walahow/IoT-Fatigue/handoff.md

# IoT-Fatigue Helmet — Session Handoff

## What Was Accomplished
* **Buzzer EMI / I2C Crash Fix**: We successfully resolved the issue where the buzzer's electromagnetic interference (EMI) crashed the MPU-6050 over the I2C bus.
* **Non-Blocking Alert State Machine**: 
  * Replaced the continuous buzzer logic in `main.cpp` with a non-blocking timed state machine.
  * **CRITICAL Alert**: Configured for `2 seconds ON` and `3 seconds OFF` (cooldown).
  * **WARNING Alert**: Configured for `1 second ON` and `3 seconds OFF` (cooldown).
  * **MPU Suspension**: The `mpu.getMotion6()` I2C read is now completely bypassed (`if (g_mpuEnabled && !g_buzzerActive)`) during the exact moments the buzzer is drawing power, guaranteeing no bus crashes.
* **Current State**: The hardware buzzer is currently deactivated in the firmware (`setBuzzerState` always writes `LOW`) so the logic and I2C stability can be tested without the alarm screaming. The firmware was successfully compiled and flashed (`esp32s3cam_sd` environment) to the board.

## Next Steps / To-Do for Next Session
1. **Physical Testing**: Run a fatigue simulation with the helmet on to verify that the MPU I2C bus no longer crashes (i.e. the system does not print `# IMU: [DISCONNECTED]` in the serial monitor).
2. **Reactivate Buzzer**: Once the I2C stability is confirmed, edit `setBuzzerState(bool active)` in `main.cpp` (around line 710) to restore the `HIGH` output so the audible alarm works again.
3. **Hardware Mitigation (Optional)**: If the software workaround feels limiting, solder a flyback diode (e.g., 1N4148) across the buzzer pins or use an NPN transistor driver to electronically isolate the buzzer's noise from the ESP32 power rails.
4. **Tune Durations**: Monitor if the 3-second cooldown duration provides enough time for the Fuzzy Logic (`Risk Score`) to drop back below 70% if the user wakes up. Adjust `COOLDOWN_DURATION` if necessary.
