walahow/IoT-Fatigue/docs/claude-handoff/lab-notebook.md

# IoT-Fatigue lab notebook (Claude memory, verbatim)

Detailed findings Claude saved across sessions, 2026-09-18 → 2026-09-25. Later paragraphs in a section supersede earlier ones. The summary lives in ../../GEMINI.md.

---

## session-101-blink-baseline

Session 101 (different rider from [[eyeglasses-sessions-102-104]], no glasses, 9.4 min, ~12 fps, 320x240): eye clearly visible at roughly x 205-295, y 25-205.

Hand labels (checked 2026-09-19), frame indices into frames/ sorted by int timestamp, window 1445-2179 (t=120-180 s): blinks at 1472, 1510, 1564, 1580, 1597, 1608, 1622, 1659, 1680, 1742, 1747, 1911, 1920, 1953, 1960, 2011, 2177 (17/min). Ambiguous/excluded: 1602, 1808, 1884 (partial), 1543, 1829 (exposure blackout). 13 of 17 show only ONE fully-closed frame.

Firmware GlintBlinkDetector logged 6 blinks for the whole session (only 18 glint-gap candidates; MIN_ABSENT_FRAMES=2 also fights 1-frame closures).
Hand-crafted PC cues (dark fraction, template diff, contrast) topped out ~9/17 recall.
HOG (32x64, OpenCV) + linear SVM via cv2.ml, 4-fold contiguous-time CV: 16/17, 0 FP. Applied to rest of session: 18.5/min, but spot check of 24 detections ~70% real; false positives = squints (narrowed eye) and a helmet adjustment. Prototype scripts were in session scratchpad only (not committed).

Full-session hand labels (2026-09-19) saved in sessions/session_101/blink_labels.csv (timestamp_ms, frame_idx, state = open/closed/squint/unsure): 71 blinks, 557 unsure frames (dark exposure, hand adjustments, half-closures). Labels were corrected once after reviewing SVM disagreements (both FPs and misses), which biases scores toward the model. 5-fold contiguous CV at th=0.5: 93% recall / 97% precision after correction (84%/81% before). But 17 detections fire inside the 0.77 min of unsure footage, so deployment needs a brightness/disruption gate.

Firmware port (2026-09-19, uncommitted at time of writing): HogBlinkDetector + hogFeatures/boxResample/hogCropRect in src/EyeBlinkEAR.h (8 native tests), session_replay --hog-dump/--hog-model/--hog-csv, python/train_blink_classifier.py (end-to-end CV through session_replay). Plain C HOG (no histogram equalisation, (R+G+B)/3 gray) on 101: threshold 0.25 -> 91% recall / 89% precision held-out; model at sessions/session_101/blink_model.bin. Wired into main.cpp the same day: runs alongside glint, prints "#STATUS: blink (hog) t= score=", did not drive blink_rate at first -- SINCE 2026-09-21 it DOES (g_earHogRate 60 s window -> g_onDeviceBlinkRate; glint kept as log-only comparison). Weights in firmware/src/BlinkWeights.h (generated by train script). frame_inject_replay.py got --hog-out. All esp32 envs build. Of 17 events in unsure footage ~9 were real partial closures, ~5 junk; whole-frame brightness does NOT separate them, so no gate built.

Recording simulation (2026-09-19): tools/session_replay/sensor_sim.cpp runs the 1 Hz loop (baseline HR + FuzzyFatigue.h) on recorded sensor rows; reproduces session_101's recorded risk/alert on 550/552 rows with --baseline=86 (ESP baseline forms during arming). Recorded 101: blink_rate 0-1 all ride -> CRIT 245 s / WARN 76 s. With classifier (ROI pinned 254,126): blink 9.5/min, SAFE/W/C 155/270/127; with hand labels 131/299/122 -> classifier ~equals perfect detection. Remaining alerts come from rider's real riding blink rate ~7/min (FIS "Low" < 8), nod_score>0 in 231/492 s, HR below arming baseline -- FIS calibration is the next bottleneck, not blink detection.

Measured on real ESP32-S3 (N16R8 devkit, no camera, frame-inject build, 2026-09-20): HOG classifier 7.7 ms/frame median (p90 7.9); decode+EAR 61.6 ms median. Motion lock landed at x=230 y=102, identical to PC replay. Device found all 8 PC blinks in the first 500 frames at identical timestamps, plus 2 extra in dark "unsure" frames; per-frame scores differ from PC by up to 0.52 (different JPEG decoder: esp_jpg vs stb_image), so near-threshold frames can flip. Full-session device run (6834 frames, 31 min): device caught 69/70 labelled blinks with 5 false alarms — identical to the PC replay's own score; 84 detections on identical frames, 10 device-only, 7 PC-only (mostly in unsure footage). NOTE that 99% is in-sample (weights trained on this session); held-out CV remains 91%/89%. Results kept in sessions/session_101/blink_classifier/esp32_hog_blinks.csv. Frame injection needed Serial.setRxBufferSize(16384) before Serial.begin() under FRAME_INJECT_MODE (default 256 B CDC buffer dropped mid-frame bytes) and chunked host writes; frame_inject_replay.py used PIL (not in requirements) -> switched to cv2.

Stored eye coordinate (2026-09-20, user's idea): PC picks the eye centre, firmware keeps it in NVS and applies it on frame 1 instead of the ~20 s motion search. Serial `ROI:<cx>,<cy>` / `ROI:auto`; precedence EAR_ROI_MANUAL_X/Y > stored > motion lock; metadata.txt gets roi_source/roi_x/roi_y/roi_size. Set by clicking the eye in live_ear_preview.py --arm. Verified on the bare S3: coordinate survived a reflash to a different build, applied as x=230 y=102 (same spot motion lock found), and detected the one labelled blink in the first 150 frames (frame 95) which the motion path would have missed.

**Why:** user wants consistent PC-side blink detection before worrying about ESP32 fit.
**How to apply:** next lever is more labels (~5 min incl. squint negatives) and per-rider calibration; HOG+linear SVM is also cheap enough (~756-dim dot product) for ESP32 later.

---

## eyeglasses-sessions-102-104

Sessions 102-104 (recorded ~2026-09, outdoor ride) — rider wears eyeglasses. Camera looks *through* the lens from below/outside: lens rim crosses the frame, eye is a blurry ~60x60 px patch in the top-right of a 320x240 frame (metadata claims 640x480 but video.mjpeg is 320x240), overlaid by blue sky reflection. On-device detector logged 22/16/12 blinks over whole sessions (~100x too few).

Checked 2026-09-19: strongest blink-shaped events in the eye ROI (red-minus-blue spikes) were reflection/camera shifts, not eyelids. Conclusion given to user: no PC algorithm can recover it; fix is hardware — camera between lens and eye (not through lens), refocus the OV2640 lens for close range, 850/940 nm IR LED + NoIR sensor + IR-pass filter (kills visible sky reflections, like car driver-monitoring cameras). Then a small CNN open/closed classifier on eye crops (MediaPipe won't work: needs a full face).

**Why:** user asked whether PC-powered processing could fix blink detection for eyeglass wearers.
**How to apply:** if blink work resumes on glasses footage, check the new mount's frames first; don't tune thresholds on 102-104 footage.

---

## alert-labels-sessions-101-104

Checked 2026-09-21. In all four sessions the recorded alert is fully explained by two inputs, not by fatigue:
- blink_rate==0 & nod==0 -> risk 0 / SAFE (97-100% of rows); blink_rate==0 & nod>0 -> CRITICAL (97-100%); blink_rate>0 & nod==0 -> WARNING 50 (74-88%).
- Root cause: `mf_blink_Low` = `_ftrap(v, 0,0,4,8)` and `_ftrap` returns 0 for `x <= a`, so blink=0 gives Blink_Low=0 (blink=0.01 gives 1.0). No rule fires -> centroid fallback risk 0. Same boundary in python/fuzzy_model.py. The rolling rate is integer-valued and ~0 (detector misses ~all blinks), so it sits on the hole. Other left-shoulder MFs (hr_Dropped) use -1e9 and are fine; gyro_Stable(0) has the same latent issue.
- nod_score>0 in ~50% of rows in every session (incl. no-glasses 101): ZCR is easy to hit on riding jitter, slope>0 gate is a coin flip; R3 maps nod straight to Critical. 324-414 CRITICAL onsets/hour (buzzer every ~10 s).
- Session 104 vs self-report ground truth (sessions/session_104_ground_truth.xlsx, 3 blocks 0-10/10-20/20+ min): Critical share 49/40/36% (falls as fatigue "rises"), non-safe 65/71/70%, HR flat ~81, blink mean 0.18/0.37/0.46 — alerts do not track phase.
- 103 was armed_eye=0 yet blink_rate is nonzero ~55% of rows -> those counts are not blinks.

FIXED 2026-09-21 (uncommitted): blink_Low left edge -> -1e9 in FuzzyFatigue.h and -1e6 in fuzzy_model.py; Python and C++ (sensor_sim on 104) agree. Effect on 104: SAFE/WARN/CRIT 0/1524/314 s (was 578 safe) -> a dead blink detector now means permanent Warning, so blink input needs an "unreliable/unknown" state. Agreed plan still to do: nod-detector check, then dwell gate (Warning ~5 s, Critical ~8-10 s, ~3 s release hold, ~30 s buzzer cooldown after Critical, log raw alert_level + new alert_gated column).

BLINK-UNKNOWN DONE 2026-09-21 (uncommitted, all firmware envs build): FuzzyFatigue::update(..., bool blink_valid=true) zeroes bL/bN/bH so R1,R2,R4,R6,R7 drop out (Python fuzzy_model.py same). main.cpp computes g_blinkValid = PC-fed BLINK: OR (SD/EAR_LIVE_DEBUG: !g_earDisabled && >=60 s since first frame after ROI lock (g_earValidSinceMs) && frame within 3 s (g_earLastFrameMs)); prints "#STATUS: Blink channel OFFLINE -- reason" on change; new trailing CSV column blink_valid (19th; older sessions NaN/unknown, handled in merge_session.py, label_session.py, session_review_video.py, sensor_sim.cpp, README). Plain USB mode without BLINK: feed keeps the 13.0 stub and counts as valid. Replay of 101-104 with blink offline: Safe ~46-50%, Critical 45-53% (all nod-driven R3) -> nod detector is the next fix. Limits: glasses sessions 102-104 would be offline only ~4-12% (glint baseline forms at 22-81 s, glare looks like glint); 101 offline ~60% (baseline only at 278 s). session_summary.py not updated (its COLS length gates row parsing). Native tests: 2 glint tests fail (test_glint_blink_counted_on_recovery, ..._rolling_rate_evicts_old_blinks) — in EyeBlinkEAR WIP, not from this change.

HOG DRIVES blink_rate 2026-09-21 (option 1; uncommitted, 5 firmware envs build, not yet run on hardware): main.cpp processEarFrame pushes g_earHog events into g_earHogRate (BlinkRateWindow) -> g_onDeviceBlinkRate; glint only logs; armingBegin clears the window. PC replay of sessions 101-104 with the session_101 model (motion lock) + 60 s gate + fuzzy model: 101 = 9.6 blinks/min, alerts S/W/C 30/46/24; glasses sessions collapse: 102 0.8/min (3/92/5), 103 0.6/min (6/65/29), 104 2.8/min (8/76/16) -> blink_valid stays 1 (~91-96%) so glasses riders sit in permanent Warning. Proposed, not built: arming-time blink-count check (expect a handful of blinks in the ~20-60 s arming window, else mark the channel unreliable for the session) + per-rider labels/weights.

ROUND 3 DONE 2026-09-21 (uncommitted; 5 firmware envs build; native: test_nod_alert 18/18 pass; 2 glint tests in test_eye_blink_ear fail, pre-existing): (1) Option A arming eye check in main.cpp: EyeCheck PENDING/PASS/FAIL, PASS = >=3 classifier blinks within 30 s of ROI lock, FAIL latches for the session -> blink_valid=0; arming waits until it resolves (pass OR fail); metadata eye_check + eye_check_blinks; #ARMING line shows blinks x/3. Session data: 101 = 12 blinks/30 s (pass), 102/103/104 = 0/0/2 (fail). (2) NodDetector moved to src/NodDetector.h and rewritten: swing >=10 deg, Schmitt band = swing/4, >=3 alternations (one glance = 2), score=min(alt/6,1), slope gate removed. Evidence: old score fired ~50% regardless of swing size (pitch is from the accelerometer so vibration/bumps look like swing; slope sign random; any non-zero nod = Critical because the Critical centroid ignores clip height). UNVALIDATED on real nods: all recorded sessions are 1 Hz and have no labelled nods; needs a deliberate-nod recording. (3) src/AlertGate.h: Warning dwell 5 s, Critical 8 s, release hold 3 s; buzzer follows g_alertGated; Critical beep -> 30 s cooldown (Warning 3 s); CSV col 20 alert_gated (alert_level stays raw); sensor_sim/merge_session/label_session/session_review_video/README updated. Replay 101-104 (HOG blink + eye check + gate): with nod silent, glasses sessions ~98-100% Safe; 101 gated 60/40/1; with the OLD recorded nod, gated Critical still 16-18% on glasses sessions. Remaining: real-nod validation, FIS blink Low (<8) vs riding blink rate ~7/min in 101 (40% Warning), per-rider blink weights.

ROUND 4 DONE 2026-09-21 (uncommitted; 5 envs build; native 55/57 pass, same 2 pre-existing glint failures): blink Low. Findings: session_101 hand-labelled truth = 71 blinks / 9.4 min = 7.5/min, per-minute 15,6,17,5,4,8,10,2,2; rolling-60s count <8 for 56% of the time, <4 for 32%; Poisson noise alone makes a true-9/min rider read <8 in 32% of 60 s windows. Doc sources: IICIP 2016 driving baseline 8-10/min, fatigued 4-6; Divjak 18 vs 8. Old Low MF (0,0,4,8) hit zero exactly at the alert driving baseline. Changes: (1) device blink_rate = 3-min smoothed rate (BlinkRateWindow::smoothedBpm, window = elapsed since lock, floor 60 s; buffer 60->128 timestamps, old cap made rate <=20/min); (2) Low MF -> (-inf,-inf,3,7) in FuzzyFatigue.h + fuzzy_model.py + fuzzy_walkthrough.md. Replay 101 (HOG blinks, nod silent, after 60 s): window 60->180 s took Warning 45%->16%; MF change alone is small (+2 pts Safe); Low 2-5 broke the doc scenario Ph4 so rejected; 7-phase scenario unchanged (0,1,0,1,2,2,0). Caveat: rider 101 truly blinks ~7.5/min riding, i.e. inside the literature fatigued band, so an absolute threshold cannot fit them; needs fatigue-labelled blink data and/or a per-rider baseline (literature quotes relative drops of 40-56%). R6/High is diluted by the 3-min average.

HARDWARE TEST 2026-09-21 (esp32s3cam_sd flashed to the full helmet on COM3; session_109 = unattended junk, session_110 = live test, both on the SD card): arming worked end to end -- motion lock in ~20 s (x=194 y=110 conf 2.54), Eye check PASSED at 18 s after lock (3 blinks), Blink channel ONLINE at lock+60 s, recording started at 38 s (timed_out=0), gate turned 29 raw non-safe seconds into 6 gated. HOG counted 14 blinks in 110 s (7.6/min, screen-viewing rider), glint 4. New nod detector: 1 of 153 ticks non-zero (seated). Problems found: (a) HR baseline (96.6 BPM) formed from the first 20 valid samples while the pulse settled 119->78, so later 75-95 BPM read as -10..-22% = HR Dropped -> R2 raw Critical; (b) FIS output ignores rule strength: R2 at Low=0.15 still gave risk 85 (clipped shoulder centroid) -> needs an alpha-cut (min firing strength ~0.2-0.25) or different defuzzification; (c) pulse readings jump 72-119 (contact). SD contents (metadata eye_check, CSV cols 19/20) NOT yet inspected.

ROUND 5 DONE 2026-09-21 (uncommitted; 5 envs build; native 66/68, same 2 pre-existing glint failures; new tests/test_fis_hr 11 pass; NOT yet flashed): (1) src/HrBaseline.h: baseline = median of 20 valid readings after skipping the first 10 (needs 30 valid s; #ARMING hr=(n/30)); replaces mean of first 20. A "wait until readings agree" gate was rejected: recorded worn sessions 101-104 have a median 20 s HR spread of 21-28 BPM, same as the unworn test (27) -> it would never open; also means the recorded HR channel looks noise-dominated (needs raw-PPG/ECG check). (2) FIS alpha-cut: rules below 0.25 firing strength count as not firing (FIS_MIN_FIRING in FuzzyFatigue.h, MIN_FIRING in fuzzy_model.py); all-cut -> existing Safe fallback. Hardware-log replay (sensor unworn, HR = noise): raw alerts after blink online Safe/Warn/Crit 56/12/6 -> 73/0/1 (the 1 = nod 0.5). Findings: user forgot to wear the HR sensor during session_110; firmware still produced "valid" 72-119 BPM and formed a baseline -- floating ADC passes the SIGNAL_LOW/HIGH window and MIN_AMPLITUDE=20; a real loose-contact moment would give phantom HR. Not fixed (needs bench data on real PPG amplitude vs noise floor).

HARDWARE TEST 2 2026-09-21 (round-5 firmware + blink_events.csv flashed; session_112 on the SD, sensor worn this time): motion lock x=202 y=130 conf 2.00 (borderline; test 1 was 194,110 conf 2.54), 0 HOG and 0 glint blinks in 225 s, Eye check FAILED (0 blinks in 30 s) -> blink channel offline all session, arming timed out at 61 s with hr=0. HR: 30 valid readings needed, only 149/228 ticks valid (34-92 BPM, many dropouts), baseline formed AFTER recording started at 55.4 BPM (too low: later 76-89 BPM read +38..+61%) -> HR contact/placement still poor even when worn. Gate worked (1 raw Critical from nod 0.5 -> gated safe). Unknown why no blinks (eye not toward camera / camera moved / bad ROI); SD card not yet read (need blink_events.csv, metadata, frames).

PREVIEW TEST 2026-09-21 (esp32s3cam_ear_preview flashed, live_ear_preview.py --arm, user clicked the eye repeatedly, ~4.5 min): eye ROI at cx=199 cy=150 (stored x=175 y=126) gave READY TO RECORD (blink test 14 of 10, exposure 60, 1 false alarm) but crop margin 0 px; cy=152 -> crop margin -2 px (90x180 classifier crop hangs off the bottom of the 240-px frame) and blink test 6 of 10 -> the eye sits too LOW in the frame; aim the camera so the eye centre is ~y 100-130 (session 101 pinned ROI was 254,126). Wrong clicks (x~105-138, y 37-109) gave exposure 29 / 4 of 10. User pressed A at the end -> stored ROI CLEARED (ROI:auto), board still has the preview firmware. HR: value 118 repeated for 11 s = 8-beat average interval ~508 ms = MIN_BEAT_INTERVAL (500 ms) refractory limit -> beat detector was noise-triggered; baseline formed at 114.4 from that, true resting ~65-75. Small bug: ROI:auto / ROI:x,y do not reset g_earValidSinceMs / g_earBlinksSinceLock / g_eyeCheck, so OFFLINE says "no frames processed" instead of "no eye lock" and the eye check does not restart.

HARDWARE TEST 3 2026-09-21 (round-5 SD firmware, no preview running, stored ROI still cleared from the previous preview test): session_114, 235 s. Both readiness checks failed: IMU calib never completed the whole session (needs 200 consecutive still samples = 2 s with |A| in 0.85-1.15g and gyro within 20 dps of its running mean; rider was moving/adjusting the whole time) -> "Recording -- imu=0" (falls back to the boot-time gravity vector, so pitch/gyro_var are not garbage, just not per-session). Eye motion lock only succeeded once, at t=224s (i.e. during RECORDING, 11 s before the session ended, not during the 60 s arming window), landing at y=155 -- too low again (same finding as the preview test), conf=1.73 (below the 2.0 accept bar, took it via the 13-try fallback). Zero blink events (hog or glint) the entire session -> Eye check never resolved, blink channel offline throughout. HR baseline DID form well this time: 72.7 BPM, plausible resting rate, 30/30 valid readings -- the HrBaseline fix looks right when contact is good. Conclusion: needs the stored ROI (via live_ear_preview.py --arm, not yet redone since it was cleared) before another SD-only arming attempt is worth running, and the rider needs to hold genuinely still for ~2 s during arming for IMU to lock.

HARDWARE TEST 4 2026-09-21 (stored ROI x=195,y=124 set via live_ear_preview.py --arm, READY TO RECORD both runs; then esp32s3cam_sd reflashed): session_115, 235 s -- everything mechanical worked. ROI applied from frame 1 (no search). IMU calibrated cleanly, 0 motion restarts. Eye check PASSED almost instantly (3 blinks in 3 s -- rider blinked rapidly to clear it fast). HR: arming timed out at 61 s with hr=0 (needs 30 valid readings, contact was fine -- 0 "NO CONTACT" ticks all session -- just slow to accumulate); baseline formed properly DURING recording at 68.7 BPM, a believable resting rate. Blink channel: 119 classifier blinks + 6 glint blinks logged; rate spiked to 30-38/min because of the rapid blinking during the eye check, and the 3-min smoothed rate (BlinkRateWindow::smoothedBpm) took ~150 s of real time to dilute it back down past 24 (Blink_High) -- this is the smoothing working as designed on a burst at the START of the window, not a bug, but it means a fast deliberate blink burst near t=0 gives ~2.5 min of R6 Warning afterward. Gate: raw/gated tally {safe/safe:118, WARNING/WARNING:78, WARNING/safe:29 (brief raw blips under the 5s dwell), safe/WARNING:12 (brief raw dips inside the 3s release hold), CRITICAL/WARNING:1 (one raw Critical blip fell back to gated Warning, not enough for the 8s Critical dwell)} -- matches the test suite's documented behaviour exactly. Conclusion: recording pipeline (ROI/IMU/eye/blink/HR/gate) is now working end to end; remaining known gaps are the nod detector (still unvalidated) and per-rider blink calibration.

SESSION 116 (first real ride on round-5+ firmware, 2026-09-22, sessions/session_116, 19.3 min, armed_imu=1 armed_hr=0(timed out, formed later) armed_eye=1 eye_check=pass roi_source=stored 195,124): contact 100%, imu_valid/blink_valid 100% throughout (blink warms up during arming now that the ROI is stored, so the recorded CSV -- which only starts at RECORDING -- sees it already online). blink_rate opened at ~25/min (arming-blink burst, same artifact as hardware test 4) and decayed over ~8 min to a 5-9/min riding baseline, dropping to 2-4/min in the final ~2 min (unclear if real fatigue or ride ending / helmet coming off -- no video check done). 166 blink events (156 hog/10 glint). HR mostly 62-91 BPM/min-median but one whole minute (~t300-360s) medianed 49 and 4 rows read 30-37 -- looks like a sensor-contact wobble, not physiological. Raw alert Safe/Warn/Crit 41/42/18%; gated 51/44/5.4% -- gate cut Critical from 18% to 5.4% as designed. CONCRETE NEW EVIDENCE the nod detector still false-positives on road bumps, not just big swings: at t=254-256 gyro_var hit 2500-4000 (a clear bump) and nod_score hit 1.0 in the same window; several other gated-Critical clusters (t=739-752, 87-91) show nod_score>=0.5 coincident with gyro_var in the hundreds-to-thousands. The Schmitt-trigger alternation the redesigned NodDetector counts is apparently still tripped by a sharp bump's pitch transient, not just by real head-drop. Next tuning step: gate nod_score on gyro_var being LOW (analogous to limp_drowsy already requiring gyro_Stable) so a bump can't masquerade as a nod.

GYRO-GATED NOD FIX DONE 2026-09-22 (uncommitted, 5 firmware envs build, native test_fis_hr still passes, same 2 pre-existing glint failures): FuzzyFatigue.h/fuzzy_model.py -- nod_trusted = min(nodding_score, gyro_Stable), IMU_Drowsy = max(limp_drowsy, nod_trusted) [was raw nodding_score]. Same gate limp_drowsy already used. Verified on session_116 with sensor_sim: the two bump clusters caught on video (t=254-256s gyro_var 2500-4000, t=1039-1050s gyro_var 900-3400) both fully flip from gated Critical -> gated Safe; session-wide raw Critical seconds 202->164 (-19%), gated Critical 61->43 (-30%), other levels roughly unchanged. Not yet flashed/hardware-tested. Caveat: gyro_Stable ramps 400-800, so a MODERATE bump (gyro_var 400-800) only partially discounts nod (e.g. the t=1136 cluster at gyro_var~550 -> gS~0.6, not fully gated) -- expected, matches limp_drowsy's existing behavior, not a new gap.

VIDEO REVIEW TOOLING 2026-09-22: unpack_session.py works on session_116 (12665/12665 frames, 0 CRC fails). Found and fixed a real bug in python/frames_to_mp4.py: the avc1->mp4v codec fallback (line ~340) opened the fallback VideoWriter at (out_w,out_h) while every write() call sends (out_w, out_h+hud_h) when --overlay-data is on -- silent frame-size mismatch, produces a corrupt/empty file. Fixed to size the fallback writer the same as the first attempt. This environment has no working avc1/OpenH264, so `--codec mp4v` must be passed explicitly (the auto-fallback path works now too, but avoid the wasted first attempt). Also: frames_to_mp4.py's load_session_data() does plain pd.read_csv() on sensor_data.csv with no header= -- headerless SD sessions need a dataset_merged.csv (or headered copy) written first, or the HUD reads garbage column names silently.

MOTION-BASED DRIFT CORRECTION BUILT 2026-09-22 (uncommitted; all 5 firmware envs + -DEAR_PROFILE build succeed; native tests unaffected, same 2 pre-existing glint failures): main.cpp earDriftTick(), replacing the disabled Otsu/centroid drift check. Design: reuses EyeBlinkEAR::MotionLocator (the SAME motion-energy boot-lock algorithm, already validated) scoped to a small window (ROI+30px margin, 108x108) instead of the whole frame, plus the v4 glint-refine scratch buffers -- both idle once g_earLockDone, so net new static memory is one uint8_t enum (EarDriftState), not a second ~28.8KB locator instance. Also DELETED g_earMaskBuf, a 320x240=76.8KB PSRAM buffer that was only ever used by the old drift check and had become dead weight. Cycle: reset+accumulate every processed frame for one EAR_V3_WINDOW_MS (18s, reused unchanged from the boot lock) window; on completion, apply the correction ONLY if confidence >= EAR_MOTION_MIN_CONF (2.0, also reused), else discard and start a fresh cycle -- an unconfident cycle now leaves the ROI alone instead of the old code's "darkness always finds something" behaviour. Logs "#STATUS: EAR drift corrected x=.. y=.. conf=.." on change. Added drift= to both #PROF (SD/USB, 40-frame batched) and #FRAME_DONE (frame-inject, per-frame) profiling lines (g_earProfDriftUs) so the added per-frame cost (drift now runs continuously, not once per session like the boot lock) is measurable on real hardware, not just assumed -- NOT YET MEASURED. Found prior art while investigating: .worktrees/on-device-blink-detection (an older, still-checked-out branch) has an abandoned burst-median+two-candidate-agreement variant of the SAME darkness-based approach (session_replay.cpp only, never reached main.cpp) -- shares the same root flaw (hair is MORE stable than a blinking eye, so agreement-based filtering favours hair, not against it); not reused. CLAUDE.md's Known Limitations table and Next Steps checklist updated to match. UNVALIDATED end-to-end: no ride has been recorded with this code running yet -- next hardware step is exactly that, then check "#STATUS: EAR drift corrected" lines against the video the way session_116 was checked by hand, and an -DEAR_PROFILE build's drift= timing.

DRIFT CORRECTION VALIDATED AGAINST REAL FOOTAGE 2026-09-22 (host tool tools/session_replay/drift_test.cpp, new file, transcribed from main.cpp's earDriftTick -- NOT session_replay.cpp itself, whose own boot-lock/drift code had already drifted out of sync with main.cpp and was left alone rather than reconciled): ran the new drift logic starting from session_116's real stored ROI (195,124,48) across all 12665 real extracted frames, no live hardware needed. Result: 63 x 18s cycles, 6 corrections, 57 "not confident" (left alone, matches the fail-safe design). Trajectory: 18s->(219,146), 236s->(212,134), 400s->(212,125), 708s->(231,102), 1089s->(219,84), 1107s->(227,81) -- this tracks the SAME rightward/upward drift found by hand earlier, arriving at x~227-231 right around t~700-810s, matching the t=810s frame where the fixed box was found visually wrong. Drew both boxes on the real t=810s frame: old fixed box (174,58,90,180) covers only the left half of the eye (matches the user's screenshot complaint); new corrected box (210,36,90,180, from roi 231,102) covers the eye properly. This is the strongest evidence yet that earDriftTick() does what it was built for. Still not run live on hardware (no #EARDRIFT heartbeat / timing seen for real, no -DEAR_PROFILE drift= measurement taken) -- replay proves the algorithm, not the on-device execution.

DRIFT CORRECTION CONFIRMED ON REAL HARDWARE 2026-09-22 (frame injection, esp32s3cam_frame_inject flashed to the real ESP32-S3-CAM on COM3, python/frame_inject_replay.py extended to surface #EARDRIFT/drift-corrected lines and drift= timing, which it silently dropped before): fed the real chip session_116's first 2000 recorded frames (~183 s of session time) via USB, ROI seeded from the session's own stored coordinate (195,124) -- needed a firmware fix first, earLoadStoredRoi() was gated to STORAGE_MODE_SD||EAR_LIVE_DEBUG and never ran under FRAME_INJECT_MODE, so injection would have wasted the first ~18s on a fresh boot-lock search instead of testing drift from a known start; extended the guard. Result: EXACT match to the PC-side drift_test.cpp replay -- first correction 195->219, 124->146, conf=2.37, bit-for-bit identical target and confidence; 10 total 18s cycles in the 2000 frames (1 corrected, 9 not confident), same count and same single-correction pattern the PC replay showed for the same time range. HOG blinks fired at the exact same timestamps (76659, 78085, 85900, 87725...) as the original real-time recording's blink_events.csv. Zero frame errors/resyncs over 2000 frames. On-chip timing: decode+EAR median 78.4 ms p90 79.0 ms; HOG classifier median 9.0 ms; DRIFT CORRECTION median 8.7 ms p90 8.8 ms -- the number that answers "does it fit": comparable to the HOG classifier's own cost, not a dominant new expense. This is the strongest validation yet: same algorithm, same real footage, same result on PC and on the actual chip. Tooling note: frame_inject_replay.py's "ROI locked" summary field stays "no" here since it only recognizes the boot-lock's "motion-locked" message, not the stored-ROI path -- cosmetic, not fixed. Only the first ~183 s tested; the bigger correction found earlier (t=708s, roi->231,102) has NOT been confirmed on real hardware yet, only in PC replay.

CORRECTED-FIS REVIEW VIDEO 2026-09-22/23 (uncommitted artifacts, sessions/session_116/session_116_review_corrected.mp4): combined the two hardware-validated data sources with the corrected FIS math, since full on-device FIS replay of a historical session is not possible -- FRAME_INJECT_MODE only replays camera frames, loop()'s 1Hz IMU/HR/FIS path is NOT gated by it and reads whatever sensors are live on the bench at injection time, not the recording's history; there is no sensor-injection mode. Built instead: (1) blink_rate from the REAL chip-detected HOG blinks (both injection runs' hog-out CSVs combined, 201 blinks, fed to sensor_sim via --blinks=) rather than the original recording's blink_rate column; (2) HR/IMU from the session's own recorded sensor_data.csv (only available source); (3) drift-corrected ROI per frame from drift_test.cpp's PC replay (already 1px-matched to real hardware injection). Result via sensor_sim: HR baseline 86.0 (median of rows 11-30), mean blink_rate 10.7/min, gated Safe/Warn/Crit 658/441/29 s = 58.3/39.1/2.6%. Video built same way as session_116_review_newfw.mp4 (frames_to_mp4.py --overlay-data, dataset_merged.csv rebuilt) but HUD numbers are now this corrected/chip-blink run, not the original firmware's recorded values.

**Why:** user asked to look at the alert/warning/critical labels of 101-104.
**How to apply:** don't treat the recorded alert column as a fatigue label or training target; fix blink_Low(0) and the nod gate (and get blink detection working, see [[eyeglasses-sessions-102-104]], [[session-101-blink-baseline]]) before judging FIS thresholds.

---

## session-116-blink-eval

Session 116 (same rider as 100 per user, no glasses, 19.3 min/12665 frames, ~10.9 fps, same mount/view as [[session-101-blink-baseline]]). Full session now hand-labelled in sessions/session_116/blink_labels.csv (label_ground_truth.py schema, every frame): 96 closed frames / 92 distinct blink events (4.8/min avg, but very bursty: 39 blinks in the first 232s, 4 in the last 232s — real variation, not a labeling artifact, spot-checked with continuous frame sequences), 605 unsure (long occlusions/closures >~500ms, glare, hair-strand crossing, exposure dropouts — excluded from training). Labelled via a transient-score candidate detector (`transient.py`: local self-vs-neighbour-median dissimilarity) + visual confirmation on 7-frame strips, zoom-verified per cluster. Lesson: a compressed 20-wide frame grid causes real misreads (columns get miscounted) — always verify at 7-wide or narrower before calling a frame closed.

**Jitter augmentation shipped** (2026-09-23): `session_replay.cpp --hog-jitter=N,J` dumps N extra HOG-feature copies per labelled frame from the ROI shifted by a random ±J px offset (deterministic per-frame seed), alongside the original. `train_blink_classifier.py --jitter-n/--jitter-px` (default 4,16) passes this through to the `--hog-dump` call powering training; CV/eval paths are untouched. `firmware/src/BlinkWeights.h` regenerated on session_101 alone with jitter on (CV: 61/70 caught, 15 FA, precision 80% @ threshold +0.50). Verified via the real C++ replay (not just the python port) against 116's 3 originally-hand-labelled windows: 17/28 blinks caught at 2.7 FA/min at the drift-tracked box, vs. the pre-jitter shipped model's 12/28 at 4.6 FA/min.

**Naive full-116 pooling makes it WORSE, not better** — tested by 5-fold contiguous CV on all of 116, training each fold on 101(jittered) + the other 4/5 of 116(jittered) vs. 101(jittered) alone:
- 101+jitter only: 39/92 caught (42%), 109 FA (5.7/min)
- +116 other-folds: 15/92 caught (16%), 209 FA (10.8/min) — per-fold breakdown shows near-total collapse (0/23, 0/13, 0/13 caught in three folds) with huge FA spikes elsewhere (81, 98)
- Root cause (not verified beyond this reasoning, no fix attempted): 116's usable frames (~12060, 96 closed ≈ 0.8%) dwarf 101's (~6579, 70 closed ≈ 1.1%) once pooled — the combined set becomes dominated by 116's own appearance statistics, which include long dark/glare/hair-occlusion stretches 101 doesn't have, and the classWeights ratio (1:20, tuned for 101's proportions) isn't retuned for the new mix. This directly contradicts the smaller-scale earlier result (see below) where adding only ~1600 frames from 2 clean/dense-blink 116 windows DID help (12→19-21/28) — that subset was too small and too clean to swamp 101's signal the way the full session does.
- Retuning classWeights to the pooled set's actual pos:neg ratio (instead of the hardcoded 1:20) was tested and does NOT fix it (15/92, 208 FA either way) — ruling out plain class imbalance as the cause. The collapse is near-total in some folds (0/23, 0/13, 0/13) even where the held-out fold is mostly clean/bright footage (fold 1 ≈ segment 3), so it isn't simply "bad segments poison the pool" either. Reads as a linear-SVM-over-pooled-HOG instability (two sessions' feature distributions fighting the same low-C=0.1 hyperplane), not a one-line fix. Not investigated further: per-condition/segment-only training subsets, higher C, a non-linear classifier.
- Conclusion for now: don't re-attempt naive 101+116 pooling without a real plan for the distribution mismatch. If more data is wanted, prefer collecting additional CLEAN sessions shot like 101 (stable mount, decent light) over trying to fold in 116's heterogeneous footage. A good chunk of 116's difficulty (dark/tunnel-like stretches, glare, hair crossing the lens) is an optics/lighting problem the classifier can't train its way out of — same conclusion as [[eyeglasses-sessions-102-104]] for a different reason.

**Why:** user asked to add jitter to the classifier and hand-label the rest of session_116.
**How to apply:** BlinkWeights.h currently ships 101-only+jitter (the validated improvement) — do NOT naively retrain on 101+full-116 without addressing the imbalance/heterogeneity first, it regresses. If pursuing 116 data next, balance/curate before pooling, and validate the same way (5-fold contiguous CV on held-out 116, real C++ replay for the final check).

---

## same-rider-sessions-101-119-122

Sessions 101, 119, 121, 122 are the same rider (user told me 2026-09-25); only the camera positioning differs a little. 121+122 same day (2026-09-25), 119 the day before, same setup. Sessions 102-104 are the eyeglasses sessions ([[eyeglasses-sessions-102-104]]).

I wrongly called 101 "a different rider" for a long stretch of the 2026-09-25 work; don't repeat that. Poor cross-session transfer (101 model on 119/121/122 ~6-30% recall, pooled 101+others worse) is a crop-alignment/positioning problem.

Key finding: HOG crops must be aligned to the eye. session_replay's own motion lock lands 40-60 px off the eye and differently per session, and the eye drifts ~15 px within a session. Fix: fatigue-helmet/python/make_roi_track.py (template-tracks the eye through a session, writes roi_track.csv; train_blink_classifier.replay() auto-uses it via session_replay --roi-track). 121-based template matches 119/121/122 (corr ~0.6-0.9, scale 1.0) but NOT 101 (corr <=0.5 at any scale) -- 101 is viewed from a different angle/offset (eye ~ (252,100) vs 121's (222,125)) and was never aligned; its old crop (centre 254,126) sits ~25 px below the eye.

Results (aligned, no jitter -- jitter hurts these sessions): pooled 119+121+122 CV F1 0.61 at threshold 1.0; leave-one-session-out F1 ~0.5-0.78. Pooled model is flashed as BlinkWeights.h (threshold 1.0). Pooled 4-session (incl. unaligned 101) F1 0.58. Rider's true blink rate ~4.6-6.6/min, already below the fuzzy model's Blink_Low (<8/min).

**Why:** blink detection quality here is dominated by consistent eye framing, not by who the rider is.
**How to apply:** when adding a session, run make_roi_track.py first; for 101 hand-pick/verify an eye centre with its own template before pooling.

---

## phone-arming-preview

> **Superseded 2026-09-24:** the phone preview was merged into `main` (via `blink-jitter-116-labels`). Later commits turn the helmet Wi-Fi off after arming (`d0bda3c5e`, `15350871a`). The Task 5 bench run below is still not done.

Branch `phone-arming-preview` (22 commits on top of `fatigue-fis-blink-fixes`), kept unmerged by the user's choice on 2026-09-23.

`esp32s3cam_sd` now runs Wi-Fi AP `HELMET-A974` with a page at 192.168.4.1. It shows the arming checklist and the camera with the ESP's eye box, and offers tap-to-set eye, an optional blink test and ARM/ABORT/STOP. Wi-Fi goes off 15 s into recording.

**Why:** the user wanted to see arming readiness on the phone instead of guessing when to start riding.

**How to apply:** before merging or recommending this branch, check whether the Task 5 bench run in `fatigue-helmet/firmware/docs/superpowers/plans/2026-09-23-phone-arming-preview.md` has been done. Its results go in the spec's "Bench results" table. The things to measure are:
- EAR frame rate with the page open (baseline ~12 fps with the page closed)
- pulse noise with Wi-Fi on vs off
- how long `stop()`/`start()` block `loop()`
- memory across rides

Related follow-ups offered as separate tasks: a cross-core EAR ROI race, and 2 glint tests failing in `test_eye_blink_ear` (these fail the same way before this branch).
