walahow/IoT-Fatigue/fatigue-helmet/python/fuzzy_fatigue_simulation.png

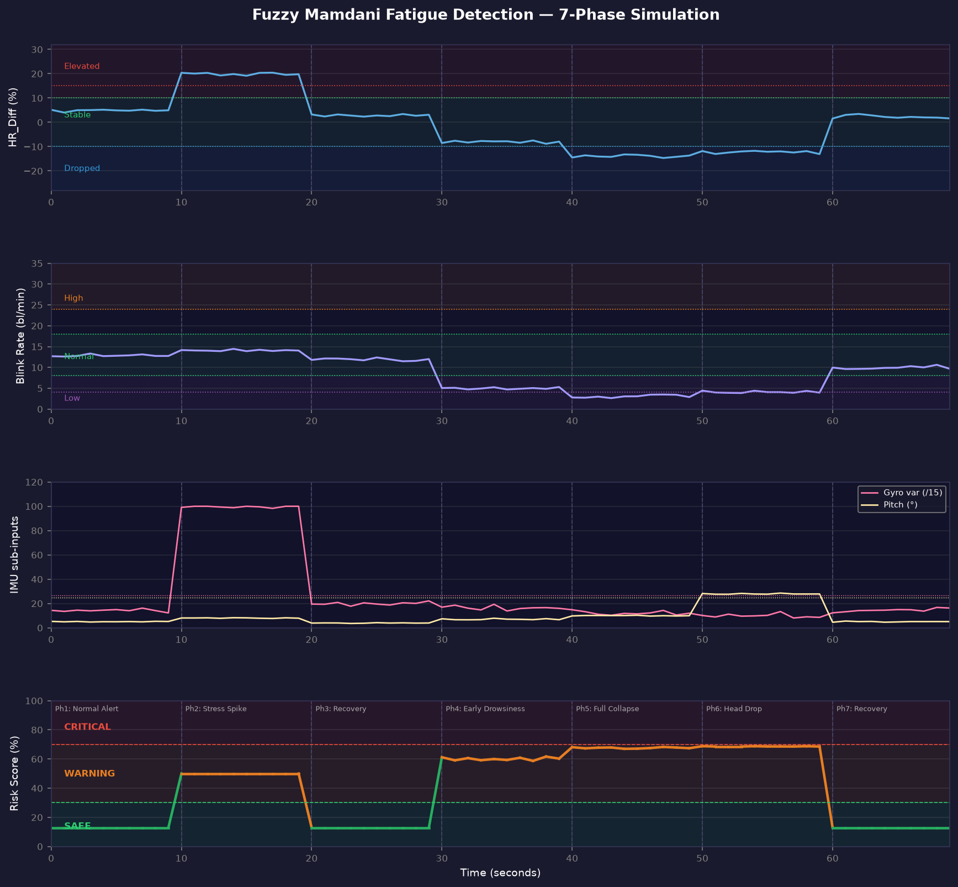
fatigue-helmet/python/fuzzy_fatigue_simulation.png
