walahow/IoT-Fatigue/3D/maybe cace.stl

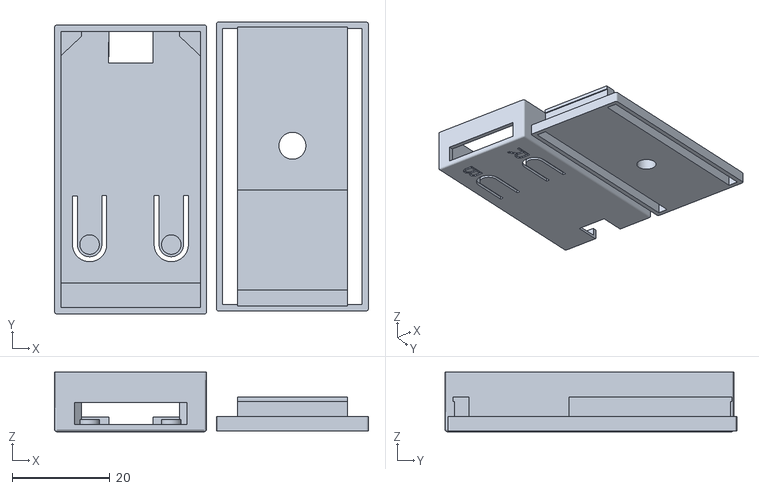
[picture p4: CAD file, 2026-06-13]
3D/maybe cace.stl
64.2 x 59.7 x 12.2
