walahow/IoT-Fatigue/3D/esp32-s3-wroom-cam-board-housing-model_files/esp32-cam-top.step

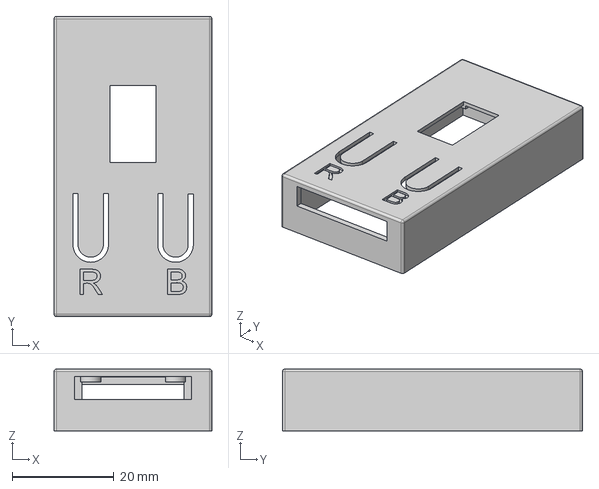
[picture p5: CAD file, 2026-06-13]
3D/esp32-s3-wroom-cam-board-housing-model_files/esp32-cam-top.step
31.1 x 59.1 x 12.2 mm
