walahow/IoT-Fatigue/3D/Untitled.stl

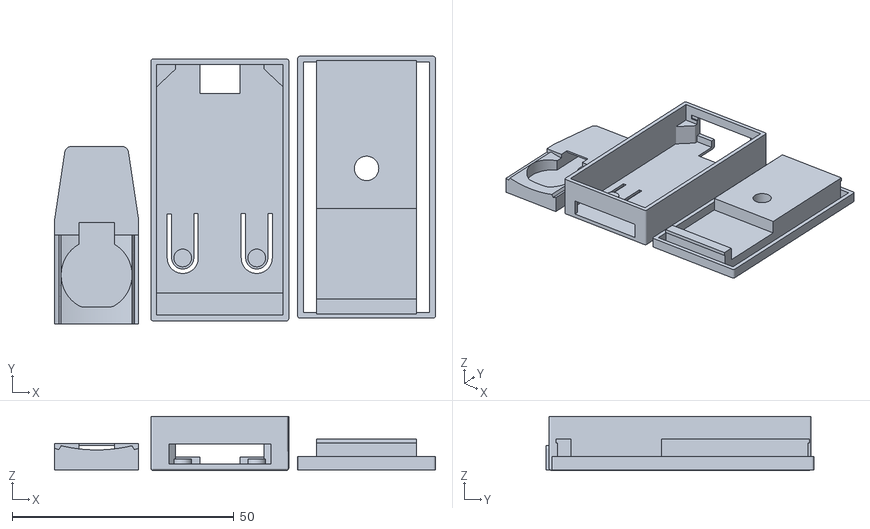
[picture p6: CAD file, 2026-06-13]
3D/Untitled.stl
85.9 x 60.4 x 12.2
