walahow/IoT-Fatigue/3D/ESP32-S3 WROOM cover V2.stl

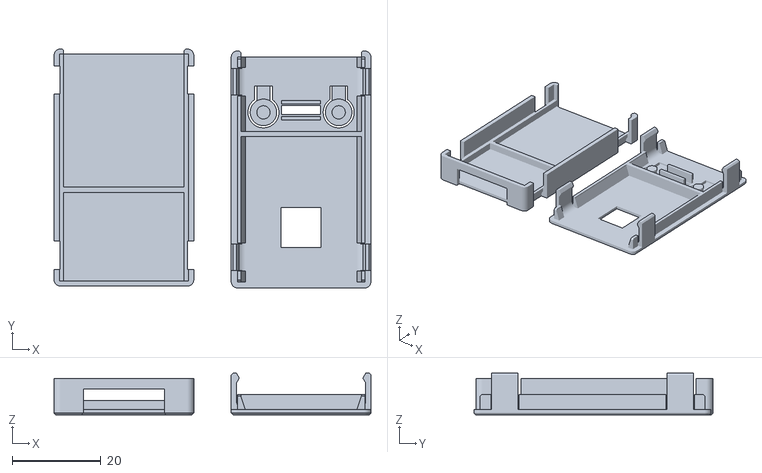
[picture p7: CAD file, 2026-06-13]
3D/ESP32-S3 WROOM cover V2.stl
71.6 x 54.0 x 9.40
