walahow/IoT-Fatigue/3D/PulSensor.stl

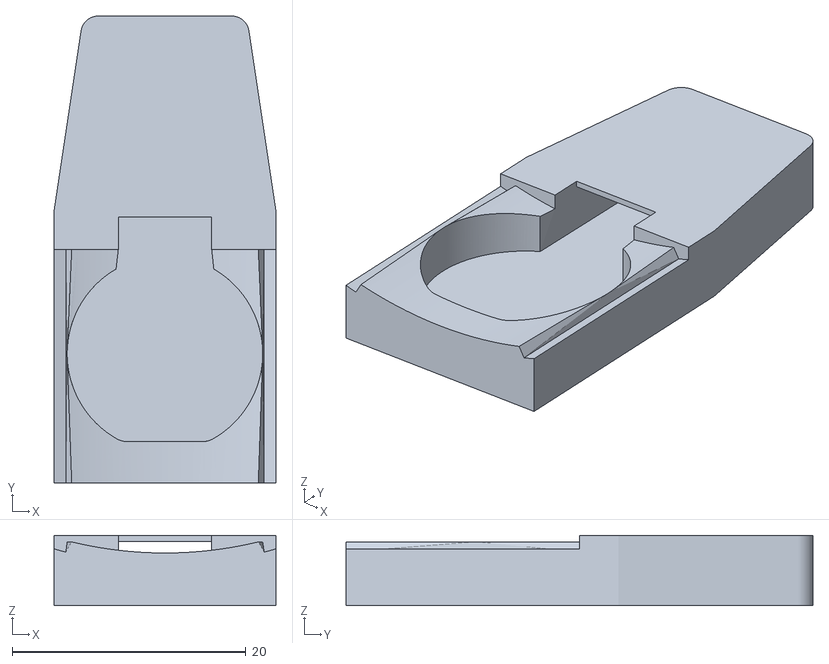
[picture p8: CAD file, 2026-06-13]
3D/PulSensor.stl
19.0 x 40.0 x 6.00
