walahow/IoT-Fatigue/(list of files, cad)

Other CAD files:
3D/Untitled.blend
3D/esp32-s3-wroom-cam-board-housing-model_files/esp32-cam-bottom.stl
3D/esp32-s3-wroom-cam-board-housing-model_files/esp32-cam-top.stl
