walahow/IoT-Fatigue/3D/esp32-s3-wroom-cam-board-housing-model_files/1244536-esp32-s3-wroom-cam-board-housing-4d0b5be8-0231-4a4d-9304-6feeb11bb0f3.pdf

## ESP32-S3-WROOM CAM Board Housing

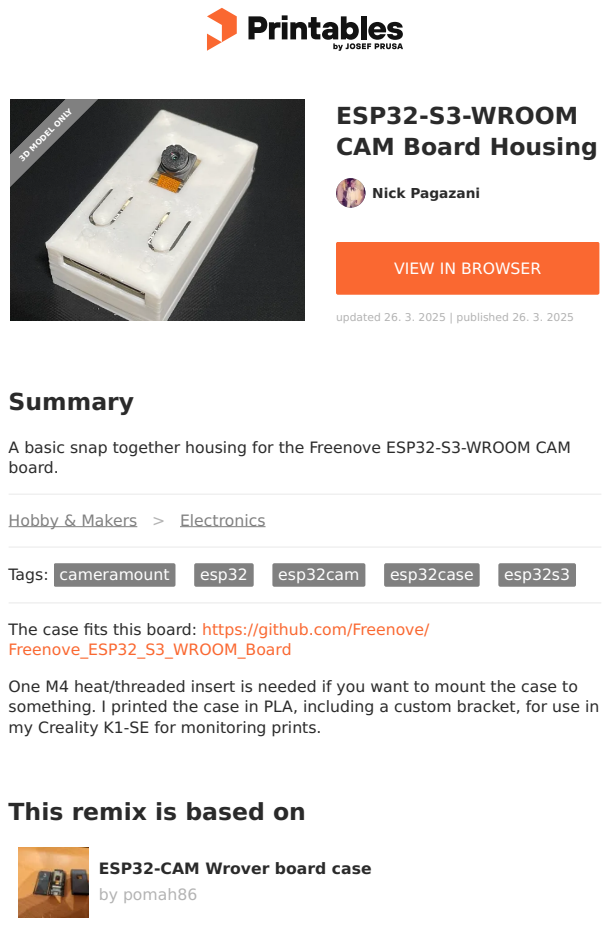
[picture p9: page 1]
Summary; Tags:; cameramount; esp32; esp32cam; esp32case; esp32s3; Nick Pagazani; updated 26. 3. 2025 | published 26. 3. 2025; 3D MODEL ONLY

VIEW IN BROWSER (https://printables.com/model/1244536-esp32-s3-wroom-cam-board-housing)

A basic snap together housing for the Freenove ESP32-S3-WROOM CAM
board.

Hobby & Makers (https://printables.com/model?categoryId=48) > Electronics (https://printables.com/model?categoryId=52)

The case fits this board: https://github.com/Freenove/
Freenove_ESP32_S3_WROOM_Board (https://github.com/Freenove/Freenove_ESP32_S3_WROOM_Board)

One M4 heat/threaded insert is needed if you want to mount the case to
something. I printed the case in PLA, including a custom bracket, for use in
my Creality K1-SE for monitoring prints.

This remix is based on

ESP32-CAM Wrover board case (https://printables.com/model/296079-esp32-cam-wrover-board-case)
by pomah86 (https://printables.com/@pomah86_252140)

## Model files

## License

This work is licensed under a
Creative Commons (4.0 International License)

Attribution-ShareAlike (http://creativecommons.org/licenses/by-sa/4.0/)

✖ | Sharing without ATTRIBUTION
✔ | Remix Culture allowed
✔ | Commercial Use
✔ | Free Cultural Works
✔ | Meets Open Definition

esp32-cam-top.stl

esp32-cam-bottom.stl

esp32-cam-top.step

esp32-cam-bottom.step
