walahow/IoT-Fatigue/fatigue-helmet/firmware/src/main.cpp

/**
 * IoT Helmet — Fatigue Detection Firmware (Phase 2)
 * Board  : ESP32-S3 (Freenove WROOM CAM)
 * Sensors: Analog Pulse Sensor @ GPIO 1 (ADC1)
 *          MPU-6050 GY-521 (Accel + Gyro) @ I2C 0x68 (SDA=2, SCL=3)
 * Camera : OV2640 (configurable via build flags, default VGA @ 20 FPS, MJPEG
 * mode)
 *
 * ── Storage modes (select via PlatformIO environment) ──────────────────────
 *
 *   STORAGE_MODE_USB  (env:esp32s3cam)
 *     Camera frames sent as binary packets over USB-UART @ 921600 baud.
 *     Run debug_recorder.py on PC to demux and save:
 *       sessions/session_XXX/sensor_data.csv
 *       sessions/session_XXX/frames/{timestamp_ms}.jpg
 *
 *   STORAGE_MODE_SD   (env:esp32s3cam_sd)
 *     Camera frames + CSV saved directly to microSD card (SD_MMC 1-bit).
 *     SD pins (Freenove ESP32-S3-WROOM CAM, do not modify):
 *       CMD = GPIO 38  |  CLK = GPIO 39  |  D0 = GPIO 40
 *     Session folder structure:
 *       sessions/session_XXX/metadata.txt
 *       sessions/session_XXX/sensor_data.csv
 *       sessions/session_XXX/video.mjpeg   ← sequential JPEG stream (30 FPS)
 *       sessions/session_XXX/video.idx     ← sidecar:
 * frame_index,timestamp_ms,byte_offset,frame_size,crc32_hex
 *
 * Binary frame protocol (USB mode only):
 *   [0xAA 0xBB 0xCC 0xDD]  4 B  magic SOF
 *   [timestamp_ms]          4 B  little-endian uint32
 *   [jpeg_length]           4 B  little-endian uint32
 *   [JPEG data]             N B
 *   [0xDD 0xCC 0xBB 0xAA]  4 B  magic EOF
 */

#include "MPU6050.h" // electroniccats/MPU6050
#include "esp_camera.h"
#include "esp_task_wdt.h"  // TWDT reset to prevent Core 1 reboot
#include "freertos/FreeRTOS.h"
#include "freertos/semphr.h"
#include "freertos/task.h"
#include <Arduino.h>
#include <stdarg.h>
#include <Wire.h>
#include <math.h>
#include "FuzzyFatigue.h"  // Mamdani FIS (heap-free, STL-free, header-only)
#include "NodDetector.h"    // nodding score from the 10 Hz pitch buffer
#include "AlertGate.h"      // dwell + release hold between the raw alert and the buzzer
#include "HrBaseline.h"     // resting HR baseline: median after a settling skip

#if defined(STORAGE_MODE_SD) || defined(EAR_LIVE_DEBUG)
#include "EyeBlinkEAR.h"        // on-device blink detection (spec section 5)
#include "BlinkWeights.h"       // HOG classifier weights, from python/train_blink_classifier.py
#include <Preferences.h>        // NVS: the stored eye coordinate (see earStoredRoi*)
#include "img_converters.h"     // fmt2rgb888() -- esp32-camera
#include "esp_heap_caps.h"      // heap_caps_malloc() / MALLOC_CAP_SPIRAM
#endif

// ── Camera resolution / FPS defaults ─────────────────────────────────────
// Override via build_flags in platformio.ini, e.g.:
//   -DCAMERA_FRAMESIZE=FRAMESIZE_VGA  -DCAMERA_FPS=20
// Supported: FRAMESIZE_QVGA (320x240), FRAMESIZE_CIF (400x296),
//            FRAMESIZE_HVGA (480x320), FRAMESIZE_VGA (640x480)
// NOTE: SD_MMC 1-bit (~3-4 MB/s) limits throughput.
//       VGA@20fps ≈ 15-25 KB/frame x 20 = 300-500 KB/s -- well within budget.
//       SVGA or higher will cause frame drops on SD writes.
#ifndef CAMERA_FRAMESIZE
#define CAMERA_FRAMESIZE FRAMESIZE_VGA
#endif
#ifndef CAMERA_FPS
#define CAMERA_FPS 20
#endif
#ifndef CAMERA_JPEG_QUALITY
#define CAMERA_JPEG_QUALITY 10  // 0=best, 63=worst
#endif

// ── SD_MMC (production mode) ─────────────────────────────────────────────
#if defined(STORAGE_MODE_SD)
#include "SD_MMC.h"
// SD card pins (Freenove ESP32-S3-WROOM CAM — do not modify)
#define SD_MMC_CMD_PIN 38
#define SD_MMC_CLK_PIN 39
#define SD_MMC_D0_PIN 40
#endif

// ── Phone arming preview (SD build, -DPHONE_PREVIEW) ─────────────────────
#if defined(PHONE_PREVIEW)
#if !defined(STORAGE_MODE_SD)
#error "PHONE_PREVIEW is for the SD build: it reports the arming state that only exists there"
#endif
#include "PhonePreview.h"
// Wi-Fi and the web server go off this long after RECORDING starts (just long
// enough for the page's next poll to show that recording began), so the radio
// and httpd stay out of the ride entirely (spec: "Wi-Fi lifecycle"). Declared
// here, not in the phoneTick block below, so openSession() can also see it.
static const uint32_t PHONE_WIFI_OFF_AFTER_MS = 3000;
#endif

// ── Camera Pins (Freenove ESP32-S3-WROOM CAM) ───────────────────────────
#define PWDN_GPIO_NUM -1
#define RESET_GPIO_NUM -1
#define XCLK_GPIO_NUM 15
#define SIOD_GPIO_NUM 4
#define SIOC_GPIO_NUM 5
#define Y9_GPIO_NUM 16
#define Y8_GPIO_NUM 17
#define Y7_GPIO_NUM 18
#define Y6_GPIO_NUM 12
#define Y5_GPIO_NUM 10
#define Y4_GPIO_NUM 8
#define Y3_GPIO_NUM 9
#define Y2_GPIO_NUM 11
#define VSYNC_GPIO_NUM 6
#define HREF_GPIO_NUM 7
#define PCLK_GPIO_NUM 13

// ── Pulse Sensor constants ────────────────────────────────────────────────
#define PULSE_PIN 1             // GPIO 1, ADC1 channel 0 on ESP32-S3
#define SAMPLE_RATE_MS 2        // 2 ms = 500 Hz sampling
#define BPM_BUFFER_SIZE 8       // beats averaged for stable BPM output
#define SIGNAL_LOW_THRESH 200   // ADC < this → likely no skin contact
#define SIGNAL_HIGH_THRESH 3900 // ADC > this → sensor saturated
#define MIN_BEAT_INTERVAL 500   // ms → 120 BPM max (prevents double-triggers)
#define MAX_BEAT_INTERVAL 2000  // ms → 30 BPM min

// ── Alert output ──────────────────────────────────────────────────────────────
// GPIO 14 confirmed free: no conflict with camera (4-18), I2C (2,3), SD (38-40),
// or pulse sensor (1). See fuzzy_walkthrough.md §7 for full GPIO audit.
#define BUZZER_PIN 14
#define MIN_AMPLITUDE 20        // min peak-to-valley swing
#define BEAT_TIMEOUT_MS 5000    // ms with no beat → reset BPM



// ── Session Control ──────────────────────────────────────────────────────────
#define BUTTON_PIN 21

// Session lifecycle. The button no longer flips recording on directly:
// pressing it ARMS the rig, which re-establishes the three things a usable
// session needs -- eye ROI lock, HR baseline, IMU calibration for the pose the
// helmet is ACTUALLY in -- and only then starts writing. Recording with any of
// those missing produces a session that cannot be used for training, which is
// the failure this state machine exists to prevent.
//
//   IDLE --press--> ARMING --all ready | timeout--> RECORDING --press--> IDLE
//                     |                                        (closeSession)
//                     +--press = abort--> IDLE
enum SessionState {
  SESSION_IDLE = 0,
  SESSION_ARMING,
  SESSION_RECORDING
};

// Give up waiting and record anyway after this long. A subsystem that never
// goes ready (eye lock in poor light, bad pulse contact) must not cost the
// whole session -- the readiness flags are written into metadata.txt instead,
// so the recording can be judged afterward rather than silently trusted.
static const uint32_t ARMING_TIMEOUT_MS = 60000;

SessionState g_sessionState = SESSION_IDLE;
uint32_t     g_armStartMs   = 0;
bool         g_armTimedOut  = false;

// Per-subsystem readiness, latched at the moment recording begins.
bool g_readyImu = false;
bool g_readyHr  = false;
bool g_readyEye = false;

// Derived from g_sessionState so the existing consumers (saveJpegToSD, the CSV
// writer, the buzzer gate) keep working unchanged.
#if defined(STORAGE_MODE_USB)
bool g_sessionActive = true;  // Start streaming immediately in USB debug mode
#else
bool g_sessionActive = false; // Start paused in SD card mode
#endif
bool g_lastButtonState = HIGH;
unsigned long g_lastDebounceTime = 0;
int g_sessionBeepState = 0;
unsigned long g_sessionBeepTimer = 0;

// ── I2C & output timing constants ────────────────────────────────────────
const uint8_t PIN_SDA = 2;
const uint8_t PIN_SCL = 3;
const uint32_t LOOP_MS = 1000; // 1 Hz CSV output rate

#ifndef LED_BUILTIN
#define LED_BUILTIN 2
#endif

// ── MPU-6050 constants ────────────────────────────────────────────────────
const uint8_t MPU_ADDR = 0x68;
const float ACCEL_SCALE = 16384.0f; // LSB/g at ±2 g range
const float GYRO_SCALE = 131.0f;    // LSB/(°/s) at ±250 °/s range
const int CALIB_SAMPLES = 200;

// ── Pulse sensor globals ─────────────────────────────────────────────────
// Hardware capacitor handles DC bias removal — only a single low-pass IIR
// needed.
float iirLP = 2048.0f; // single-pole LP state; init at ADC midpoint
long beatIntervals[BPM_BUFFER_SIZE] = {0};
int beatIndex = 0;
long lastBeatTime = 0;
float currentBPM = 0;
bool risingSignal = false;
int dynamicThreshold = 2048;
float peakValue = 2048.0f;
float valleyValue = 2048.0f;
// τ ≈ 200 ms at 500 Hz (0.990 → 1/(1-0.990) × 2ms ≈ 200 ms)
const float ENVELOPE_DECAY = 0.990f;

// Shared output state — written by readPulseSensor(), read in loop output
int lastPulseRaw = 0;
int lastSignalQuality = 0;

// ── No-contact warning state ──────────────────────────────────────────────
int noContactStreak = 0;
const int NO_CONTACT_WARN_N = 10;

// ── MPU-6050 ─────────────────────────────────────────────────────────────
MPU6050 mpu(MPU_ADDR);
bool g_mpuEnabled = false;
bool g_buzzerActive = false;
// Mute the physical buzzer without breaking the I2C-suspend-during-EMI logic:
// setBuzzerState() ANDs this in, so g_buzzerActive only goes true when the
// pin is actually driven HIGH. Re-muted to isolate whether the buzzer being
// on the shared 3V/capacitor rail (with pulse sensor + IMU) is what's
// causing the IMU to drop out in production firmware -- see the
// camera-then-IMU-then-SD boot order + shared-rail discussion.
bool g_buzzerMuted = true;
int16_t ax_off = 0, ay_off = 0, az_off = 0;
int16_t gx_off = 0, gy_off = 0, gz_off = 0;

// ── Serial mutex (USB mode: protects binary frame interleaving) ───────────
SemaphoreHandle_t g_serialMutex = nullptr;

// ── SD card globals (SD mode only) ───────────────────────────────────────
#if defined(STORAGE_MODE_SD)
SemaphoreHandle_t g_sdMutex = nullptr;
File g_csvFile;            // sensor_data.csv — kept open entire session
File g_mjpegFile;          // video.mjpeg     — kept open entire session
File g_idxFile;            // video.idx       — kept open entire session
File g_blinkFile;          // blink_events.csv — one row per blink either detector counted
uint32_t g_byteOffset = 0; // running byte offset into video.mjpeg
uint32_t g_frameIndex = 0; // monotonic frame counter
bool g_sdReady = false;
#endif

// ── On-device EAR blink detection state (SD mode, or USB + EAR_LIVE_DEBUG) ──
// See docs/superpowers/specs/2026-09-01-on-device-fatigue-detection-design.md §5.
// EAR_LIVE_DEBUG (env:esp32s3cam_ear_preview) runs this same pipeline over
// USB video streaming instead of SD writes, at the same QVGA resolution the
// SD build uses -- NOT at the USB build's default VGA. The ~97 ms/frame
// decode cost that's already proven safe at QVGA (see processEarFrame's
// note) would be ~4x worse at VGA and risk the exact watchdog boot-loop
// cameraTask's yield comment describes; that's why esp32s3cam_ear_preview
// overrides CAMERA_FRAMESIZE back down to QVGA in platformio.ini.
#if defined(STORAGE_MODE_SD) || defined(EAR_LIVE_DEBUG)
// Every captured frame is processed. The glint check that replaced the old
// shape math is one compare+increment per pixel, so the per-frame cost is
// now dominated entirely by the JPEG decode that already had to happen.
// This ALSO has to be 1: GlintBlinkDetector's "absent for >= 2 consecutive
// frames" rule counts PROCESSED frames, and this hardware really captures
// at ~8 fps (measured on session_040: 480 frames / 60.9 s), so a typical
// 250-300 ms blink spans only ~2 frames. Any throttling drops it into the
// sampling gap entirely.
static const int   EAR_THROTTLE_DIV   = 1;   // every frame -- affordable at QVGA
                                              // the decode is half-scale (see processEarFrame)
// Sized to the eye region rather than tightly to the pupil, so normal gaze
// movement keeps the corneal reflection inside the crop.
static const int   EAR_ROI_SIZE       = 48;   // QVGA: same physical eye area as 96px at VGA
// Search room beyond the ROI on each side when checking for drift. Must leave
// the window >= the locator's fixed 80x60 grid (EyeBlinkEAR::MotionLocator::
// GRID_W/H, enforced below) -- at EAR_ROI_SIZE=48 that needs >= 16 px; 30
// matches the disabled version's value, kept for continuity rather than
// re-derived (no data yet either way -- see earDriftTick()'s comment).
static const int   EAR_DRIFT_MARGIN   = 30;
// Retrospective validation against a real session (2026-09-03, see
// session_replay tool) found the ORIGINAL periodic drift-check here could
// confidently re-lock onto hair occluding the camera later in a session --
// hair is a genuinely darker/more stable feature than the eye once it drifts
// into frame, so an Otsu+centroid drift check has no way to tell the
// difference. That is a different problem (occlusion) than what drift-
// correction was built to solve (small physical helmet shift), and it is
// the SAME flaw the motion-energy boot lock two sections down was itself
// built to fix -- darkest-blob was the ORIGINAL boot lock too, replaced for
// exactly this reason. See earDriftTick(): it reuses that boot lock instead
// of reinventing darkness-based drift.
static const bool  EAR_DRIFT_ENABLED  = true;

// ── Motion-energy boot lock ──────────────────────────────────────────────
// Replaces an earlier "largest Otsu-thresholded blob in the middle 60% of
// the frame" lock, which retrospective validation (session_023) found
// consistently latched onto brow/cheek shadow instead of the eye (59px off
// the real eye centre, 0.24 IoU with a Haar-verified reference box) -- Otsu
// always finds SOME dark region, with no eye-specific prior at all.
//
// The eye is the one region that's normally in the camera's field of view.
// In a helmet-fixed shot, cheek/brow/hair are all rigidly attached to the
// head and move with the camera; only the eyelid moves independently. See
// EyeBlinkEAR::MotionLocator for the implementation; validated on the same
// session: locked within 2.8px of the true eye centre on the first try,
// confidence 5.04 against a 2.0 gate.
#if EAR_LOCALIZER_VERSION >= 3
// v3 gates on EAR_V3_WINDOW_MS of wall clock (20 s), which holds the number of
// blinks in the window constant across frame rates. This is only the frame
// FLOOR beneath that: enough samples to resolve a 100-300 ms blink at all. It
// binds only below 6 fps, where 20 s would yield fewer than 120 frames.
static const int   EAR_MOTION_MIN_FRAMES = 120;
#elif EAR_LOCALIZER_VERSION == 2
// 240 frames is ~20 s at this camera's real ~12 fps, which contains about
// five blinks at a normal 14/min. The old 60 (~5 s) contained roughly ONE,
// and a single blink is indistinguishable from a single stray light
// movement anywhere else in the frame -- which is exactly how session_100
// locked 252 px from the pupil and recorded zero blinks. Measured across
// sessions 023/040/067/100, this one change drops mean lock error from
// 74.6 px to 14.4 px. Do not shorten it without re-running that set.
//
// The arming phase waits up to ARMING_TIMEOUT_MS (60 s) for the eye lock,
// so a ~20 s window fits comfortably inside a normal session start.
static const int   EAR_MOTION_MIN_FRAMES = 240;
#else
static const int   EAR_MOTION_MIN_FRAMES = 60;    // ~3s of processed frames
#endif
static const float EAR_MOTION_MIN_CONF   = 2.0f;  // reject flat/smeared maps
static const int   EAR_MOTION_MAX_TRIES  = 12;    // accept a weak lock rather than never locking

static uint8_t *g_earRgbBuf  = nullptr;  // PSRAM, fullW*fullH*3 (decoded JPEG)
static uint8_t *g_earGrayBuf = nullptr;  // PSRAM, fullW*fullH, reused at partial size
static int      g_earFullW   = 0;
static int      g_earFullH   = 0;

static uint32_t g_earFrameCounter = 0;

// Drift correction cycle state -- see earDriftTick(). IDLE: not accumulating.
// ACCUMULATING: g_earLocator is mid-window, searching a small area around the
// current lock. No frame counter needed beyond this: the locator's own
// wall-clock window (EAR_V3_WINDOW_MS) and frame floor (EAR_MOTION_MIN_FRAMES)
// decide when a cycle is ready to evaluate, same as the boot lock.
enum EarDriftState : uint8_t { EAR_DRIFT_IDLE = 0, EAR_DRIFT_ACCUMULATING };
static EarDriftState g_earDriftState = EAR_DRIFT_IDLE;

static volatile bool g_earLockDone = false;
static bool  g_earDisabled = false;  // set true after a failed buffer allocation; never retried
static int   g_earMotionTries = 0;
static float g_earLockConfidence = 0.0f;

// ~28 KB -- global, not a local/stack variable (see MotionLocator's own note).
static EyeBlinkEAR::MotionLocator g_earLocator;
#if EAR_LOCALIZER_VERSION >= 4
// Scratch for v4's darkest-blob re-centre, allocated in PSRAM alongside the
// other EAR buffers -- 25 KB at EAR_ROI_SIZE 48, which does not belong in the
// 320 KB of internal DRAM when PSRAM is right there. Used once, at lock.
static const int EAR_REFINE_SIDE = EAR_ROI_SIZE + 2 * EAR_V4_MARGIN;
static uint8_t  *g_earRefGray = nullptr;
static uint8_t  *g_earRefMask = nullptr;
static uint16_t *g_earRefRow  = nullptr;
#endif

// Scratch for isolateLargestComponent(), sized to the locked EAR crop
// (EAR_ROI_SIZE^2) -- fixed at compile time, so plain static arrays rather
// than a PSRAM heap_caps_malloc like the full-frame buffers above.
static int16_t  g_earLabelScratch[EAR_ROI_SIZE * EAR_ROI_SIZE];
static uint16_t g_earQueueScratch[EAR_ROI_SIZE * EAR_ROI_SIZE];
static uint8_t  g_earIsolatedMask[EAR_ROI_SIZE * EAR_ROI_SIZE];

// ── Stored eye coordinate ────────────────────────────────────────────────
// The motion localizer needs ~20 s of blinking to find the eye, can reject a
// window, and has locked 252 px off the pupil before (session_100 recorded 0
// blinks because of it). A coordinate checked once on the PC -- see
// live_ear_preview.py --arm -- removes that whole failure mode and starts
// detection on the first frame instead of after the lock.
//
// It is only valid while the camera sits the same way on the head, and a
// stale one fails SILENTLY (the classifier scores a patch of cheek and
// reports no blinks, which looks like a rider who isn't blinking). So the
// arming check must confirm it every time the helmet goes on, and
// metadata.txt records which source a session used.
//
// Precedence: EAR_ROI_MANUAL_X/Y build flag > stored coordinate > motion lock.
static Preferences g_earPrefs;
static const char *EAR_PREFS_NS = "eyeroi";
static int  g_earStoredCx = -1;         // -1 = nothing stored
static int  g_earStoredCy = -1;
static const char *g_earRoiSource = "none";   // none | manual | stored | motion

static void earLoadStoredRoi() {
  if (!g_earPrefs.begin(EAR_PREFS_NS, true)) return;   // read-only; absent on first boot
  g_earStoredCx = g_earPrefs.getInt("cx", -1);
  g_earStoredCy = g_earPrefs.getInt("cy", -1);
  g_earPrefs.end();
}

static void earSaveStoredRoi(int cx, int cy) {
  if (g_earPrefs.begin(EAR_PREFS_NS, false)) {
    g_earPrefs.putInt("cx", cx);
    g_earPrefs.putInt("cy", cy);
    g_earPrefs.end();
  }
  g_earStoredCx = cx;
  g_earStoredCy = cy;
}

static void earClearStoredRoi() {
  if (g_earPrefs.begin(EAR_PREFS_NS, false)) {
    g_earPrefs.clear();
    g_earPrefs.end();
  }
  g_earStoredCx = g_earStoredCy = -1;
}

EyeBlinkEAR::RoiLock      g_earRoi;
EyeBlinkEAR::BlinkDetector g_earBlink;        // legacy shape-based path, no longer driving alerts
EyeBlinkEAR::GlintBlinkDetector g_earGlint;   // active blink detector
// Per-frame eye-state classifier: THIS drives g_onDeviceBlinkRate (the blink_rate
// the fuzzy model and CSV get). The glint detector above still runs and still
// prints "#STATUS: blink (glint)" lines, purely as a comparison -- it missed ~95%
// of hand-labelled blinks on session_101. The weights are trained on ONE rider
// without glasses (session_101), so a new rider needs their own labels/weights
// before this rate means anything. SD sessions save every frame, so what it would
// have done can be replayed on the PC (session_replay --hog-model,
// python/train_blink_classifier.py).
EyeBlinkEAR::HogBlinkDetector g_earHog;
EyeBlinkEAR::HogBackground g_earHogBg;   // running open-eye template, used when BlinkWeights.h defines BLINK_HOG_BGSUB
static EyeBlinkEAR::BlinkRateWindow g_earHogRate;   // g_earHog blinks, 3 min window (smoothedBpm); camera task only
static uint8_t g_earHogSmall[EyeBlinkEAR::HOG_W * EyeBlinkEAR::HOG_H];  // 2 KB, off the task stack
static float   g_earHogFeat[EyeBlinkEAR::HOG_LEN];                     // 3 KB, off the task stack
#if defined(EAR_PROFILE) || defined(FRAME_INJECT_MODE)
// Classifier time, summed between reports. FRAME_INJECT_MODE reports it per
// frame, so the per-frame cost can be measured on a bare ESP32-S3 dev board
// with no camera attached -- frames come in over USB instead.
static uint32_t g_earProfHogUs = 0;
// Drift correction's own share of ear=, same reasoning as g_earProfHogUs --
// this is the number that answers "does it fit": drift now runs every
// processed frame (not once per session like the boot lock), so its
// steady-state cost has to be measured, not assumed.
static uint32_t g_earProfDriftUs = 0;
#endif
volatile float g_onDeviceBlinkRate = 13.0f;  // read by the g_blinkRate fallback below

// Health of the on-device blink channel, written here by the camera task and
// read by loop() at 1 Hz to decide blink_valid. A rate of 0 from a detector that
// cannot see the eye is not "the rider isn't blinking", so the FIS must be told.
// This proves the classifier is RUNNING on a locked ROI; it cannot prove the eye is
// really in view or that the rider resembles its training data (glasses, another
// face -- see eyeglasses sessions 102-104).
volatile uint32_t g_earLastFrameMs  = 0;   // millis() of the last frame the classifier processed
volatile uint32_t g_earValidSinceMs = 0;   // millis() of the first frame after the ROI lock; 0 = not yet
// Arming eye check: after the ROI lock the rider must be seen to blink at least
// EAR_CHECK_MIN_BLINKS times within EAR_CHECK_WINDOW_MS, or the blink channel is
// not trusted for the session (blink_valid = 0). A lock succeeds on glasses and on
// a cheek just as happily as on an eye, so it proves nothing about blink detection;
// an alert rider at the start of a ride blinks several times in 30 s (session_101:
// 12 classifier blinks; glasses sessions 102-104: 0, 0 and 2). Thresholds come from
// those four sessions -- re-check them with more riders.
enum EyeCheck : uint8_t { EYECHECK_PENDING = 0, EYECHECK_PASS, EYECHECK_FAIL };
static const uint8_t  EAR_CHECK_MIN_BLINKS = 3;
static const uint32_t EAR_CHECK_WINDOW_MS  = 30000;
volatile uint8_t g_earBlinksSinceLock = 0;   // classifier blinks since the ROI lock (saturates at 255)
volatile uint32_t g_earHogBlinkTotal = 0;    // classifier blinks since boot, never reset -- camera task is the only writer (volatile ++ is not atomic); the phone page takes deltas
EyeCheck g_eyeCheck = EYECHECK_PENDING;      // resolved by loop(); latched for the session
static const uint32_t EAR_BLINK_WARMUP_MS = 60000;  // rate is a 60 s count; a shorter window reads low
static const uint32_t EAR_FRAME_STALE_MS  = 3000;   // no processed frame this long = camera/decode stalled

// Converts a rectangular region of an RGB888 buffer to grayscale (simple
// average of R,G,B) into a caller-provided buffer sized regionW*regionH.
// Out-of-frame coordinates clamp to the nearest edge.
// Converts a rectangular region of an RGB888 buffer to grayscale (simple
// average of R,G,B) into a caller-provided buffer sized regionW*regionH.
// Out-of-frame coordinates clamp to the nearest edge.
static void earExtractGray(const uint8_t *rgb, int fullW, int fullH,
                            int regionX, int regionY, int regionW, int regionH,
                            uint8_t *outGray) {
  for (int ry = 0; ry < regionH; ry++) {
    int sy = regionY + ry;
    if (sy < 0) sy = 0;
    if (sy >= fullH) sy = fullH - 1;
    for (int rx = 0; rx < regionW; rx++) {
      int sx = regionX + rx;
      if (sx < 0) sx = 0;
      if (sx >= fullW) sx = fullW - 1;
      const uint8_t *px = rgb + ((size_t)sy * fullW + sx) * 3;
      outGray[ry * regionW + rx] = (uint8_t)(((int)px[0] + px[1] + px[2]) / 3);
    }
  }
}

// otsuThreshold() only cares about total pixel count, not 2D shape, so a
// flat n-pixel buffer can be passed as (n, 1) safely.
static void earPrintf(const char *fmt, ...);   // defined below; earDriftTick logs through it

static_assert(EAR_ROI_SIZE + 2 * EAR_DRIFT_MARGIN >= (int)EyeBlinkEAR::MotionLocator::GRID_W &&
              EAR_ROI_SIZE + 2 * EAR_DRIFT_MARGIN >= (int)EyeBlinkEAR::MotionLocator::GRID_H,
              "drift search window must be at least the locator's grid size");

// ── Drift correction ────────────────────────────────────────────────────────
// Re-runs the boot lock's own motion-energy search (EyeBlinkEAR::MotionLocator,
// declared above) on a small window around the current ROI instead of the
// whole frame, once per accumulation cycle. This is NOT a new algorithm: it
// is the boot lock, reused, which is what makes it trustworthy -- see the
// EAR_DRIFT_ENABLED comment above for why a from-scratch darkness-based
// version was rejected. Confirmed on session_116 (a real ride, 2026-09-22):
// the eye visibly walked out of the fixed ROI over several minutes while the
// (disabled) old drift check would have re-locked onto skin/hair; motion
// energy cannot make that mistake, because hair does not blink.
//
// State cost: reuses g_earLocator and the v4 refine scratch buffers, both
// idle once g_earLockDone -- net new static memory is EarDriftState above,
// a handful of bytes. This matters on an S3: the locator alone is ~28.8 KB
// of internal SRAM (see its own declaration comment); a second copy for
// drift was not an option on this chip's RAM budget, so there isn't one.
//
// UNVALIDATED end-to-end: reasoned from the boot lock's own validated
// behaviour and confirmed the disabled version's specific failure mode
// against session_116, but no ride has yet been recorded WITH this code
// running. Build with -DEAR_PROFILE to confirm the added per-frame cost
// (g_earProfDriftUs, in the #PROF line) is affordable at speed, and check
// "#STATUS: EAR drift corrected" lines against the session's video the same
// way session_116 was checked by hand before trusting the numbers.
static void earDriftTick(int w, int h, uint32_t timestampMs) {
  if (!EAR_DRIFT_ENABLED) return;
#if defined(EAR_PROFILE) || defined(FRAME_INJECT_MODE)
  uint32_t tDrift0 = (uint32_t)micros();
#endif

  if (g_earDriftState == EAR_DRIFT_IDLE) {
    g_earLocator.reset();
#if EAR_LOCALIZER_VERSION >= 2
    g_earLocator.setRoiSize(EAR_ROI_SIZE);
#endif
#if EAR_LOCALIZER_VERSION >= 3
    g_earLocator.setWindowMs(EAR_V3_WINDOW_MS);
#endif
    g_earDriftState = EAR_DRIFT_ACCUMULATING;
  }

  // Same throttled-progress idea as the boot lock's #EARLOCK line: without
  // this, a cycle that never finds a confident peak is silent forever, which
  // during a live test is indistinguishable from the code not running at all.
  static uint32_t lastDriftReport = 0;
  if (timestampMs - lastDriftReport >= 5000) {
    lastDriftReport = timestampMs;
    earPrintf("#EARDRIFT: accumulating frames=%d elapsed=%lums\n",
              g_earLocator.framesAccumulated,
              (unsigned long)(g_earLocator.haveTime
                              ? (g_earLocator.lastMs - g_earLocator.firstMs) : 0));
  }

  // The search window: ROI + margin. earExtractGray() clamps each SOURCE
  // pixel to the frame edge individually (see its own doc comment), so this
  // is always exactly EAR_ROI_SIZE + 2*EAR_DRIFT_MARGIN square even when the
  // ROI sits against a real frame edge -- no separate shrink-or-skip case
  // needed. Recomputed from g_earRoi every tick rather than cached: safe,
  // because g_earRoi only changes at the END of a cycle, below, never during.
  const int dw = EAR_ROI_SIZE + 2 * EAR_DRIFT_MARGIN;
  const int dh = dw;
  const int dx = g_earRoi.x - EAR_DRIFT_MARGIN;
  const int dy = g_earRoi.y - EAR_DRIFT_MARGIN;

  earExtractGray(g_earRgbBuf, w, h, dx, dy, dw, dh, g_earGrayBuf);
#if EAR_LOCALIZER_VERSION >= 3
  g_earLocator.addFrame(g_earGrayBuf, dw, dh, timestampMs);
#else
  g_earLocator.addFrame(g_earGrayBuf, dw, dh);
#endif

  float peakCx, peakCy, conf;
  if (!g_earLocator.peak(dw, dh, EAR_MOTION_MIN_FRAMES, peakCx, peakCy, conf)) {
#if defined(EAR_PROFILE) || defined(FRAME_INJECT_MODE)
    g_earProfDriftUs += (uint32_t)micros() - tDrift0;
#endif
    return;   // window still accumulating
  }

  g_earDriftState = EAR_DRIFT_IDLE;   // cycle consumed either way; next tick starts a fresh one

  if (conf >= EAR_MOTION_MIN_CONF) {
#if EAR_LOCALIZER_VERSION >= 4
    // Same re-centre step the boot lock takes, on this window treated as its
    // own "full frame" -- reuses the boot lock's scratch buffers exactly, and
    // g_earGrayBuf still holds this tick's window crop from addFrame() above.
    g_earLocator.refine(g_earGrayBuf, dw, dh,
                        g_earRefGray, g_earRefMask, g_earRefRow, peakCx, peakCy);
#endif

    int newX = (int)(dx + peakCx - g_earRoi.size / 2.0f);
    int newY = (int)(dy + peakCy - g_earRoi.size / 2.0f);
    if (newX + g_earRoi.size > w) newX = w - g_earRoi.size;
    if (newY + g_earRoi.size > h) newY = h - g_earRoi.size;
    if (newX < 0) newX = 0;
    if (newY < 0) newY = 0;

    if (newX != g_earRoi.x || newY != g_earRoi.y) {
      earPrintf("#STATUS: EAR drift corrected x=%d->%d y=%d->%d conf=%.2f\n",
                g_earRoi.x, newX, g_earRoi.y, newY, conf);
      g_earRoi.x = newX;
      g_earRoi.y = newY;
    } else {
      earPrintf("#EARDRIFT: cycle confident (conf=%.2f) but already on target\n", conf);
    }
  } else {
    // No confident motion in the window -- most likely nobody blinked in it,
    // or the eye is not in it at all. Leaving the ROI alone here, rather than
    // taking the best available (however weak) guess, is the actual fix: the
    // old code always "found" something because darkness always exists
    // somewhere.
    earPrintf("#EARDRIFT: cycle ended, not confident (conf=%.2f < %.2f)\n",
              conf, EAR_MOTION_MIN_CONF);
  }
  // A fresh cycle starts on the next tick regardless.

#if defined(EAR_PROFILE) || defined(FRAME_INJECT_MODE)
  g_earProfDriftUs += (uint32_t)micros() - tDrift0;
#endif
}
// ─────────────────────────────────────────────────────────────────────────
// logBlinkEvent() -- append one detected blink to blink_events.csv (SD mode).
// timestamp_ms is the same millis() clock as sensor_data.csv and video.idx, so an event
// can be laid against the saved frames and against hand labels. source is "hog" (the
// classifier that drives blink_rate) or "glint" (logged for comparison); score is the
// classifier score, blank for glint. Called from the camera task, which holds no other
// lock at that point. An event that cannot get the SD mutex quickly is dropped rather
// than stalling the frame loop.
static void logBlinkEvent(uint32_t timestampMs, const char *source, bool hasScore, float score) {
#if defined(STORAGE_MODE_SD)
  if (!g_sdReady || !g_blinkFile || !g_sessionActive) return;
  if (xSemaphoreTake(g_sdMutex, pdMS_TO_TICKS(20)) != pdTRUE) return;
  if (hasScore) g_blinkFile.printf("%lu,%s,%.3f\n", (unsigned long)timestampMs, source, score);
  else          g_blinkFile.printf("%lu,%s,\n", (unsigned long)timestampMs, source);
  g_blinkFile.flush();   // a few rows a minute -- flush each so a power cut loses nothing
  xSemaphoreGive(g_sdMutex);
#else
  (void)timestampMs; (void)source; (void)hasScore; (void)score;
#endif
}

// earPrintf() — serial output from the EAR pipeline, mutex-protected.
//
// In USB mode this task is also streaming binary JPEG frames, and
// sendJpegFrame() takes g_serialMutex around each one. These status prints
// did not, so a line like "#STATUS: EAR ROI motion-locked at ..." was routinely
// cut in half by frame bytes landing mid-write. The firmware was reporting the
// lock correctly; the line simply never arrived intact, so live_ear_preview.py
// never matched it and a working localizer looked completely dead through two
// preview sessions.
//
// Same mutex, same 20 ms timeout as sendJpegFrame. On timeout the message is
// dropped rather than emitted corrupt -- a lost status line is recoverable, a
// shredded one poisons the parser. In SD mode the mutex still exists (setup()
// creates it in both modes) so this path is identical there.
// ─────────────────────────────────────────────────────────────────────────
static void earPrintf(const char *fmt, ...) {
  char buf[160];
  va_list ap;
  va_start(ap, fmt);
  vsnprintf(buf, sizeof(buf), fmt, ap);
  va_end(ap);

  if (g_serialMutex == nullptr) {   // before setup() creates it
    Serial.print(buf);
    return;
  }
  if (xSemaphoreTake(g_serialMutex, pdMS_TO_TICKS(20)) == pdTRUE) {
    Serial.print(buf);
    xSemaphoreGive(g_serialMutex);
  }
}


void processEarFrame(camera_fb_t *fb, uint32_t timestampMs) {
  int w = (int)fb->width;
  int h = (int)fb->height;

  if (!g_earRgbBuf && !g_earDisabled) {
    // Half-scale RGB565: (w/2)*(h/2)*2 bytes, vs the old w*h*3 full-scale
    // RGB888 -- 6x smaller, and ~4x less decode work (measured below).
    g_earRgbBuf  = (uint8_t *)heap_caps_malloc((size_t)w * h * 3, MALLOC_CAP_SPIRAM);
    g_earGrayBuf = (uint8_t *)heap_caps_malloc((size_t)w * h, MALLOC_CAP_SPIRAM);
    g_earFullW = w;
    g_earFullH = h;
    g_earHog.threshold = BLINK_HOG_THRESHOLD;
#if EAR_LOCALIZER_VERSION >= 4
    const size_t refN = (size_t)EAR_REFINE_SIDE * EAR_REFINE_SIDE;
    g_earRefGray = (uint8_t *)heap_caps_malloc(refN, MALLOC_CAP_SPIRAM);
    g_earRefMask = (uint8_t *)heap_caps_malloc(refN, MALLOC_CAP_SPIRAM);
    g_earRefRow  = (uint16_t *)heap_caps_malloc(refN * sizeof(uint16_t),
                                                MALLOC_CAP_SPIRAM);
    if (!g_earRefGray || !g_earRefMask || !g_earRefRow) {
      // Not fatal: refine() no-ops on a null buffer and the lock falls back to
      // the raw motion peak, which is exactly v3's behaviour.
      earPrintf("#WARN: EAR refine buffers unavailable -- v4 re-centre disabled\n");
    }
#endif
    if (!g_earRgbBuf || !g_earGrayBuf) {
      earPrintf("#ERROR: EAR buffer alloc failed -- on-device blink detection disabled\n");
      g_earDisabled = true;
      return;
    }
  }
  if (g_earDisabled) return;
  if (w != g_earFullW || h != g_earFullH) return;  // frame size changed mid-session, skip

  // Full-scale RGB888. A half-scale jpg2rgb565(JPG_SCALE_2X) path was tried
  // to cut this cost and MEASURED ON HARDWARE at ~267 ms per call -- nearly
  // 3x SLOWER than this full-scale decode's ~97 ms, not 4x faster as the
  // pixel count suggested. Do not "optimise" it back to a scaled decode
  // without profiling again.
  if (!fmt2rgb888(fb->buf, fb->len, PIXFORMAT_JPEG, g_earRgbBuf)) {
    // A decode failure used to return in total silence, so a build where EVERY
    // frame failed to decode looked identical to one that was simply still
    // accumulating: perfect video, perfect sensors, and no eye output ever.
    // Report it, throttled, so that state is visible.
    static uint32_t decodeFails = 0;
    if (++decodeFails % 20 == 1) {
      earPrintf("#WARN: EAR jpeg decode failed (%lu so far)\n",
                    (unsigned long)decodeFails);
    }
    return;  // try again next frame
  }

#if defined(EAR_ROI_MANUAL_X)
  if (!g_earRoi.locked) {
    g_earRoi.x = EAR_ROI_MANUAL_X;
    g_earRoi.y = EAR_ROI_MANUAL_Y;
    g_earRoi.size = EAR_ROI_SIZE;
    g_earRoi.locked = true;
    g_earLockDone = true;
    g_earRoiSource = "manual";
    earPrintf("#STATUS: EAR ROI manual at x=%d y=%d size=%d conf=-1.00\n",
                  g_earRoi.x, g_earRoi.y, g_earRoi.size);
  }
#endif

  // Stored coordinate from the PC (see earStoredRoi* above). Applied on the
  // first frame, so detection runs from the start of the session instead of
  // after a ~20 s search.
  if (!g_earLockDone && g_earStoredCx >= 0) {
    float xs[1] = {(float)g_earStoredCx}, ys[1] = {(float)g_earStoredCy};
    EyeBlinkEAR::lockRoiFromSamples(xs, ys, 1, EAR_ROI_SIZE, w, h, g_earRoi);
    g_earLockDone = true;
    g_earLockConfidence = -1.0f;      // not measured: this ROI was given, not found
    g_earRoiSource = "stored";
    earPrintf("#STATUS: EAR ROI stored at x=%d y=%d size=%d conf=-1.00\n",
                  g_earRoi.x, g_earRoi.y, g_earRoi.size);
  }

  if (!g_earLockDone) {
    // Progress while the localizer accumulates. Without this the lock phase is
    // completely silent until it succeeds or is rejected, which on a build
    // that never reaches either is indistinguishable from the pipeline not
    // running at all -- exactly the ambiguity that made a live preview session
    // impossible to interpret.
    static uint32_t lastLockReport = 0;
    if (timestampMs - lastLockReport >= 2000) {
      lastLockReport = timestampMs;
      earPrintf("#EARLOCK: accumulating frames=%d elapsed=%lums tries=%d\n",
                    g_earLocator.framesAccumulated,
                    (unsigned long)(g_earLocator.haveTime
                                    ? (g_earLocator.lastMs - g_earLocator.firstMs) : 0),
                    g_earMotionTries);
    }

    // Full-frame motion energy -- no assumption about where in the frame
    // the eye sits (session_023 found it was NOT centered).
    earExtractGray(g_earRgbBuf, w, h, 0, 0, w, h, g_earGrayBuf);
#if EAR_LOCALIZER_VERSION >= 2
    // Tell v2+ the ROI size so it can reject a peak whose ROI would hang off
    // the frame, instead of clamping it inward the way v1 did. Cheap enough
    // to set every frame; v1 has no such setter, by design.
    g_earLocator.setRoiSize(EAR_ROI_SIZE);
#endif
#if EAR_LOCALIZER_VERSION >= 3
    // v3 measures its lock window on the wall clock, so it needs the frame's
    // timestamp. Without one it would silently fall back to frame counting.
    g_earLocator.addFrame(g_earGrayBuf, w, h, timestampMs);
#else
    g_earLocator.addFrame(g_earGrayBuf, w, h);
#endif

    float mcx, mcy, conf;
    if (g_earLocator.peak(w, h, EAR_MOTION_MIN_FRAMES, mcx, mcy, conf)) {
      if (conf >= EAR_MOTION_MIN_CONF || ++g_earMotionTries >= EAR_MOTION_MAX_TRIES) {
#if EAR_LOCALIZER_VERSION >= 4
        // Motion energy peaks on the moving eyelid, a few pixels off the
        // pupil. Re-centre before locking so the detector's cues are taken
        // over a crop the pupil sits in the middle of.
        g_earLocator.refine(g_earGrayBuf, w, h,
                            g_earRefGray, g_earRefMask, g_earRefRow, mcx, mcy);
#endif
        float xs[1] = {mcx}, ys[1] = {mcy};
        EyeBlinkEAR::lockRoiFromSamples(xs, ys, 1, EAR_ROI_SIZE, w, h, g_earRoi);
        g_earLockDone = true;
        g_earLockConfidence = conf;
        g_earRoiSource = "motion";
        earPrintf("#STATUS: EAR ROI motion-locked at x=%d y=%d size=%d conf=%.2f (%d tries)\n",
                      g_earRoi.x, g_earRoi.y, g_earRoi.size, conf, g_earMotionTries + 1);
      } else {
        earPrintf("#STATUS: EAR motion lock rejected conf=%.2f (<%.2f), retrying\n",
                      conf, EAR_MOTION_MIN_CONF);
        g_earLocator.reset();
      }
    }
    return;
  }

  earDriftTick(w, h, timestampMs);

  earExtractGray(g_earRgbBuf, w, h, g_earRoi.x, g_earRoi.y,
                 g_earRoi.size, g_earRoi.size, g_earGrayBuf);
  // Blink detection is glint-based, not shape-based. Every shape metric
  // tried before this (whole-mask moments, largest-component moments,
  // contour+fitEllipse) was validated against real footage and found to
  // track lighting gradients across the iris and crop-edge clipping rather
  // than eyelid state -- all of them fired on a wide-open eye. The corneal
  // reflection simply vanishes when the lid covers the cornea, which none
  // of those failure modes affect. See GlintBlinkDetector's doc comment.
  int glintPx = 0, roiBrightness = 0;
  EyeBlinkEAR::glintAndBrightness(
      g_earGrayBuf, g_earRoi.size, g_earRoi.size,
      EyeBlinkEAR::GlintBlinkDetector::GLINT_LEVEL, glintPx, roiBrightness);

  // Cue 3 input: dark-pupil presence in a WIDER neighbourhood than the glint
  // ROI. Distinguishes a real closure (pupil gone) from a gaze shift (pupil
  // merely moved out of the ROI) -- see countDarkPixels()'s doc comment.
  const int WIDE_PAD = EAR_ROI_SIZE / 2;
  int wx = g_earRoi.x - WIDE_PAD, wy = g_earRoi.y - WIDE_PAD;
  int ww = g_earRoi.size + 2 * WIDE_PAD, wh = g_earRoi.size + 2 * WIDE_PAD;
  earExtractGray(g_earRgbBuf, w, h, wx, wy, ww, wh, g_earGrayBuf);
  int wideDarkPx = EyeBlinkEAR::countDarkPixels(
      g_earGrayBuf, ww, wh,
      EyeBlinkEAR::GlintBlinkDetector::DARK_OFFSET_BELOW_MEAN);

  if (g_earGlint.update(glintPx, roiBrightness, wideDarkPx, timestampMs)) {
    earPrintf("#STATUS: blink (glint) t=%u\n", timestampMs);
    logBlinkEvent(timestampMs, "glint", false, 0.0f);
  }
  // The glint result is logged above for comparison only; it no longer feeds blink_rate.

  // Per-frame classifier on a crop holding both lids -- the same calls
  // tools/session_replay makes, so its replay results carry over.
#if defined(EAR_PROFILE) || defined(FRAME_INJECT_MODE)
  uint32_t tHog0 = (uint32_t)micros();
#endif
  int hx, hy, hw, hh;
  EyeBlinkEAR::hogCropRect(g_earRoi, hx, hy, hw, hh);
  earExtractGray(g_earRgbBuf, w, h, hx, hy, hw, hh, g_earGrayBuf);
  EyeBlinkEAR::boxResample(g_earGrayBuf, hw, hh, g_earHogSmall,
                           EyeBlinkEAR::HOG_W, EyeBlinkEAR::HOG_H);
  EyeBlinkEAR::hogFeatures(g_earHogSmall, g_earHogFeat);
#if defined(BLINK_HOG_BGSUB)
  // Two dot products and one float of state: see HogBackground / train_blink_bgsub.py.
  float hogA = EyeBlinkEAR::linearScore(g_earHogFeat, BLINK_HOG_WEIGHTS, 0.0f);
  float hogC = EyeBlinkEAR::linearScore(g_earHogFeat, BLINK_HOG_WEIGHTS_BG, 0.0f);
  float hogScore = hogA - g_earHogBg.update(hogC, BLINK_HOG_BG_ALPHA) + BLINK_HOG_BIAS;
  bool hogGated = g_earHogBg.settling(BLINK_HOG_BG_WARMUP_FRAMES);   // template still forming: hold detections off
#else
  float hogScore = EyeBlinkEAR::linearScore(g_earHogFeat, BLINK_HOG_WEIGHTS, BLINK_HOG_BIAS);
  const bool hogGated = false;
#endif
  if (g_earHog.update(hogScore, hogGated)) {
    g_earHogRate.push(timestampMs);
    if (g_earBlinksSinceLock < 255) g_earBlinksSinceLock++;
    g_earHogBlinkTotal++;
    earPrintf("#STATUS: blink (hog) t=%u score=%.2f\n", timestampMs, hogScore);
    logBlinkEvent(timestampMs, "hog", true, hogScore);
  }
  // 3-minute smoothed rate, measured from the lock (BlinkRateWindow explains why not 60 s).
  g_onDeviceBlinkRate = g_earHogRate.smoothedBpm(timestampMs, g_earValidSinceMs ? g_earValidSinceMs : timestampMs);
  // The classifier needs no baseline, so the channel is live from the first frame
  // after the ROI lock (the lock phase returns early above); loop() then waits out
  // EAR_BLINK_WARMUP_MS before trusting the 60 s count.
  g_earLastFrameMs = timestampMs;
  // Only stamp while the lock this frame was decoded against still holds:
  // loop() (a phone/serial ROI change, or armingBegin) can drop the lock and
  // zero g_earValidSinceMs while this frame is still being processed on the
  // old box. Stamping anyway would start the eye-check window at the tap
  // instead of at the new lock (and a ~20 s motion search would eat most of
  // the 30 s window).
  if (g_earValidSinceMs == 0 && g_earLockDone) g_earValidSinceMs = timestampMs ? timestampMs : 1;  // 0 = "not yet"
#if defined(EAR_PROFILE) || defined(FRAME_INJECT_MODE)
  g_earProfHogUs += (uint32_t)micros() - tHog0;
#endif
}
#endif  // STORAGE_MODE_SD || EAR_LIVE_DEBUG

// ── Frame injection mode: PC feeds recorded JPEGs one at a time; the ESP
// runs the SAME processEarFrame() a live capture would, on the real chip,
// so pre-recorded footage can validate the actual compiled binary instead
// of a PC recompile of the same algorithm (see session_replay tool for
// that PC-side variant). No live camera task runs in this mode -- Serial
// is exclusively the injection protocol's, so it must not also be drained
// by the "BLINK:%f" text parser in loop() (see that block's own guard).
#if defined(FRAME_INJECT_MODE)
static const uint8_t INJECT_SOF[4] = {0xAA, 0xBB, 0xCC, 0xDD};
static const uint8_t INJECT_EOF[4] = {0xDD, 0xCC, 0xBB, 0xAA};

// Blocking read of exactly n bytes, tolerant of USB CDC arriving in small
// chunks. Returns false on a 5s stall (lets the caller resync on SOF
// rather than wedge forever on a dropped/corrupt packet).
static bool injectReadExact(uint8_t *dst, size_t n) {
  size_t got = 0;
  uint32_t lastProgress = millis();
  while (got < n) {
    int avail = Serial.available();
    if (avail > 0) {
      size_t want = n - got;
      int toRead = (int)((size_t)avail < want ? (size_t)avail : want);
      int r = Serial.readBytes((char *)(dst + got), toRead);
      if (r > 0) {
        got += (size_t)r;
        lastProgress = millis();
      }
    } else {
      // No bytes yet -- yield so IDLE0 gets scheduled (same watchdog trap
      // cameraTask's own yield comment describes: a tight poll loop with
      // no delay starves IDLE0 on Core 0 and the task watchdog aborts).
      vTaskDelay(pdMS_TO_TICKS(1));
      if (millis() - lastProgress > 5000) return false;
    }
  }
  return true;
}

void frameInjectTask(void *arg) {
  Serial.println(F("#STATUS: Frame-injection mode ready. Waiting for frames..."));
  static uint8_t *jpegBuf = nullptr;
  static size_t   jpegBufCap = 0;

  while (true) {
    uint8_t sof[4];
    if (!injectReadExact(sof, 4)) continue;
    if (memcmp(sof, INJECT_SOF, 4) != 0) continue;  // resync byte-by-byte

    uint8_t header[16];  // ts(4) + width(4) + height(4) + jpeg_len(4), all LE u32
    if (!injectReadExact(header, sizeof(header))) continue;
    uint32_t ts, w, h, len;
    memcpy(&ts,  header,      4);
    memcpy(&w,   header + 4,  4);
    memcpy(&h,   header + 8,  4);
    memcpy(&len, header + 12, 4);

    if (len == 0 || len > 400000) {
      Serial.println(F("#ERROR: bad frame length, resyncing"));
      continue;
    }
    if (len > jpegBufCap) {
      if (jpegBuf) free(jpegBuf);
      jpegBuf = (uint8_t *)heap_caps_malloc(len, MALLOC_CAP_SPIRAM);
      jpegBufCap = jpegBuf ? len : 0;
    }
    if (!jpegBuf || !injectReadExact(jpegBuf, len)) {
      Serial.println(F("#ERROR: frame read failed, resyncing"));
      continue;
    }
    uint8_t eof[4];
    if (!injectReadExact(eof, 4) || memcmp(eof, INJECT_EOF, 4) != 0) {
      Serial.println(F("#ERROR: bad EOF marker, resyncing"));
      continue;
    }

    camera_fb_t fb = {};
    fb.buf    = jpegBuf;
    fb.len    = len;
    fb.width  = w;
    fb.height = h;
    fb.format = PIXFORMAT_JPEG;

    // ear = decode + localizer/glint + classifier for this frame; hog/drift =
    // their share of it. On the camera board the same work sits inside
    // cameraTask's per-frame budget (see its #PROF line).
    g_earProfHogUs = 0;
    g_earProfDriftUs = 0;
    uint32_t tEar0 = (uint32_t)micros();
    processEarFrame(&fb, ts);
    uint32_t earUs = (uint32_t)micros() - tEar0;
    Serial.printf("#FRAME_DONE ts=%u ear=%luus hog=%luus drift=%luus\n", ts,
                  (unsigned long)earUs, (unsigned long)g_earProfHogUs,
                  (unsigned long)g_earProfDriftUs);
  }
}
#endif  // FRAME_INJECT_MODE

// ── USB mode: binary frame constants ─────────────────────────────────────
#if defined(STORAGE_MODE_USB)
static const uint8_t FRAME_SOF[4] = {0xAA, 0xBB, 0xCC, 0xDD};
static const uint8_t FRAME_EOF[4] = {0xDD, 0xCC, 0xBB, 0xAA};
#endif

// Nodding Oscillation Detector: see NodDetector.h (6 s x 10 Hz pitch ring buffer).

// ─────────────────────────────────────────────────────────────────────────
// Gyro Variance Rolling Buffer
// 10-second rolling buffer of head_movement magnitude at 10 Hz → 100 samples.
// variance() feeds gyro_Stable / gyro_Fidgety input MFs of the FIS.
// ─────────────────────────────────────────────────────────────────────────
struct GyroVarBuf {
    static const uint8_t N = 100;   // 10 s × 10 Hz
    float   buf[N];
    uint8_t head;
    uint8_t count;

    GyroVarBuf() : head(0), count(0) { memset(buf, 0, sizeof(buf)); }

    void push(float v) {
        buf[head] = v;
        head      = (head + 1) % N;
        if (count < N) count++;
    }

    float variance() const {
        if (count < 2) return 0.0f;
        float mean = 0.0f;
        for (uint8_t i = 0; i < count; i++) {
            uint8_t idx = (count < N) ? i : (uint8_t)((head + i) % N);
            mean += buf[idx];
        }
        mean /= (float)count;
        float var = 0.0f;
        for (uint8_t i = 0; i < count; i++) {
            uint8_t idx = (count < N) ? i : (uint8_t)((head + i) % N);
            float d = buf[idx] - mean;
            var += d * d;
        }
        return var / (float)count;
    }
};

// ─────────────────────────────────────────────────────────────────────────
// FIS globals
// ─────────────────────────────────────────────────────────────────────────

FuzzyFatigue g_fis;
float g_riskScore  = 0.0f;
int   g_alertLevel = ALERT_SAFE;   // raw fuzzy-model alert, logged as alert_level
int   g_alertGated = ALERT_SAFE;   // after dwell/hold (AlertGate.h): drives the buzzer, logged as alert_gated
AlertGate g_alertGate;

// ── Baseline HR (count-based, frozen once HrBaseline has SKIP+N valid readings) ─
// "valid" = signal_quality==1 AND currentBPM>0 (implicitly 30–120 BPM by
// beat detection: MIN_BEAT_INTERVAL=500 ms, MAX_BEAT_INTERVAL=2000 ms).
// Frozen — not rolling — so progressive drowsiness is NOT normalised out.
// HrBaseline.h skips the first SKIP readings (pulse channel settling) and takes the
// median of the next N, so it needs SKIP+N = 30 valid seconds with good contact.
HrBaseline g_hrBase;
float    g_baselineBPM    = 0.0f;
bool     g_baselineFormed = false;

// ── BLINK serial receive state ─────────────────────────────────────────────
// Parser drains UART ring buffer at each 1 Hz tick. Format: "BLINK:<float>\n"
// Default 13.0 bl/min = centre of Normal MF flat-top (8–18) → no false Warning.
// Sticky fallback: hold last valid after BLINK_TIMEOUT_MS of silence.
static const uint32_t BLINK_TIMEOUT_MS = 5000;
float    g_blinkRate        = 13.0f;
float    g_lastValidBlink   = 13.0f;
uint32_t g_lastBlinkRxTime  = 0;
bool     g_blinkEverRx      = false;
bool     g_blinkValid       = true;   // false = blink channel offline; FIS ignores blink (see loop())
char     g_serialLineBuf[32];
uint8_t  g_serialLineBufLen = 0;

// ── Calibration gravity vector (raw ADC units, captured after calibrateMPU) ─
// dot-product pitch formula:
//   pitch = acos(dot(g_calibGrav, g_now) / (|g_calibGrav| × |g_now|)) × (180/π)
// Default assumes vertical Z axis; overwritten by calibrateMPU().
float g_calibGrav[3] = {0.0f, 0.0f, 16384.0f};

// ── Cached 10 Hz IMU snapshot (written by 10 Hz block, read at 1 Hz FIS tick) ─
float g_imu_ax_g      = 0.0f;
float g_imu_ay_g      = 0.0f;
float g_imu_az_g      = 0.0f;
float g_imu_gx_dp     = 0.0f;
float g_imu_gy_dp     = 0.0f;
float g_imu_gz_dp     = 0.0f;
float g_imu_head_mov  = 0.0f;
float g_imu_pitch_deg = 0.0f;
float g_imu_gyro_var  = 0.0f;
float g_imu_nod_score = 0.0f;
// Freshness of the cached snapshot above: false while reads are suspended
// (buzzer active) or the bus is down, meaning g_imu_* are frozen last-known-good
// values rather than a live reading.
bool     g_imuSampleValid   = false;
uint32_t g_lastImuValidTime = 0;

// ── 10 Hz ring buffer instances ───────────────────────────────────────────────
NodDetector g_nodDet;    //  60 samples × 4 B =  240 B BSS
GyroVarBuf  g_gyroVar;   // 100 samples × 4 B =  400 B BSS
                          // Total: ~640 B — negligible on ESP32-S3 (512 KB SRAM)

// ─────────────────────────────────────────────────────────────────────────
// CRC-32 (standard Ethernet polynomial 0xEDB88320)
// Matches Python: binascii.crc32(data) & 0xFFFFFFFF
// On ESP32-S3 @ 240 MHz: ~0.2 ms per 10 KB QVGA frame — negligible.
// ─────────────────────────────────────────────────────────────────────────

static uint32_t crc32_compute(const uint8_t *buf, size_t len) {
  uint32_t crc = 0xFFFFFFFFu;
  for (size_t i = 0; i < len; i++) {
    crc ^= buf[i];
    for (int j = 0; j < 8; j++)
      crc = (crc >> 1) ^ (0xEDB88320u & -(crc & 1u));
  }
  return ~crc;
}

// ─────────────────────────────────────────────────────────────────────────
// SD Card helpers (SD mode only)
// ─────────────────────────────────────────────────────────────────────────

#if defined(STORAGE_MODE_SD)

bool initSDCard() {
  // Set SD_MMC pins before mounting (ESP32-S3 Arduino core ≥ 2.0.14)
  SD_MMC.setPins(SD_MMC_CLK_PIN, SD_MMC_CMD_PIN, SD_MMC_D0_PIN);

  // Mount in 1-bit mode (D0 only); format_if_fail = false
  if (!SD_MMC.begin("/sdcard", true, false)) {
    Serial.println(F("#ERROR: SD card mount failed — insert card and reset"));
    return false;
  }

  uint64_t cardSizeMB = SD_MMC.cardSize() / (1024ULL * 1024ULL);
  uint64_t freeMB =
      SD_MMC.totalBytes() > SD_MMC.usedBytes()
          ? (SD_MMC.totalBytes() - SD_MMC.usedBytes()) / (1024ULL * 1024ULL)
          : 0;
  Serial.printf("#STATUS: SD card mounted OK — %llu MB total, %llu MB free\n",
                cardSizeMB, freeMB);

  // Session creation deliberately does NOT happen here. It moved to
  // openSession(), called when RECORDING actually begins, so each
  // arm-record-stop cycle gets its own session_XXX folder. Creating the files
  // at boot bound a "session" to a power cycle and made a second recording
  // append into the first one's files, silently corrupting the dataset.
  return true;
}

// ─────────────────────────────────────────────────────────────────────────
// openSession() — create session_XXX and open its three files.
//
// Called at the ARMING -> RECORDING transition, not at boot, so the readiness
// of each subsystem is known and can be recorded in metadata.txt alongside the
// capture parameters. Returns false if any file could not be opened.
// ─────────────────────────────────────────────────────────────────────────
bool openSession() {
  if (!g_sdReady) return false;

  // ── Find next session number ─────────────────────────────────────────
  if (!SD_MMC.exists("/sessions")) {
    SD_MMC.mkdir("/sessions");
  }

  int sessionNum = 1;
  char sessionDir[40];
  while (true) {
    snprintf(sessionDir, sizeof(sessionDir), "/sessions/session_%03d",
             sessionNum);
    if (!SD_MMC.exists(sessionDir))
      break;
    sessionNum++;
  }

  // ── Create session directory (no frames/ subdir needed — MJPEG stream) ─
  SD_MMC.mkdir(sessionDir);
  Serial.printf("#STATUS: Session: %s\n", sessionDir);

  // ── Write metadata.txt ───────────────────────────────────────────────
  char metaPath[52];
  snprintf(metaPath, sizeof(metaPath), "%s/metadata.txt", sessionDir);
  File meta = SD_MMC.open(metaPath, FILE_WRITE);
  if (meta) {
    meta.printf("mode=production_sd\n");
    meta.printf("camera_fps=%d\n", CAMERA_FPS);
    // Resolution string derived from the framesize constant
    const char *resStr =
#if defined(CAMERA_FRAMESIZE) && CAMERA_FRAMESIZE == FRAMESIZE_VGA
        "640x480";
#elif defined(CAMERA_FRAMESIZE) && CAMERA_FRAMESIZE == FRAMESIZE_HVGA
        "480x320";
#elif defined(CAMERA_FRAMESIZE) && CAMERA_FRAMESIZE == FRAMESIZE_CIF
        "400x296";
#else
        "320x240"; // QVGA fallback
#endif
    meta.printf("camera_resolution=%s\n", resStr);
    meta.printf("video_file=video.mjpeg\n");
    meta.printf("index_file=video.idx\n");
    meta.printf("sensor_sample_rate=10Hz\n");
    meta.printf("mpu_address=0x68\n");
    meta.printf("pulse_pin=1\n");
    meta.printf("sd_cmd_pin=%d\n", SD_MMC_CMD_PIN);
    meta.printf("sd_clk_pin=%d\n", SD_MMC_CLK_PIN);
    meta.printf("sd_d0_pin=%d\n", SD_MMC_D0_PIN);

    // Readiness at the moment recording began. A 0 here means that subsystem
    // never went ready within ARMING_TIMEOUT_MS and the session started
    // anyway -- the data is still recorded, but this says which channels to
    // distrust rather than leaving it to be guessed later.
    meta.printf("armed_imu=%d\n", g_readyImu ? 1 : 0);
    meta.printf("armed_hr=%d\n",  g_readyHr  ? 1 : 0);
    meta.printf("armed_eye=%d\n", g_readyEye ? 1 : 0);
    meta.printf("eye_check=%s\n", g_eyeCheck == EYECHECK_PASS ? "pass" :
                                  g_eyeCheck == EYECHECK_FAIL ? "fail" : "pending");
    meta.printf("eye_check_blinks=%u\n", (unsigned)g_earBlinksSinceLock);
    meta.printf("arming_timed_out=%d\n", g_armTimedOut ? 1 : 0);
#if defined(PHONE_PREVIEW)
    // Wi-Fi stays on for this many seconds from the start of the recording,
    // then goes off; pulse/HR in that window may carry radio noise.
    meta.printf("phone_preview_wifi_on_s=%lu\n", (unsigned long)(PHONE_WIFI_OFF_AFTER_MS / 1000));
#endif
    // Where the eye crop came from. A "stored" ROI is only as good as the
    // arming check that confirmed it, so a session that reports no blinks can
    // be told apart from one whose ROI was pointing at a cheek.
    meta.printf("roi_source=%s\n", g_earRoiSource);
    meta.printf("roi_x=%d\n", g_earRoi.x);
    meta.printf("roi_y=%d\n", g_earRoi.y);
    meta.printf("roi_size=%d\n", g_earRoi.size);
    meta.printf("arming_duration_ms=%lu\n",
                (unsigned long)(millis() - g_armStartMs));
    meta.close();
  }

  // ── Open sensor_data.csv ─────────────────────────────────────────────
  char csvPath[56];
  snprintf(csvPath, sizeof(csvPath), "%s/sensor_data.csv", sessionDir);
  g_csvFile = SD_MMC.open(csvPath, FILE_WRITE);
  if (!g_csvFile) {
    Serial.println(F("#ERROR: Could not open sensor_data.csv on SD"));
    return false;
  }

  // ── Open video.mjpeg (sequential JPEG stream) ─────────────────────────
  char mjpegPath[56];
  snprintf(mjpegPath, sizeof(mjpegPath), "%s/video.mjpeg", sessionDir);
  g_mjpegFile = SD_MMC.open(mjpegPath, FILE_WRITE);
  if (!g_mjpegFile) {
    Serial.println(F("#ERROR: Could not open video.mjpeg on SD"));
    return false;
  }

  // ── Open video.idx and write header ──────────────────────────────────
  char idxPath[52];
  snprintf(idxPath, sizeof(idxPath), "%s/video.idx", sessionDir);
  g_idxFile = SD_MMC.open(idxPath, FILE_WRITE);
  if (!g_idxFile) {
    Serial.println(F("#ERROR: Could not open video.idx on SD"));
    return false;
  }
  g_idxFile.println(
      F("frame_index,timestamp_ms,byte_offset,frame_size,crc32_hex"));

  // ── Open blink_events.csv (not fatal if it cannot be opened) ──────────
  char blinkPath[56];
  snprintf(blinkPath, sizeof(blinkPath), "%s/blink_events.csv", sessionDir);
  g_blinkFile = SD_MMC.open(blinkPath, FILE_WRITE);
  if (g_blinkFile) {
    g_blinkFile.println(F("timestamp_ms,source,score"));
    g_blinkFile.flush();
  } else {
    Serial.println(F("#ERROR: Could not open blink_events.csv on SD -- blink events will not be logged"));
  }

  // Reset session-level counters
  g_byteOffset = 0;
  g_frameIndex = 0;

  Serial.printf("#STATUS: MJPEG stream: %s\n", mjpegPath);
  Serial.printf("#STATUS: Index file : %s\n", idxPath);

  return true;
}


// ─────────────────────────────────────────────────────────────────────────
// closeSession() — flush + close all SD files before power-off / card removal.
// Call this on any graceful shutdown (GPIO button, low-battery ISR, etc.).
// ─────────────────────────────────────────────────────────────────────────
void closeSession() {
  if (xSemaphoreTake(g_sdMutex, portMAX_DELAY) == pdTRUE) {
    if (g_mjpegFile) {
      g_mjpegFile.flush();
      g_mjpegFile.close();
    }
    if (g_idxFile) {
      g_idxFile.flush();
      g_idxFile.close();
    }
    if (g_csvFile) {
      g_csvFile.flush();
      g_csvFile.close();
    }
    if (g_blinkFile) {
      g_blinkFile.flush();
      g_blinkFile.close();
    }
    xSemaphoreGive(g_sdMutex);
  }
  Serial.println(F("#STATUS: Session closed — safe to remove SD card."));
}

// ─────────────────────────────────────────────────────────────────────────
// saveJpegToSD() — append one JPEG frame to video.mjpeg, log to video.idx.
// Called from cameraTask on Core 0. Never opens or closes a file per frame.
// ─────────────────────────────────────────────────────────────────────────
void saveJpegToSD(const uint8_t *data, size_t len, uint32_t timestamp_ms) {
  if (!g_sdReady || !g_mjpegFile || !g_idxFile || !g_sessionActive)
    return;
  static int flushCounter = 0;

  uint32_t crc = crc32_compute(data, len);

  if (xSemaphoreTake(g_sdMutex, pdMS_TO_TICKS(50)) == pdTRUE) {

    // 1. Write JPEG bytes sequentially — check every byte was written
    size_t written = g_mjpegFile.write(data, len);
    if (written != len) {
      // SD full or I/O error: do NOT write an idx entry for this partial frame
      Serial.printf("#ERROR: SD write failed (wrote %zu of %zu B) "
                    "— frame %lu dropped. SD full?\n",
                    written, len, g_frameIndex);
      xSemaphoreGive(g_sdMutex);
      return;
    }

    // 2. Write sidecar index line
    //    columns: frame_index, timestamp_ms, byte_offset, frame_size, crc32_hex
    g_idxFile.printf("%lu,%lu,%lu,%zu,%08lx\n", g_frameIndex, timestamp_ms,
                     g_byteOffset, len, (unsigned long)crc);

    // 3. Advance session counters
    g_byteOffset += (uint32_t)len;
    g_frameIndex++;

    // 4. Flush both files every 30 frames (~1 second at 30 FPS)
    //    Flushing less often maximises SD sequential write throughput.
    if (++flushCounter % 30 == 0) {
      g_mjpegFile.flush();
      g_idxFile.flush();
    }

    xSemaphoreGive(g_sdMutex);
  }
  // If mutex not acquired within 50 ms, frame is silently dropped
  // (the camera will capture the next frame on schedule regardless)
}

#endif // STORAGE_MODE_SD

// ─────────────────────────────────────────────────────────────────────────
// USB mode: send JPEG as binary packet over Serial
// ─────────────────────────────────────────────────────────────────────────

#if defined(STORAGE_MODE_USB)
void sendJpegFrame(const uint8_t *data, size_t len, uint32_t timestamp_ms) {
  uint32_t length32 = (uint32_t)len;
  // Timeout 20ms: if sensor output holds the mutex, skip this frame
  if (xSemaphoreTake(g_serialMutex, pdMS_TO_TICKS(20)) == pdTRUE) {
    Serial.write(FRAME_SOF, 4);
    Serial.write((const uint8_t *)&timestamp_ms, 4);
    Serial.write((const uint8_t *)&length32, 4);
    
    // Send in 1024-byte chunks and yield to let the USB CDC task run on Core 0
    size_t offset = 0;
    const size_t chunkSize = 1024;
    while (offset < len) {
      size_t toWrite = (len - offset < chunkSize) ? (len - offset) : chunkSize;
      Serial.write(data + offset, toWrite);
      offset += toWrite;
      vTaskDelay(1); // Yields CPU for 1ms
    }
    
    Serial.write(FRAME_EOF, 4);
    xSemaphoreGive(g_serialMutex);
  }
}
#endif

// ─────────────────────────────────────────────────────────────────────────
// Camera task — Core 0 @ 10 fps
// ─────────────────────────────────────────────────────────────────────────

void cameraTask(void *arg) {
  const TickType_t period = pdMS_TO_TICKS(1000 / CAMERA_FPS); // target FPS
  TickType_t lastWake = xTaskGetTickCount();
  uint32_t framesSent = 0;
  uint32_t framesDropped = 0;

  while (true) {
    vTaskDelayUntil(&lastWake, period);
    // vTaskDelayUntil does NOT block once the deadline has already passed,
    // and with fb_count=2 a frame is usually already queued so
    // esp_camera_fb_get() returns immediately too. With per-frame EAR work
    // (~97 ms) exceeding the period, that combination left this task with no
    // yield at all: IDLE0 on CPU 0 never ran and the task watchdog aborted
    // (observed as a boot loop). This unconditional short delay guarantees
    // the idle task gets scheduled every iteration no matter how the frame
    // timing lands.
    vTaskDelay(pdMS_TO_TICKS(5));

    camera_fb_t *fb = esp_camera_fb_get();
    if (fb) {
      if (fb->format == PIXFORMAT_JPEG) {
        uint32_t ts = (uint32_t)millis();

#if defined(STORAGE_MODE_SD)
        // Build with -DEAR_PROFILE to print the per-frame cost breakdown.
        // Off by default: it prints every 40 frames, which is serial noise
        // during a real recording. Kept because the numbers it produced are
        // what identified the watchdog cause (see cameraTask's yield note
        // and processEarFrame's decode-cost note) and will be needed again
        // if the camera resolution or pipeline cost changes.
#if defined(EAR_PROFILE)
        uint32_t tSd0 = (uint32_t)micros();
#endif
        saveJpegToSD(fb->buf, fb->len, ts);
#if defined(EAR_PROFILE)
        uint32_t tSd1 = (uint32_t)micros();
#endif
#if defined(PHONE_PREVIEW)
        // Before the ~97 ms EAR pass, so the phone gets the freshest frame.
        // Never while recording: the ride path stays as it is without Wi-Fi.
        // (Under EAR_PROFILE this copy, ~0.5 ms, lands in ear=.)
        if (g_sessionState != SESSION_RECORDING) PhonePreview::offerFrame(fb->buf, fb->len);
#endif
        if (++g_earFrameCounter % EAR_THROTTLE_DIV == 0) {
          processEarFrame(fb, ts);
        }
#if defined(EAR_PROFILE)
        uint32_t tEar1 = (uint32_t)micros();
        static uint32_t profCount = 0, profSd = 0, profEar = 0;
        profSd  += (tSd1 - tSd0);
        profEar += (tEar1 - tSd1);
        if (++profCount >= 40) {
          // hog=/drift= are the parts of ear= spent in the HOG classifier and
          // in drift correction -- drift now runs every frame (not once per
          // session like the boot lock), so its steady-state share is the
          // number that answers whether it fits.
          Serial.printf("#PROF: sd=%luus ear=%luus hog=%luus drift=%luus total=%luus budget=%dus\n",
                        (unsigned long)(profSd / profCount),
                        (unsigned long)(profEar / profCount),
                        (unsigned long)(g_earProfHogUs / profCount),
                        (unsigned long)(g_earProfDriftUs / profCount),
                        (unsigned long)((profSd + profEar) / profCount),
                        (int)(1000000 / CAMERA_FPS));
          profCount = profSd = profEar = 0;
          g_earProfHogUs = 0;
          g_earProfDriftUs = 0;
        }
#endif
#elif defined(STORAGE_MODE_USB)
        sendJpegFrame(fb->buf, fb->len, ts);
#if defined(EAR_LIVE_DEBUG)
        // Same on-device pipeline the SD build runs, just fed from the
        // frame we're also streaming out over serial instead of to SD.
        if (++g_earFrameCounter % EAR_THROTTLE_DIV == 0) {
          processEarFrame(fb, ts);
        }
#endif
#endif
        framesSent++;
      }
      esp_camera_fb_return(fb);
    } else {
      framesDropped++;
      if (framesDropped % 10 == 0) {
#if defined(STORAGE_MODE_USB)
        if (xSemaphoreTake(g_serialMutex, pdMS_TO_TICKS(10)) == pdTRUE) {
#endif
          Serial.printf("#WARNING: Camera frame drops=%lu\n",
                        (unsigned long)framesDropped);
#if defined(STORAGE_MODE_USB)
          xSemaphoreGive(g_serialMutex);
        }
#endif
      }
    }
  }
}

// ─────────────────────────────────────────────────────────────────────────
// readPulseSensor() — called at 500 Hz
// ─────────────────────────────────────────────────────────────────────────

void readPulseSensor() {
  unsigned long sensorNow = millis();

  int raw = analogRead(PULSE_PIN);
  lastPulseRaw = raw;

  // Single-pole IIR low-pass — α = 0.15 → f_c ≈ 12 Hz @ 500 Hz.
  // Hardware capacitor already removes DC bias, so no HP stage is needed.
  // This passes the PPG fundamental (0.5–3.5 Hz) while killing ADC noise,
  // and preserves the natural waveform shape for clean threshold detection.
  const float LP_ALPHA = 0.15f;
  iirLP += LP_ALPHA * ((float)raw - iirLP);
  int filtered = constrain((int)iirLP, 0, 4095);

  // Adaptive envelope tracker.
  // Peak/valley decay toward midpoint (2048) at ENVELOPE_DECAY rate.
  // τ ≈ 200 ms — fast enough to follow finger-pressure changes.
  if ((float)filtered > peakValue)
    peakValue = (float)filtered;
  else
    peakValue = peakValue * ENVELOPE_DECAY + 2048.0f * (1.0f - ENVELOPE_DECAY);
  if ((float)filtered < valleyValue)
    valleyValue = (float)filtered;
  else
    valleyValue =
        valleyValue * ENVELOPE_DECAY + 2048.0f * (1.0f - ENVELOPE_DECAY);

  dynamicThreshold = (int)((peakValue + valleyValue) / 2.0f);

  // Rising-edge beat detection with refractory period
  bool wasRising = risingSignal;
  risingSignal = (filtered > dynamicThreshold);

  if (!wasRising && risingSignal) {
    long interval = sensorNow - lastBeatTime;
    if (lastBeatTime > 0 && interval >= MIN_BEAT_INTERVAL &&
        interval <= MAX_BEAT_INTERVAL) {
      beatIntervals[beatIndex % BPM_BUFFER_SIZE] = interval;
      beatIndex++;
      int count = (beatIndex < BPM_BUFFER_SIZE) ? beatIndex : BPM_BUFFER_SIZE;
      long totalMs = 0;
      for (int i = 0; i < count; i++)
        totalMs += beatIntervals[i];
      currentBPM = (60000.0f * count) / (float)totalMs;
      lastBeatTime = sensorNow;
    } else if (lastBeatTime == 0) {
      lastBeatTime = sensorNow;
    }
  }

  // Timeout: no beat detected for BEAT_TIMEOUT_MS → reset BPM
  if (lastBeatTime > 0 && (sensorNow - lastBeatTime > BEAT_TIMEOUT_MS)) {
    currentBPM = 0;
    beatIndex = 0;
    lastBeatTime = 0;
  }

  // Signal quality:
  //   0 = no skin contact (raw out of expected ADC window)
  //   0 = weak/noisy signal (amplitude below minimum swing)
  //   1 = good contact with detectable pulse
  int amplitude = (int)(peakValue - valleyValue);
  if (raw < SIGNAL_LOW_THRESH || raw > SIGNAL_HIGH_THRESH) {
    lastSignalQuality = 0; // no contact
  } else if (amplitude >= MIN_AMPLITUDE) {
    lastSignalQuality = 1; // strong enough signal
  } else {
    lastSignalQuality = 0; // weak/noisy — was incorrectly 1 (bug fix)
  }
}

// ─────────────────────────────────────────────────────────────────────────
// Helpers
// ─────────────────────────────────────────────────────────────────────────

void blinkLED(int times) {
  if (LED_BUILTIN <= 0 || LED_BUILTIN == PIN_SDA || LED_BUILTIN == PIN_SCL) {
    return; // Avoid corrupting I2C bus pins (GPIO 2 / 3)
  }
  pinMode(LED_BUILTIN, OUTPUT);
  for (int i = 0; i < times; i++) {
    digitalWrite(LED_BUILTIN, HIGH);
    delay(150);
    digitalWrite(LED_BUILTIN, LOW);
    delay(150);
  }
}

void setBuzzerState(bool active) {
  // g_buzzerMuted silences the pin for quiet testing, but g_buzzerActive still
  // reflects real hardware state -- it only goes true when the buzzer is
  // actually drawing power, which is exactly when I2C reads must be suspended.
  g_buzzerActive = active && !g_buzzerMuted;
  digitalWrite(BUZZER_PIN, g_buzzerActive ? HIGH : LOW);
}

void calibrateMPU() {
  Serial.println(F("#STATUS: Keep sensor still for calibration..."));
  for (int c = 3; c > 0; c--) {
    Serial.print(F("#STATUS: Starting in "));
    Serial.print(c);
    Serial.println(F("s..."));
    delay(1000);
  }
  Serial.println(F("#STATUS: Calibrating... keep still"));

  int16_t ax, ay, az, gx, gy, gz;
  long ax_s = 0, ay_s = 0, az_s = 0;
  long gx_s = 0, gy_s = 0, gz_s = 0;

  for (int i = 0; i < CALIB_SAMPLES; i++) {
    mpu.getMotion6(&ax, &ay, &az, &gx, &gy, &gz);
    ax_s += ax;
    ay_s += ay;
    az_s += az;
    gx_s += gx;
    gy_s += gy;
    gz_s += gz;
    delay(5);
  }

  ax_off = ax_s / CALIB_SAMPLES;
  ay_off = ay_s / CALIB_SAMPLES;
  az_off = az_s / CALIB_SAMPLES;
  gx_off = gx_s / CALIB_SAMPLES;
  gy_off = gy_s / CALIB_SAMPLES;
  gz_off = gz_s / CALIB_SAMPLES;

  Serial.print(F("#STATUS: Calibration done. Offsets: ax="));
  Serial.print(ax_off);
  Serial.print(F(" ay="));
  Serial.print(ay_off);
  Serial.print(F(" az="));
  Serial.print(az_off);
  Serial.print(F(" gx="));
  Serial.print(gx_off);
  Serial.print(F(" gy="));
  Serial.print(gy_off);
  Serial.print(F(" gz="));
  Serial.println(gz_off);

  // Capture calibration gravity vector (raw ADC units) for pitch computation.
  // ax_off/ay_off/az_off are the mean raw readings at calibration pose, which
  // include the gravity component — exactly the reference vector we need.
  g_calibGrav[0] = (float)ax_off;
  g_calibGrav[1] = (float)ay_off;
  g_calibGrav[2] = (float)az_off;
  Serial.printf("#STATUS: Calib gravity vector: [%.0f, %.0f, %.0f] raw ADC\n",
                g_calibGrav[0], g_calibGrav[1], g_calibGrav[2]);
}
// ─────────────────────────────────────────────────────────────────────────
// ARMING support — non-blocking IMU calibration + per-session resets
//
// calibrateMPU() above blocks for ~4 s (a 3 s countdown plus 200 x delay(5)).
// That is fine at boot but unusable during ARMING: loop() also drives the
// 500 Hz pulse sampler and feeds the task watchdog, so stalling it for 4 s
// would punch a hole in the pulse record and risk a watchdog reset. This
// accumulates the same 200 samples from the loop cadence instead.
// ─────────────────────────────────────────────────────────────────────────

// Reject a calibration taken while the helmet is moving. Offsets captured
// mid-motion bake that motion into every later reading, and a rider settling
// onto the bike is exactly when arming happens. Thresholds are generous
// against this clone's ~3 dps gyro noise (see IMU_INTEGRATION.md section 2.3).
static const float   ARM_STILL_GYRO_DPS = 20.0f;  // vs running mean (~6 sigma)
static const float   ARM_STILL_AMAG_LO  = 0.85f;  // |A| band, g
static const float   ARM_STILL_AMAG_HI  = 1.15f;
static const uint8_t ARM_STILL_MIN_N    = 30;     // samples before mean is usable

struct ArmCalib {
  bool     running  = false;
  bool     done     = false;
  int      count    = 0;
  long     ax_s = 0, ay_s = 0, az_s = 0;
  long     gx_s = 0, gy_s = 0, gz_s = 0;
  uint32_t lastMs   = 0;
  uint16_t restarts = 0;
};
ArmCalib g_armCalib;

static void armCalibRestart() {
  g_armCalib.count = 0;
  g_armCalib.ax_s = g_armCalib.ay_s = g_armCalib.az_s = 0;
  g_armCalib.gx_s = g_armCalib.gy_s = g_armCalib.gz_s = 0;
}

static void armCalibBegin() {
  armCalibRestart();
  g_armCalib.running  = true;
  g_armCalib.done     = false;
  g_armCalib.restarts = 0;
  g_armCalib.lastMs   = 0;
}

// Call at >= 100 Hz from loop(). Returns true once offsets are committed.
static bool armCalibTick(uint32_t now) {
  if (!g_armCalib.running || g_armCalib.done) return g_armCalib.done;
  if (!g_mpuEnabled) return false;
  if (g_buzzerActive) return false;   // I2C unreliable while buzzer draws current
  if (now - g_armCalib.lastMs < 10) return false;   // 100 Hz
  g_armCalib.lastMs = now;

  int16_t ax, ay, az, gx, gy, gz;
  mpu.getMotion6(&ax, &ay, &az, &gx, &gy, &gz);

  // ── Stillness gate ──────────────────────────────────────────────────
  float amag = sqrtf((float)ax * ax + (float)ay * ay + (float)az * az) / ACCEL_SCALE;
  bool moving = (amag < ARM_STILL_AMAG_LO || amag > ARM_STILL_AMAG_HI);

  if (!moving && g_armCalib.count >= ARM_STILL_MIN_N) {
    float n   = (float)g_armCalib.count;
    float mgx = (g_armCalib.gx_s / n) / GYRO_SCALE;
    float mgy = (g_armCalib.gy_s / n) / GYRO_SCALE;
    float mgz = (g_armCalib.gz_s / n) / GYRO_SCALE;
    if (fabsf(gx / GYRO_SCALE - mgx) > ARM_STILL_GYRO_DPS ||
        fabsf(gy / GYRO_SCALE - mgy) > ARM_STILL_GYRO_DPS ||
        fabsf(gz / GYRO_SCALE - mgz) > ARM_STILL_GYRO_DPS) {
      moving = true;
    }
  }

  if (moving) {
    if (g_armCalib.count > 0) {
      g_armCalib.restarts++;
      armCalibRestart();
    }
    return false;
  }

  g_armCalib.ax_s += ax; g_armCalib.ay_s += ay; g_armCalib.az_s += az;
  g_armCalib.gx_s += gx; g_armCalib.gy_s += gy; g_armCalib.gz_s += gz;

  if (++g_armCalib.count < CALIB_SAMPLES) return false;

  ax_off = g_armCalib.ax_s / CALIB_SAMPLES;
  ay_off = g_armCalib.ay_s / CALIB_SAMPLES;
  az_off = g_armCalib.az_s / CALIB_SAMPLES;
  gx_off = g_armCalib.gx_s / CALIB_SAMPLES;
  gy_off = g_armCalib.gy_s / CALIB_SAMPLES;
  gz_off = g_armCalib.gz_s / CALIB_SAMPLES;

  // The mean raw accel at the calibration pose IS the gravity reference the
  // pitch formula needs -- same as calibrateMPU() captures.
  g_calibGrav[0] = (float)ax_off;
  g_calibGrav[1] = (float)ay_off;
  g_calibGrav[2] = (float)az_off;

  g_armCalib.running = false;
  g_armCalib.done    = true;
  Serial.printf("#STATUS: IMU calibrated for this session (%d motion restarts)\n",
                (int)g_armCalib.restarts);
  return true;
}

// ─────────────────────────────────────────────────────────────────────────
// signalState() — the single point every state change passes through.
//
// Serial only for now. LED_BUILTIN is GPIO 2, which is PIN_SDA, so it cannot
// be used as an indicator without corrupting the I2C bus, and the buzzer is
// physically disconnected on this rig. GPIO 47/48 are clear of the camera, SD,
// IMU, pulse and button pins -- wire an indicator there and drive it HERE.
// ─────────────────────────────────────────────────────────────────────────
void signalState(SessionState st) {
  switch (st) {
    case SESSION_IDLE:      Serial.println(F("#STATE: IDLE"));      break;
    case SESSION_ARMING:    Serial.println(F("#STATE: ARMING"));    break;
    case SESSION_RECORDING: Serial.println(F("#STATE: RECORDING")); break;
  }
}

// Enter ARMING. Every per-session quantity is cleared here so the session gets
// its own calibration instead of inheriting boot-time or previous-session values.
void armingBegin() {
  g_armStartMs  = millis();
  g_armTimedOut = false;
  g_readyImu = g_readyHr = g_readyEye = false;
  g_alertGate.reset();          // a new session starts with no dwell in progress
  g_alertGated = ALERT_SAFE;

  armCalibBegin();

  // Fresh HR baseline. Carrying the previous session's resting rate over would
  // skew hr_diff_pct for the whole of this recording.
  g_hrBase.reset();
  g_baselineFormed = false;

#if defined(STORAGE_MODE_SD) || defined(EAR_LIVE_DEBUG)
  // Drop the old ROI so the lock re-acquires against where the eye is now,
  // rather than reusing a crop from a previous head/camera position.
  g_earLockDone    = false;
  g_earRoi.locked  = false;
  g_earMotionTries = 0;
  g_earLocator.reset();
  g_earDriftState  = EAR_DRIFT_IDLE;   // g_earLocator is about to be reused for the boot search
  g_earValidSinceMs = 0;   // blink channel re-earns its "valid" after the new lock
  g_earLastFrameMs  = 0;
  g_earBlinksSinceLock = 0;
  g_eyeCheck        = EYECHECK_PENDING;
  g_earHogRate.n    = 0;   // the previous session's blinks must not count in this one's window
  g_earHog.openRun  = EyeBlinkEAR::HogBlinkDetector::REFRACTORY_FRAMES;
  g_earHogBg.reset();   // a new session/lock starts a fresh open-eye template
  g_onDeviceBlinkRate = 0.0f;
#endif

  g_sessionState  = SESSION_ARMING;
  g_sessionActive = false;
  signalState(SESSION_ARMING);
  Serial.println(F("#STATUS: Arming -- hold still, eye toward camera, finger on pulse sensor"));
}

// Enter RECORDING. Latches readiness, opens the session files, starts writing.
void recordingBegin() {
#if defined(STORAGE_MODE_SD) || defined(EAR_LIVE_DEBUG)
  g_readyEye = (g_eyeCheck == EYECHECK_PASS);   // locked AND seen to blink
#else
  g_readyEye = true;   // no EAR pipeline in this build
#endif
  g_readyImu = g_armCalib.done;
  g_readyHr  = g_baselineFormed;

#if defined(STORAGE_MODE_SD)
  if (!openSession()) {
    Serial.println(F("#ERROR: Could not open session files -- staying idle"));
    g_sessionState  = SESSION_IDLE;
    g_sessionActive = false;
    signalState(SESSION_IDLE);
    return;
  }
#endif

  g_sessionState  = SESSION_RECORDING;
  g_sessionActive = true;
  signalState(SESSION_RECORDING);
  Serial.printf("#STATUS: Recording -- imu=%d hr=%d eye=%d timed_out=%d after %lu ms\n",
                g_readyImu ? 1 : 0, g_readyHr ? 1 : 0, g_readyEye ? 1 : 0,
                g_armTimedOut ? 1 : 0,
                (unsigned long)(millis() - g_armStartMs));
}

// Return to IDLE from any state, closing the session files if they are open.
void sessionStop(const char *reason) {
  bool wasRecording = (g_sessionState == SESSION_RECORDING);

  g_sessionState  = SESSION_IDLE;
  g_sessionActive = false;
  g_armCalib.running = false;

#if defined(STORAGE_MODE_SD)
  if (wasRecording) {
    // Report what actually landed on the card. A session that ran but wrote
    // zero frames or zero CSV rows is a silent failure otherwise.
    Serial.printf("#STATUS: Wrote %lu frames, %lu video bytes\n",
                  (unsigned long)g_frameIndex, (unsigned long)g_byteOffset);
    closeSession();   // flush + close; without this the tail of the recording
                      // is lost when the card is pulled
  }
#else
  (void)wasRecording;
#endif

  signalState(SESSION_IDLE);
  Serial.printf("#STATUS: %s\n", reason);
}

// One press, dispatched by current state. Shared by the physical button on
// GPIO 21 and the "BUTTON" serial command, so a bench test over USB exercises
// exactly the same path as a press on the helmet -- not a parallel one.
void sessionButtonPress() {
  switch (g_sessionState) {
    case SESSION_IDLE:      armingBegin(); break;
    case SESSION_ARMING:    sessionStop("Arming aborted"); break;
    case SESSION_RECORDING: sessionStop("Session stopped"); break;
  }
}



// ─────────────────────────────────────────────────────────────────────────
// tryInitMPU() — probe the two addresses an MPU-6050 can be strapped to
// (0x68/0x69), validate WHO_AM_I, and configure ranges on success.
// Returns the detected address, or 0 if not found / WHO_AM_I mismatch.
// Does NOT calibrate — caller decides whether a (re)calibration is needed.
// ─────────────────────────────────────────────────────────────────────────

uint8_t tryInitMPU() {
  uint8_t foundAddr = 0;
  for (uint8_t addr = 0x68; addr <= 0x69; addr++) {
    Wire.beginTransmission(addr);
    if (Wire.endTransmission() == 0) {
      foundAddr = addr;
      break;
    }
  }
  if (foundAddr == 0) return 0;

  mpu = MPU6050(foundAddr);
  // Force a full device reset (PWR_MGMT_1 bit 7) before waking it, instead
  // of going straight to initialize()'s "gentle" clock-source/sleep-bit
  // writes. A chip left in a confused internal state by an irregular
  // power-up sequence can ACK its address yet still misbehave on register
  // reads/writes until it sees a real reset -- see D:\proj\atttts\imu_test
  // (IMU_INTEGRATION.md), whose manual reset-then-wake sequence recovered
  // this exact chip when our library-only initialize() path could not.
  mpu.reset();
  delay(120);
  mpu.initialize();
  uint8_t whoami = mpu.getDeviceID();
  Serial.printf("#STATUS: MPU at 0x%02X WHO_AM_I = 0x%02X\n", foundAddr, whoami);
  // getDeviceID() returns the 6-bit device ID field (register 0x75 bits
  // 6:1), NOT the raw I2C address -- 0x68/0x69 here were never valid
  // values for it to return. Match the MPU6050 library's own
  // testConnection() whitelist instead: 0x34 is the common value, but
  // 0x0C and 0x3A are documented hardware-revision variants of the same
  // genuine chip (see MPU6050_Base::testConnection() in MPU6050.cpp).
  if (whoami != 0x34 && whoami != 0x0C && whoami != 0x3A) {
    return 0;
  }

  g_mpuEnabled = true;
  mpu.setFullScaleAccelRange(MPU6050_ACCEL_FS_2);
  mpu.setFullScaleGyroRange(MPU6050_GYRO_FS_250);
  return foundAddr;
}

// ─────────────────────────────────────────────────────────────────────────
// Setup
// ─────────────────────────────────────────────────────────────────────────

void setup() {
  // Claim the buzzer pin FIRST, before anything else -- Serial.begin()'s
  // up-to-3s wait, the fixed 1.5s delay below, camera init, and the LED
  // blink all run before this point used to be reached. A freshly reset
  // ESP32 GPIO floats until pinMode()+digitalWrite() explicitly claim it,
  // and a floating transistor base can pick up enough noise to partially
  // turn the buzzer on for that whole multi-second window. Driving it LOW
  // here shrinks that window to the fixed hardware boot time before
  // setup() runs at all, which we can't reduce further from application
  // code.
  pinMode(BUZZER_PIN, OUTPUT);
  digitalWrite(BUZZER_PIN, LOW);

#if defined(FRAME_INJECT_MODE)
  // Injected frames arrive as multi-KB bursts. The default CDC receive buffer
  // is 256 bytes, so even a 4 KB QVGA JPEG overruns it mid-frame and
  // injectReadExact() stalls its full 5 s ("#ERROR: frame read failed,
  // resyncing") on every frame. Must be set before begin() to take effect.
  Serial.setRxBufferSize(16384);
#endif
#if defined(STORAGE_MODE_USB)
  Serial.begin(921600);
#else
  Serial.begin(115200);
#endif
  unsigned long t0 = millis();
  while (!Serial && millis() - t0 < 3000)
    delay(10);
  // Native USB-CDC re-enumerates on every reset, so a host-side monitor
  // that was attached before the reset is still reconnecting for a bit
  // after Serial reports ready -- without this, the earliest boot lines
  // (camera/PSRAM/SD status, the ones you most want on a fresh reset) are
  // silently dropped since nothing is listening yet.
  delay(1500);

  Serial.println(F("#STATUS: ---- IoT Fatigue Helmet Phase 2 ----"));
#if defined(STORAGE_MODE_SD)
  Serial.println(F("#STATUS: Mode = PRODUCTION (SD card)"));
#else
  Serial.println(F("#STATUS: Mode = DEBUG (USB streaming)"));
#endif

  // ── Camera Initialization ─────────────────────────────────────────────
  camera_config_t config;
  config.ledc_channel = LEDC_CHANNEL_0;
  config.ledc_timer = LEDC_TIMER_0;
  config.pin_d0 = Y2_GPIO_NUM;
  config.pin_d1 = Y3_GPIO_NUM;
  config.pin_d2 = Y4_GPIO_NUM;
  config.pin_d3 = Y5_GPIO_NUM;
  config.pin_d4 = Y6_GPIO_NUM;
  config.pin_d5 = Y7_GPIO_NUM;
  config.pin_d6 = Y8_GPIO_NUM;
  config.pin_d7 = Y9_GPIO_NUM;
  config.pin_xclk = XCLK_GPIO_NUM;
  config.pin_pclk = PCLK_GPIO_NUM;
  config.pin_vsync = VSYNC_GPIO_NUM;
  config.pin_href = HREF_GPIO_NUM;
  config.pin_sccb_sda = SIOD_GPIO_NUM;
  config.pin_sccb_scl = SIOC_GPIO_NUM;
  config.pin_pwdn = PWDN_GPIO_NUM;
  config.pin_reset = RESET_GPIO_NUM;
  config.xclk_freq_hz = 20000000;
  // Resolution/FPS/quality controlled by CAMERA_FRAMESIZE, CAMERA_FPS,
  // CAMERA_JPEG_QUALITY -- defined at top of file (or via platformio.ini flags)

  config.frame_size = CAMERA_FRAMESIZE;
  config.pixel_format = PIXFORMAT_JPEG;
  config.grab_mode = CAMERA_GRAB_WHEN_EMPTY;
  config.fb_location = CAMERA_FB_IN_PSRAM;
  config.jpeg_quality = CAMERA_JPEG_QUALITY;
  config.fb_count = 1;

  if (psramFound()) {
    config.fb_count = 2; // double-buffer for smoother capture
    config.grab_mode = CAMERA_GRAB_LATEST;
    Serial.println(F("#STATUS: PSRAM found — using 2 frame buffers"));
  } else {
    // No PSRAM: drop to QVGA to fit in internal DRAM (~320 KB available)
    config.frame_size = FRAMESIZE_QVGA;
    config.fb_location = CAMERA_FB_IN_DRAM;
    Serial.println(F("#WARN: No PSRAM — falling back to QVGA (internal DRAM)"));
  }

  esp_err_t err = esp_camera_init(&config);
  if (err != ESP_OK) {
    Serial.printf("#ERROR: Camera init failed 0x%x\n", err);
  } else {
    Serial.println(F("#STATUS: Camera initialized successfully"));
  }

  blinkLED(3);

  analogReadResolution(12);
  Serial.println(F("#STATUS: Pulse sensor GPIO 1 (ADC1) — analog mode"));

#if defined(STORAGE_MODE_SD) || defined(EAR_LIVE_DEBUG) || defined(FRAME_INJECT_MODE)
  // FRAME_INJECT_MODE included: the processEarFrame() branch that CONSUMES
  // g_earStoredCx already runs unconditionally, so without this the injected
  // firmware never sees the stored ROI and instead spends the first ~18 s of
  // session time re-running the full-frame boot-lock search -- the wrong
  // thing to test when the point is to compare against a known starting ROI
  // (see tools/session_replay/drift_test.cpp, which does start there).
  earLoadStoredRoi();
  if (g_earStoredCx >= 0) {
    Serial.printf("#STATUS: stored eye coordinate cx=%d cy=%d (send ROI:auto to clear)\n",
                  g_earStoredCx, g_earStoredCy);
  } else {
    Serial.println(F("#STATUS: no stored eye coordinate -- the localizer will search"));
  }
#endif

  // Session Button
  pinMode(BUTTON_PIN, INPUT_PULLUP);
  Serial.println(F("#STATUS: Button GPIO 21 initialized (INPUT_PULLUP)"));

  // Buzzer: GPIO 14 (confirmed free — see fuzzy_walkthrough.md §7 GPIO audit).
  // Pin already claimed at the very top of setup() -- see that comment.
  // NOTE: do NOT use LED_BUILTIN (GPIO 2) after Wire.begin() — conflicts with I2C SDA.
  Serial.println(F("#STATUS: Buzzer GPIO 14 initialized"));

  Wire.begin(PIN_SDA, PIN_SCL);
  Wire.setClock(100000);
  Wire.setTimeOut(20);

  if (tryInitMPU() != 0) {
    Serial.println(F("#STATUS: MPU-6050 initialized OK"));
    calibrateMPU();
  } else {
    g_mpuEnabled = false;
    Serial.println(F("#WARN: MPU-6050 not detected/validated at 0x68/0x69 — running with IMU disabled"));
  }

  // ── SD card initialization (production mode) ─────────────────────────
#if defined(STORAGE_MODE_SD)
  g_sdMutex = xSemaphoreCreateMutex();
  g_sdReady = initSDCard();
  if (!g_sdReady) {
    // NO LED blink here. LED_BUILTIN is GPIO 2, which is PIN_SDA -- driving it
    // after Wire.begin() slams the I2C data line ten times and can wedge the
    // MPU-6050 mid-byte, exactly the failure the comment above warns about
    // and the one sensor_test now carries a bus-recovery routine for. The
    // error is reported on serial only until a real indicator exists on a
    // free GPIO (see signalState()).
    Serial.println(F("#ERROR: SD init failed -- CSV goes to serial only"));
  }
#endif

  Serial.println(
      F("#HEADER:timestamp_ms,hr_bpm,pulse_raw,"
        "ax_g,ay_g,az_g,gx_dps,gy_dps,gz_dps,head_movement,signal_quality,"
        "blink_rate,pitch_deg,gyro_var,nod_score,risk_pct,alert_level,imu_valid,"
        "blink_valid,alert_gated"));
  Serial.println(F("#STATUS: Logging started"));

#if defined(STORAGE_MODE_USB)
  Serial.println(F("#STATUS: USB mode — run debug_recorder.py on PC"));
  // ── Create Serial mutex (USB mode: needed to protect binary frame writes) ─
  g_serialMutex = xSemaphoreCreateMutex();
#elif defined(STORAGE_MODE_SD)
  g_serialMutex =
      xSemaphoreCreateMutex(); // still used for clean serial text output
  Serial.println(F("#STATUS: SD mode — data recording to SD card"));
#endif

  // ── Launch camera task on Core 0 ─────────────────────────────────────
  // FRAME_INJECT_MODE replaces live capture with frameInjectTask(), which
  // owns Serial exclusively for the PC->ESP frame protocol -- no live
  // camera task runs alongside it (see that task's own doc comment).
#if defined(FRAME_INJECT_MODE)
  xTaskCreatePinnedToCore(frameInjectTask, "FrameInject",
                          8192,       // stack bytes
                          nullptr, 2, // priority 2
                          nullptr, 0  // Core 0
  );
#else
  xTaskCreatePinnedToCore(cameraTask, "CameraTask",
                          8192,       // stack bytes
                          nullptr, 2, // priority 2
                          nullptr, 0  // Core 0
  );
#endif

  // ── Initial session state ────────────────────────────────────────────
#if defined(STORAGE_MODE_USB)
  // USB debug mode streams immediately: there is no SD session to open and
  // no arming gate, matching the previous behaviour of this build.
  g_sessionState  = SESSION_RECORDING;
  g_sessionActive = true;
#else
  g_sessionState  = SESSION_IDLE;
  g_sessionActive = false;
  Serial.println(F("#STATUS: Idle -- press the button on GPIO 21 to arm a session"));
#endif
  signalState(g_sessionState);

#if defined(PHONE_PREVIEW)
  // Last, so a Wi-Fi start failure cannot hold up the sensors or the camera.
  PhonePreview::start();
#endif
}

// ─────────────────────────────────────────────────────────────────────────
// handleCommandLine() — one text command, from the serial port (loop()'s 1 Hz
// parser) or from the phone page (phoneTick()). Both sources go through here,
// so the phone can do nothing the serial port cannot, and the two cannot
// drift apart. Call from loop()'s task only: it arms, stops and moves the ROI.
// ─────────────────────────────────────────────────────────────────────────
void handleCommandLine(const char *line, unsigned long now) {
  // "BUTTON" is one press of the GPIO 21 button, routed through the same
  // sessionButtonPress() dispatch. Lets the arm/record/stop flow be driven
  // over USB or from the phone without reaching into the helmet, and cannot
  // collide with the BLINK: format below.
  if (strcmp(line, "BUTTON") == 0) {
    sessionButtonPress();
    return;
  }
#if defined(STORAGE_MODE_SD) || defined(EAR_LIVE_DEBUG)
  // "ROI:<cx>,<cy>" stores the eye centre the PC or phone measured (kept in
  // NVS across reboots and reflashes) and applies it immediately; "ROI:auto"
  // clears it and goes back to searching. See earStoredRoi* and
  // live_ear_preview.py --arm.
  if (strncmp(line, "ROI:", 4) == 0) {
    int cx = 0, cy = 0;
    bool roiSet = false;
    if (strcmp(line + 4, "auto") == 0) {
      earClearStoredRoi();
      g_earLockDone = false;
      g_earRoi.locked = false;
      g_earRoiSource = "none";
      g_earLocator.reset();
      g_earDriftState = EAR_DRIFT_IDLE;   // g_earLocator is about to be reused for the boot search
      g_earMotionTries = 0;
      Serial.println(F("#STATUS: EAR ROI cleared -- searching for the eye again"));
      roiSet = true;
    } else if (sscanf(line + 4, "%d,%d", &cx, &cy) == 2 &&
               cx >= 0 && cy >= 0 && cx < 2000 && cy < 2000) {
      earSaveStoredRoi(cx, cy);
      g_earLockDone = false;      // re-applied from the stored value next frame
      g_earRoi.locked = false;
      g_earDriftState = EAR_DRIFT_IDLE;   // the ROI is about to jump; a cycle mid-accumulation is now stale
      Serial.printf("#STATUS: EAR ROI saved cx=%d cy=%d\n", cx, cy);
      roiSet = true;
    } else {
      Serial.println(F("#ERROR: expected ROI:<cx>,<cy> or ROI:auto"));
    }
    // A new box is a new lock, so the eye check (EAR_CHECK_MIN_BLINKS within
    // EAR_CHECK_WINDOW_MS of the lock) must restart from it, as armingBegin()
    // does -- otherwise fixing a wrong box late in ARMING runs the check on
    // the old window and can fail it (blink channel off for the whole ride)
    // or pass it on blinks seen on the wrong box. Not while recording, where
    // the session's result is latched; USB debug builds sit in RECORDING, so
    // the PC tool's behaviour is unchanged.
    if (roiSet) g_earHogBg.reset();   // the crop jumps to a different framing, so the old template is wrong for it
    if (roiSet && g_sessionState != SESSION_RECORDING) {
      g_earValidSinceMs = 0;
      g_earBlinksSinceLock = 0;
      g_eyeCheck = EYECHECK_PENDING;
    }
    return;
  }
#endif
  float blink_val = 0.0f;
  if (sscanf(line, "BLINK:%f", &blink_val) == 1
      && blink_val >= 0.0f && blink_val <= 60.0f) {
    g_blinkRate       = blink_val;
    g_lastValidBlink  = blink_val;
    g_lastBlinkRxTime = now;
    g_blinkEverRx     = true;
  }
}

#if defined(PHONE_PREVIEW)
// ─────────────────────────────────────────────────────────────────────────
// Phone arming preview — the loop() side of PhonePreview.h.
// ─────────────────────────────────────────────────────────────────────────
// Indexed by SessionState. The page shows these and echoes one back with a
// press (/press?expect=), so the two must use the same names.
static const char *const PHONE_STATE_NAME[] = {"IDLE", "ARMING", "RECORDING"};
static_assert(sizeof(PHONE_STATE_NAME) / sizeof(PHONE_STATE_NAME[0]) == SESSION_RECORDING + 1,
              "PHONE_STATE_NAME must name every SessionState");
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
void loop() {
  unsigned long now = millis();

  // ── Session Button Logic (Non-blocking) ──────────────────────────────
  int reading = digitalRead(BUTTON_PIN);
  if (reading != g_lastButtonState) {
    g_lastDebounceTime = now;
  }
  if ((now - g_lastDebounceTime) > 50) {
    static int buttonState = HIGH;
    if (reading != buttonState) {
      buttonState = reading;
      if (buttonState == LOW) { // pressed
        sessionButtonPress();
      }
    }
  }
  g_lastButtonState = reading;

  // ── Eye check: resolve once, latch for the session ───────────────────
#if defined(STORAGE_MODE_SD) || defined(EAR_LIVE_DEBUG)
  if (g_eyeCheck == EYECHECK_PENDING && g_earValidSinceMs != 0) {   // runs in IDLE too: debug builds never arm
    const uint32_t lockedFor = now - g_earValidSinceMs;
    if (g_earBlinksSinceLock >= EAR_CHECK_MIN_BLINKS) {
      g_eyeCheck = EYECHECK_PASS;
      Serial.printf("#STATUS: Eye check PASSED -- %u blinks in %lu s after lock\n",
                    (unsigned)g_earBlinksSinceLock, (unsigned long)(lockedFor / 1000));
    } else if ((int32_t)lockedFor >= (int32_t)EAR_CHECK_WINDOW_MS) {
      g_eyeCheck = EYECHECK_FAIL;
      Serial.printf("#WARNING: Eye check FAILED -- %u blinks in %lu s after lock (need %u); "
                    "blink channel off until the next arming\n",
                    (unsigned)g_earBlinksSinceLock, (unsigned long)(lockedFor / 1000),
                    (unsigned)EAR_CHECK_MIN_BLINKS);
    }
  }
#endif

  // ── ARMING progress ──────────────────────────────────────────────────
  // Nothing is written to SD in this state. The three checks run concurrently
  // and independently; recording starts when all are ready, or when the
  // timeout expires (readiness is then recorded in metadata.txt rather than
  // costing the session).
  if (g_sessionState == SESSION_ARMING) {
    armCalibTick(now);

    bool imuOk = g_armCalib.done;
    bool hrOk  = g_baselineFormed;
#if defined(STORAGE_MODE_SD) || defined(EAR_LIVE_DEBUG)
    // Ready = locked and the eye check has resolved (pass OR fail): a failed
    // check does not hold the rider here, it just marks the blink channel off.
    bool eyeOk = g_earLockDone && g_eyeCheck != EYECHECK_PENDING;
    const unsigned eyeBlinks = g_earBlinksSinceLock, eyeNeed = EAR_CHECK_MIN_BLINKS;
#else
    bool eyeOk = true;   // no EAR pipeline compiled into this build
    const unsigned eyeBlinks = 0, eyeNeed = 0;
#endif

    // Signed: a button press earlier in this same loop() pass can run
    // armingBegin(), which takes its own millis() and can land at now+1 --
    // the unsigned now - g_armStartMs would then underflow to ~4294967295
    // and trip the timeout on the spot.
    const int32_t armElapsed = (int32_t)(now - g_armStartMs);

    static uint32_t lastArmReport = 0;
    if (now - lastArmReport >= 2000) {
      lastArmReport = now;
      Serial.printf("#ARMING: imu=%d hr=%d(%u/%u) eye=%d(blinks %u/%u)  %lu/%lu s\n",
                    imuOk ? 1 : 0,
                    hrOk ? 1 : 0,
                    (unsigned)g_hrBase.progress(), (unsigned)HrBaseline::NEEDED,
                    eyeOk ? 1 : 0,
                    eyeBlinks, eyeNeed,
                    (unsigned long)(armElapsed > 0 ? armElapsed : 0) / 1000,
                    (unsigned long)(ARMING_TIMEOUT_MS / 1000));
    }

    if (imuOk && hrOk && eyeOk) {
      recordingBegin();
    } else if (armElapsed >= (int32_t)ARMING_TIMEOUT_MS) {
      g_armTimedOut = true;
      Serial.println(F("#WARNING: Arming timed out -- recording anyway; check armed_* in metadata.txt"));
      recordingBegin();
    }
  }

#if defined(PHONE_PREVIEW)
  phoneTick(now);
#endif



  // ── Pulse sensor: 500 Hz — must ALWAYS run, never skip ───────────────
  // Keep this first and outside any mutex so it is never starved.
  static unsigned long lastSampleTime = 0;
  if (now - lastSampleTime >= SAMPLE_RATE_MS) {
    lastSampleTime = now;
    readPulseSensor();
  }

  // ── Feed task watchdog so Core 1 is never considered hung ────────────
  esp_task_wdt_reset();

  // ── 10 Hz IMU ring buffer fill ────────────────────────────────────────────────────
  // Pitch, gyro variance, and nodding detector require 10 Hz IMU data.
  // Results cached in g_imu_* are consumed at the 1 Hz FIS tick + CSV output.
  // No mutex needed: both this block and the 1 Hz block run on Core 1 (loop).
  static unsigned long lastImuTime = 0;
  if (now - lastImuTime >= 100) {   // 100 ms = 10 Hz
    lastImuTime = now;

    // Auto-reconnect retry if IMU was not detected at boot or connection was lost
    static unsigned long lastImuRetry = 0;
    if (!g_mpuEnabled && (now - lastImuRetry >= 2000)) {
      lastImuRetry = now;
      Wire.begin(PIN_SDA, PIN_SCL);
      Wire.setClock(100000);
      uint8_t foundAddr = tryInitMPU();
      if (foundAddr != 0) {
        if (ax_off == 0 && ay_off == 0 && az_off == 0) {
          calibrateMPU();
        } else {
          Serial.printf("#STATUS: MPU-6050 I2C connection restored (address 0x%02X)\n", foundAddr);
        }
      }
    }

    // IMU reads are suspended while the buzzer draws current (EMI corrupts the
    // I2C bus). Rather than substituting calibration offsets -- which resolve to
    // an exact "0 deg pitch, 0 movement" upright-and-still reading -- we mark the
    // sample invalid and FREEZE: no ring-buffer push, no g_imu_* update.
    //
    // Why not substitute zeros: a 2 s CRITICAL beep injects 20 fake samples into
    // the 60-sample nod buffer (1/3 of it), collapsing pitch_Limp and suppressing
    // the ZCR that drives nod_score. R3 -- the head-drop rule that fired the alarm
    // -- then reads ~0, so the alarm erases its own trigger and self-cancels while
    // the rider is still drooping. It also writes that fiction into the CSV at
    // exactly the fatigue events the dataset exists to capture.
    //
    // Freezing is safe against the "death loop" the zeros were guarding against:
    // the alert state machine caps buzzer on-time (2 s CRITICAL / 1 s WARNING) and
    // forces a 3 s cooldown during which g_buzzerActive is false, so ~30 real
    // samples land before any re-fire decision. A stuck alarm is structurally
    // impossible regardless of what the frozen values held.
    int16_t ax_r10 = 0, ay_r10 = 0, az_r10 = 0;
    int16_t gx_r10 = 0, gy_r10 = 0, gz_r10 = 0;
    bool imuSampleValid = false;
    if (g_mpuEnabled && !g_buzzerActive) {
      static int i2cErrorCount = 0;
      Wire.beginTransmission(MPU_ADDR);
      if (Wire.endTransmission() != 0) {
        i2cErrorCount++;
        if (i2cErrorCount >= 10) { // Require 10 consecutive errors before marking disabled
          g_mpuEnabled = false;
          Wire.begin(PIN_SDA, PIN_SCL); // Instant I2C bus hardware reset
        }
      } else {
        i2cErrorCount = 0;
        mpu.getMotion6(&ax_r10, &ay_r10, &az_r10, &gx_r10, &gy_r10, &gz_r10);
        imuSampleValid = true;
      }
    }

    // Freeze on invalid sample: leave ring buffers and g_imu_* holding the last
    // real reading. Buffers then contain 100% real data spanning a slightly
    // longer wall-clock window, instead of real data diluted with fabrications.
    if (imuSampleValid) {
      float ax_g10  = (ax_r10 - ax_off) / ACCEL_SCALE;
      float ay_g10  = (ay_r10 - ay_off) / ACCEL_SCALE;
      float az_g10  = (az_r10 - az_off) / ACCEL_SCALE;
      float gx_dp10 = (gx_r10 - gx_off) / GYRO_SCALE;
      float gy_dp10 = (gy_r10 - gy_off) / GYRO_SCALE;
      float gz_dp10 = (gz_r10 - gz_off) / GYRO_SCALE;
      float head_mov10 = sqrtf(gx_dp10*gx_dp10 + gy_dp10*gy_dp10 + gz_dp10*gz_dp10);

      // Pitch: dot-product angle between current accel and calibration gravity.
      // Uses raw (un-offsetted) readings so the calibration reference frame is intact.
      float gx_raw = (float)ax_r10;
      float gy_raw = (float)ay_r10;
      float gz_raw = (float)az_r10;
      float dot    = g_calibGrav[0]*gx_raw + g_calibGrav[1]*gy_raw + g_calibGrav[2]*gz_raw;
      float mag_c  = sqrtf(g_calibGrav[0]*g_calibGrav[0] +
                           g_calibGrav[1]*g_calibGrav[1] +
                           g_calibGrav[2]*g_calibGrav[2]);
      float mag_n  = sqrtf(gx_raw*gx_raw + gy_raw*gy_raw + gz_raw*gz_raw);
      float cos_a  = (mag_c > 1e-3f && mag_n > 1e-3f) ? dot / (mag_c * mag_n) : 1.0f;
      if (cos_a >  1.0f) cos_a =  1.0f;
      if (cos_a < -1.0f) cos_a = -1.0f;
      float pitch10 = acosf(cos_a) * (180.0f / (float)M_PI);

      // Push into ring buffers
      g_nodDet.push(pitch10);
      g_gyroVar.push(head_mov10);

      // Cache latest snapshot for 1 Hz FIS tick and CSV
      g_imu_ax_g      = ax_g10;
      g_imu_ay_g      = ay_g10;
      g_imu_az_g      = az_g10;
      g_imu_gx_dp     = gx_dp10;
      g_imu_gy_dp     = gy_dp10;
      g_imu_gz_dp     = gz_dp10;
      g_imu_head_mov  = head_mov10;
      g_imu_pitch_deg = pitch10;
      g_imu_gyro_var  = g_gyroVar.variance();
      g_imu_nod_score = g_nodDet.score();
    }

    // Track freshness for the 1 Hz CSV row so frozen samples are visibly stale
    // rather than silently passed off as live readings.
    g_imuSampleValid = imuSampleValid;
    if (imuSampleValid) g_lastImuValidTime = now;
  }

  // ── CSV output: 1 Hz ───────────────────────────────────────────────────────────
  static unsigned long lastOutputTime = 0;
  if (now - lastOutputTime < LOOP_MS)
    return;
  lastOutputTime = now;

  // ── Serial BLINK parser (drains UART buffer each 1 Hz tick) ──────────────────
  // Format: "BLINK:<float>\n"  Rate: 1 Hz from Python pipeline.
  // Valid range: 0–60 bl/min. Invalid / out-of-range lines silently discarded.
  // Disabled under FRAME_INJECT_MODE: frameInjectTask() owns Serial reads
  // there (the binary frame-injection protocol), and two tasks racing to
  // read the same UART would each steal the other's bytes.
#if !defined(FRAME_INJECT_MODE)
  while (Serial.available()) {
    char c = (char)Serial.read();
    if (c == '\n' || c == '\r') {
      g_serialLineBuf[g_serialLineBufLen] = '\0';
      handleCommandLine(g_serialLineBuf, now);
      g_serialLineBufLen = 0;
    } else if (g_serialLineBufLen < (uint8_t)(sizeof(g_serialLineBuf) - 1)) {
      g_serialLineBuf[g_serialLineBufLen++] = c;
    } else {
      g_serialLineBufLen = 0;   // line too long — discard
    }
  }
#endif  // !FRAME_INJECT_MODE
  // Fallback: sticky last-valid after timeout; on-device EAR rate in SD
  // mode or EAR_LIVE_DEBUG (see processEarFrame() above), or the 13.0 stub
  // in plain USB mode (USB debug mode without EAR_LIVE_DEBUG still relies
  // on the offline eye_ear.py pipeline, see spec non-goals).
  if (g_blinkEverRx && (now - g_lastBlinkRxTime > BLINK_TIMEOUT_MS)) {
    g_blinkRate = g_lastValidBlink;
  } else if (!g_blinkEverRx) {
#if defined(STORAGE_MODE_SD) || defined(EAR_LIVE_DEBUG)
    g_blinkRate = g_onDeviceBlinkRate;
#else
    g_blinkRate = 13.0f;
#endif
  }

  // ── Blink channel health ──────────────────────────────────────────────────────
  // A PC-fed rate (BLINK:) is trusted as before. The on-device rate is only
  // meaningful once the eye is locked, a full 60 s window has accumulated, and
  // frames are still arriving. Otherwise a 0 means "cannot see", not "eyes closed", and the
  // FIS is told to ignore blink. Signed compares: the camera task may stamp a
  // frame a few ms after `now` was sampled.
  bool blinkValid = true;
  const char *blinkWhy = "";
#if defined(STORAGE_MODE_SD) || defined(EAR_LIVE_DEBUG)
  if (!g_blinkEverRx) {
    const uint32_t since = g_earValidSinceMs, last = g_earLastFrameMs;
    if (g_earDisabled)                                        blinkWhy = "EAR disabled";
    else if (since == 0)                                      blinkWhy = "no eye lock yet";
    else if (g_eyeCheck == EYECHECK_FAIL)                     blinkWhy = "eye check failed (too few blinks after lock)";
    else if (g_eyeCheck == EYECHECK_PENDING)                  blinkWhy = "eye check pending";
    else if ((int32_t)(now - since) < (int32_t)EAR_BLINK_WARMUP_MS) blinkWhy = "warming up (60 s window)";
    else if ((int32_t)(now - last) > (int32_t)EAR_FRAME_STALE_MS)   blinkWhy = "no frames processed";
    blinkValid = (blinkWhy[0] == '\0');
  }
#endif
  if (blinkValid != g_blinkValid) {
    if (xSemaphoreTake(g_serialMutex, pdMS_TO_TICKS(5)) == pdTRUE) {
      if (blinkValid) Serial.println(F("#STATUS: Blink channel ONLINE"));
      else            Serial.printf("#STATUS: Blink channel OFFLINE -- %s; FIS ignores blink\n", blinkWhy);
      xSemaphoreGive(g_serialMutex);
    }
  }
  g_blinkValid = blinkValid;

  // ── Warn on prolonged no-contact (non-blocking: skip if mutex busy) ────────
  if (lastSignalQuality == 0) {
    if (++noContactStreak >= NO_CONTACT_WARN_N) {
      if (xSemaphoreTake(g_serialMutex, pdMS_TO_TICKS(5)) == pdTRUE) {
        Serial.println(F("#WARNING: Pulse signal low — check sensor contact"));
        xSemaphoreGive(g_serialMutex);
      }
      noContactStreak = 0;
    }
  } else {
    noContactStreak = 0;
  }

  // ── Baseline HR accumulation ───────────────────────────────────────────────────
  // Count-based (not time-based): only valid readings count.
  // Frozen after formed — not rolling — so progressive drowsiness is not
  // normalised out. Resets only on power cycle (new session).
  int hr_out = (lastSignalQuality == 1 && currentBPM > 0) ? (int)currentBPM : 0;

  if (!g_baselineFormed && lastSignalQuality == 1 && currentBPM > 0) {
    if (g_hrBase.push(currentBPM)) {
      g_baselineBPM    = g_hrBase.bpm;
      g_baselineFormed = true;
      if (xSemaphoreTake(g_serialMutex, pdMS_TO_TICKS(5)) == pdTRUE) {
        Serial.printf("#STATUS: Baseline HR formed: %.1f BPM (median of %u after %u settling)\n",
                      g_baselineBPM, (unsigned)HrBaseline::N, (unsigned)HrBaseline::SKIP);
        xSemaphoreGive(g_serialMutex);
      }
    }
  }

  // ── FIS update (1 Hz) ──────────────────────────────────────────────────────────
  // hr_diff_pct = 0.0 while baseline forming → hr_Stable peaks → FIS relies
  // only on blink + IMU signals during warmup. No false alarms from HR alone.
  float hr_diff_pct = 0.0f;
  if (g_baselineFormed && hr_out > 0) {
    hr_diff_pct = (currentBPM - g_baselineBPM) / g_baselineBPM * 100.0f;
  }

  g_fis.update(hr_diff_pct,
               g_blinkRate,
               g_imu_gyro_var,
               g_imu_pitch_deg,
               g_imu_nod_score,
               g_riskScore,
               g_alertLevel,
               g_blinkValid);
  g_alertGated = g_alertGate.update(g_alertLevel, now);

  // ── Buzzer alert output (GPIO 14) ─────────────────────────────────────────────
  if (g_sessionBeepState == 0) { // Don't interfere with start/stop beeps
    if (g_sessionActive) {
#if defined(TEST_MODE_HARDWARE)
      // Test mode: Beep buzzer for 200ms every 5 seconds
      static uint32_t lastTestBeep = 0;
      if (now - lastTestBeep >= 5000) {
        setBuzzerState(true);
        lastTestBeep = now;
      } else if (now - lastTestBeep >= 200) {
        setBuzzerState(false);
      }
#else
      // Driven by the GATED alert (g_alertGated), not the raw one.
      // CRITICAL : 2s ON, then 30s OFF (cooldown)
      // WARNING  : 1s ON, then 3s OFF (cooldown).
      // SAFE     : buzzer off.
#if defined(STORAGE_MODE_USB)
      setBuzzerState(false);
#else
      static uint32_t alertStartTime = 0;
      static bool alertActive = false;
      static uint32_t cooldownStartTime = 0;
      static bool cooldownActive = false;
      static uint32_t currentAlertDuration = 0;
      static uint32_t cooldownDuration = 3000;
      const uint32_t COOLDOWN_AFTER_WARNING  = 3000;
      const uint32_t COOLDOWN_AFTER_CRITICAL = 30000;   // a Critical that clears and returns must not re-beep at once

      if (cooldownActive) {
        if (now - cooldownStartTime > cooldownDuration) {
          cooldownActive = false;
        }
      } else if (alertActive) {
        if (now - alertStartTime > currentAlertDuration) {
          alertActive = false;
          cooldownActive = true;
          cooldownStartTime = now;
          cooldownDuration = (currentAlertDuration == 2000) ? COOLDOWN_AFTER_CRITICAL : COOLDOWN_AFTER_WARNING;
          setBuzzerState(false);

          // Buzzer just went silent -- try to reconnect right now instead of
          // waiting up to 2 s for the periodic retry in the 10 Hz IMU block.
          // Shrinks the "blind" window right after an alert, when detecting
          // whether the driver actually woke up matters most.
          Wire.begin(PIN_SDA, PIN_SCL);
          Wire.setClock(100000);
          tryInitMPU();
        } else {
          setBuzzerState(true);
        }
      } else {
        // Idle state - wait for new alert
        if (g_alertGated == ALERT_CRITICAL || g_alertGated == ALERT_WARNING) {
          // Force a fresh MPU reconnect/re-init right as the buzzer is about
          // to start drawing current, so it enters the noisy window in a
          // known-good state instead of whatever it drifted to since the
          // last successful read. Cheap (a few I2C transactions, no delay())
          // -- does NOT recalibrate, so it's safe to call every alert onset.
          Wire.begin(PIN_SDA, PIN_SCL);
          Wire.setClock(100000);
          tryInitMPU();

          alertActive = true;
          alertStartTime = now;
          currentAlertDuration = (g_alertGated == ALERT_CRITICAL) ? 2000 : 1000;
          setBuzzerState(true);
        } else {
          setBuzzerState(false);
        }
      }
#endif
#endif
    } else {
      // Keep buzzer quiet while paused (except for the start/stop beeps handled above)
      setBuzzerState(false);
    }
  }

  // ── Serial output (human-readable, both modes) ──────────────────────────────
  // Uses cached 10 Hz IMU snapshot (g_imu_*) — no extra I2C read at 1 Hz.
  if (xSemaphoreTake(g_serialMutex, pdMS_TO_TICKS(5)) == pdTRUE) {
    const char *alertStr = (g_alertLevel == ALERT_CRITICAL) ? "CRITICAL" :
                           (g_alertLevel == ALERT_WARNING)  ? "WARNING"  : "safe";
    Serial.println(F("#------------------------------------"));
    Serial.print(F("# t:"));
    Serial.print(now);
    Serial.print(F("ms  |  HR: "));
    if (hr_out > 0) {
      Serial.print(hr_out);
      Serial.print(F(" BPM"));
      if (g_baselineFormed) {
        Serial.printf("  (diff %.1f%%)", hr_diff_pct);
      } else {
        Serial.print(F("  (baseline forming...)"));
      }
    } else {
      Serial.print(F("-- BPM"));
    }
    Serial.print(F("  PULSE:"));
    Serial.print(lastPulseRaw);
    Serial.println(lastSignalQuality ? F("  [OK]") : F("  [NO CONTACT]"));
    if (!g_mpuEnabled) {
      Serial.println(F("# IMU: [DISCONNECTED] — check MPU-6050 VCC/GND/SDA/SCL wiring"));
    }
    Serial.print(F("# AX:"));
    Serial.print(g_imu_ax_g, 3);
    Serial.print(F("  AY:"));
    Serial.print(g_imu_ay_g, 3);
    Serial.print(F("  AZ:"));
    Serial.print(g_imu_az_g, 3);
    Serial.print(F("  MOV:"));
    Serial.print(g_imu_head_mov, 3);
    Serial.println(F("g"));
    Serial.print(F("# GX:"));
    Serial.print(g_imu_gx_dp, 1);
    Serial.print(F("  GY:"));
    Serial.print(g_imu_gy_dp, 1);
    Serial.print(F("  GZ:"));
    Serial.println(g_imu_gz_dp, 1);
    // "[FROZEN Nms]" marks IMU values held from the last good read (buzzer
    // active or bus down) rather than sampled this tick -- so a suspicious
    // pitch/nod reading during an alert can be told apart from a live one.
    Serial.printf("# BLINK:%.1f%s  PITCH:%.1fdeg  GVAR:%.0f  NOD:%.2f%s",
                  g_blinkRate, g_blinkValid ? "" : " [OFFLINE]",
                  g_imu_pitch_deg, g_imu_gyro_var, g_imu_nod_score,
                  g_imuSampleValid ? "\n" : "");
    if (!g_imuSampleValid) {
      Serial.printf("  [FROZEN %lums]\n",
                    (unsigned long)(now - g_lastImuValidTime));
    }
    Serial.printf("# RISK:%.1f%%  ALERT:%s  GATED:%s\n", g_riskScore, alertStr,
                  (g_alertGated == ALERT_CRITICAL) ? "CRITICAL" :
                  (g_alertGated == ALERT_WARNING)  ? "WARNING"  : "safe");

#if defined(STORAGE_MODE_USB)
    // USB CSV line for debug_recorder.py
    if (g_sessionActive) {
      // Columns: timestamp_ms, hr_bpm, pulse_raw,
      //          ax_g, ay_g, az_g, gx_dps, gy_dps, gz_dps, head_movement, signal_quality,
      //          blink_rate, pitch_deg, gyro_var, nod_score, risk_pct, alert_level,
      //          imu_valid, blink_valid, alert_gated
      // alert_gated is alert_level after the dwell/release gate (AlertGate.h) -- the
      // level the buzzer actually followed. alert_level stays the raw model output.
      // blink_valid=0 marks a row whose blink_rate is not evidence of anything
      // (eye not tracked / detector warming up): the FIS ignored it, and so
      // should any analysis or training that reads risk_pct/alert_level.
      // imu_valid=0 marks a row whose IMU fields are frozen last-known-good
      // values (reads suspended during buzzer, or bus down) rather than a live
      // sample -- exclude those rows from IMU statistics during analysis.
      Serial.print(now);                Serial.print(',');
      Serial.print(hr_out);             Serial.print(',');
      Serial.print(lastPulseRaw);       Serial.print(',');
      Serial.print(g_imu_ax_g, 4);     Serial.print(',');
      Serial.print(g_imu_ay_g, 4);     Serial.print(',');
      Serial.print(g_imu_az_g, 4);     Serial.print(',');
      Serial.print(g_imu_gx_dp, 4);    Serial.print(',');
      Serial.print(g_imu_gy_dp, 4);    Serial.print(',');
      Serial.print(g_imu_gz_dp, 4);    Serial.print(',');
      Serial.print(g_imu_head_mov, 4); Serial.print(',');
      Serial.print(lastSignalQuality); Serial.print(',');
      Serial.print(g_blinkRate, 2);    Serial.print(',');
      Serial.print(g_imu_pitch_deg, 2); Serial.print(',');
      Serial.print(g_imu_gyro_var, 1); Serial.print(',');
      Serial.print(g_imu_nod_score, 3); Serial.print(',');
      Serial.print(g_riskScore, 2);    Serial.print(',');
      Serial.print(g_alertLevel);      Serial.print(',');
      Serial.print(g_imuSampleValid ? 1 : 0); Serial.print(',');
      Serial.print(g_blinkValid ? 1 : 0); Serial.print(',');
      Serial.println(g_alertGated);
    }
#endif

    xSemaphoreGive(g_serialMutex);
  }

  // ── SD mode: write CSV row to SD card ───────────────────────────────────────
  // Column order matches USB CSV above for dataset compatibility.
  // Non-blocking: 20 ms timeout. Skip tick if camera task holds SD mutex.
#if defined(STORAGE_MODE_SD)
  if (g_sdReady && g_csvFile && g_sessionActive) {
    if (xSemaphoreTake(g_sdMutex, pdMS_TO_TICKS(20)) == pdTRUE) {
      g_csvFile.printf(
        "%lu,%d,%d,%.4f,%.4f,%.4f,%.4f,%.4f,%.4f,%.4f,%d,%.2f,%.2f,%.1f,%.3f,%.2f,%d,%d,%d,%d\n",
        now, hr_out, lastPulseRaw,
        g_imu_ax_g, g_imu_ay_g, g_imu_az_g,
        g_imu_gx_dp, g_imu_gy_dp, g_imu_gz_dp,
        g_imu_head_mov, lastSignalQuality,
        g_blinkRate, g_imu_pitch_deg, g_imu_gyro_var,
        g_imu_nod_score, g_riskScore, (int)g_alertLevel,
        g_imuSampleValid ? 1 : 0, g_blinkValid ? 1 : 0, (int)g_alertGated);
      g_csvFile.flush();
      xSemaphoreGive(g_sdMutex);
    }
  }
#endif
}
