walahow/IoT-Fatigue/fatigue-helmet/firmware/src/EyeBlinkEAR.h

#pragma once
#include <stdint.h>
#include <string.h>
#include <math.h>

// Pure, hardware-independent eye-blink detection math: Otsu thresholding,
// image-moment-based EAR, a blink/cooldown state machine with a 60s
// rolling rate, and ROI centroid/lock/drift helpers. No Arduino or
// esp32-camera types are used here, so this is unit tested on the host --
// see fatigue-helmet/firmware/test/test_eye_blink_ear/.
namespace EyeBlinkEAR {

// Standard between-class-variance-maximizing Otsu threshold over an 8-bit
// grayscale buffer of w*h pixels (row-major, one byte per pixel).
inline uint8_t otsuThreshold(const uint8_t *gray, int w, int h) {
    uint32_t hist[256] = {0};
    int total = w * h;
    for (int i = 0; i < total; i++) hist[gray[i]]++;

    float sum = 0.0f;
    for (int t = 0; t < 256; t++) sum += (float)t * (float)hist[t];

    float sumB = 0.0f;
    uint32_t wB = 0;
    float maxVar = 0.0f;
    uint8_t threshold = 0;

    for (int t = 0; t < 256; t++) {
        wB += hist[t];
        if (wB == 0) continue;
        uint32_t wF = (uint32_t)total - wB;
        if (wF == 0) break;

        sumB += (float)t * (float)hist[t];
        float mB = sumB / (float)wB;
        float mF = (sum - sumB) / (float)wF;
        float varBetween = (float)wB * (float)wF * (mB - mF) * (mB - mF);
        if (varBetween > maxVar) {
            maxVar = varBetween;
            threshold = (uint8_t)t;
        }
    }
    return threshold;
}

struct EarResult {
    bool valid;
    float ear;    // sqrt(lambda_minor) / sqrt(lambda_major), 0..1
    float major;  // sqrt(lambda_major), for diagnostics
    float minor;  // sqrt(lambda_minor)
};

// EAR from second-order image moments of a binary mask (w*h, nonzero =
// "on"/blob pixel) -- the minor/major axis ratio of the ellipse with the
// same second moments as the blob. Equivalent to fitting an ellipse to
// the blob's contour, without needing contour tracing at all.
inline EarResult computeEAR(const uint8_t *mask, int w, int h) {
    EarResult r = {false, 0.0f, 0.0f, 0.0f};

    double m00 = 0, m10 = 0, m01 = 0;
    for (int y = 0; y < h; y++) {
        for (int x = 0; x < w; x++) {
            if (mask[y * w + x]) {
                m00 += 1.0;
                m10 += x;
                m01 += y;
            }
        }
    }
    if (m00 < 1.0) return r;  // empty mask

    double cx = m10 / m00;
    double cy = m01 / m00;

    double mu20 = 0, mu02 = 0, mu11 = 0;
    for (int y = 0; y < h; y++) {
        for (int x = 0; x < w; x++) {
            if (mask[y * w + x]) {
                double dx = x - cx;
                double dy = y - cy;
                mu20 += dx * dx;
                mu02 += dy * dy;
                mu11 += dx * dy;
            }
        }
    }
    mu20 /= m00;
    mu02 /= m00;
    mu11 /= m00;

    double trace = mu20 + mu02;
    double diff = sqrt((mu20 - mu02) * (mu20 - mu02) + 4.0 * mu11 * mu11);
    double lambdaMajor = (trace + diff) / 2.0;
    double lambdaMinor = (trace - diff) / 2.0;
    if (lambdaMinor < 0.0) lambdaMinor = 0.0;

    r.major = (float)sqrt(lambdaMajor);
    r.minor = (float)sqrt(lambdaMinor);
    r.valid = true;
    r.ear = (r.major > 1e-6f) ? (r.minor / r.major) : 0.0f;
    return r;
}

// Isolates the single largest 4-connected component of "on" pixels in
// `mask` (w*h) into `outMask` (same size, caller-allocated, zeroed by this
// function). Everything outside that one component -- a stray eyelash
// fragment, a shadow speck, JPEG noise -- is dropped before EAR is computed
// on it.
//
// This is the fix for computeEAR() averaging in every thresholded pixel in
// the crop regardless of whether it's actually part of the same blob:
// retrospective validation (real footage, 2026-09-04) found isolating the
// blob first and THEN computing moments nearly doubles the achieved EAR
// drop on a real blink (min 0.291 -> 0.198 over a real session) versus
// computeEAR() run directly on the raw mask, for the same input pixels.
//
// Deliberately NOT full contour tracing + parametric ellipse fit (what the
// offline eye_ear.py pipeline does via cv2.fitEllipse): that goes further
// (min 0.062 on the same data) but needs a hand-written boundary tracer and
// a least-squares ellipse solver in C, and was shown on the same data to be
// occasionally unstable on small/partial contours (one frame mid-blink
// spiked back to 0.97). This is the cheaper, more stable middle step: same
// moment math already validated by computeEAR()'s own tests, just fed a
// cleaned-up mask first.
//
// Bounded by construction, unlike a full-frame connected-component search
// (which EyeBlinkEAR deliberately avoids elsewhere -- see findDarkestWindow's
// doc comment): this runs over the small, FIXED-size locked EAR crop, not a
// search region, so a plain BFS with a queue capacity of exactly w*h entries
// can never overflow -- each pixel is enqueued at most once.
//
// labelScratch and queueScratch must be caller-provided, >= w*h entries
// each (int16_t / uint16_t respectively). Returns false if the mask is
// empty (no "on" pixels at all).
inline bool isolateLargestComponent(const uint8_t *mask, int w, int h,
                                     int16_t *labelScratch, uint16_t *queueScratch,
                                     uint8_t *outMask) {
    int n = w * h;
    memset(labelScratch, 0, (size_t)n * sizeof(int16_t));
    memset(outMask, 0, (size_t)n);

    int16_t nextLabel = 0;
    int16_t bestLabel = -1;
    int bestSize = 0;
    static const int dx[4] = {-1, 1, 0, 0};
    static const int dy[4] = {0, 0, -1, 1};

    for (int start = 0; start < n; start++) {
        if (!mask[start] || labelScratch[start] != 0) continue;

        nextLabel++;
        int qHead = 0, qTail = 0;
        queueScratch[qTail++] = (uint16_t)start;
        labelScratch[start] = nextLabel;
        int compSize = 0;

        while (qHead < qTail) {
            uint16_t idx = queueScratch[qHead++];
            compSize++;
            int x = idx % w;
            int y = idx / w;
            for (int k = 0; k < 4; k++) {
                int nx = x + dx[k];
                int ny = y + dy[k];
                if (nx < 0 || nx >= w || ny < 0 || ny >= h) continue;
                int nidx = ny * w + nx;
                if (mask[nidx] && labelScratch[nidx] == 0) {
                    labelScratch[nidx] = nextLabel;
                    queueScratch[qTail++] = (uint16_t)nidx;
                }
            }
        }

        if (compSize > bestSize) {
            bestSize = compSize;
            bestLabel = nextLabel;
        }
    }

    if (bestLabel < 0) return false;
    for (int i = 0; i < n; i++) {
        if (labelScratch[i] == bestLabel) outMask[i] = 1;
    }
    return true;
}

// ── Corneal-glint blink detection ─────────────────────────────────────────
// Counts "specular" pixels (>= level) in a grayscale region. The corneal
// glint -- the small mirror reflection off the wet surface of the eye -- is
// present in essentially every open-eye frame and DISAPPEARS the moment the
// eyelid covers the cornea, because skin is diffuse and doesn't produce a
// specular highlight.
//
// This is the cheapest operation in this whole header: one compare and one
// increment per pixel. No Otsu, no moments, no contour tracing, no ellipse
// fit, no adaptive percentile baseline.
inline int countGlintPixels(const uint8_t *gray, int w, int h, uint8_t level) {
    int n = w * h;
    int count = 0;
    for (int i = 0; i < n; i++) {
        if (gray[i] >= level) count++;
    }
    return count;
}

// Counts pixels darker than (mean - offsetBelowMean) in a region. Used on a
// WIDER neighbourhood than the glint ROI to answer: "is the dark pupil/iris
// still anywhere nearby?"
//
// This is the cue that separates a real blink from a GAZE SHIFT. When the
// eyelid closes, the dark pupil vanishes completely. When the eye merely
// rotates to look sideways, the pupil is still there -- it has just moved,
// leaving bright sclera behind in the glint ROI. Glint-absence alone cannot
// tell those apart (validated on session_067: an eye roll at t=21.6s emptied
// the glint ROI and raised its brightness, satisfying both earlier cues, and
// was reported as a blink that never happened).
//
// The threshold is relative to the region's own mean, so it does not care
// about absolute lighting level.
inline int countDarkPixels(const uint8_t *gray, int w, int h, int offsetBelowMean) {
    int n = w * h;
    if (n <= 0) return 0;
    uint32_t sum = 0;
    for (int i = 0; i < n; i++) sum += gray[i];
    int thr = (int)(sum / (uint32_t)n) - offsetBelowMean;
    if (thr < 0) return 0;
    int count = 0;
    for (int i = 0; i < n; i++) if (gray[i] < thr) count++;
    return count;
}

// Glint count AND mean brightness of the same region in ONE pass -- the two
// cues GlintBlinkDetector needs. Costs one compare plus one add per pixel.
inline void glintAndBrightness(const uint8_t *gray, int w, int h, uint8_t level,
                                int &outGlintPx, int &outMeanBrightness) {
    int n = w * h;
    int count = 0;
    uint32_t sum = 0;
    for (int i = 0; i < n; i++) {
        uint8_t v = gray[i];
        sum += v;
        if (v >= level) count++;
    }
    outGlintPx = count;
    outMeanBrightness = (n > 0) ? (int)(sum / (uint32_t)n) : 0;
}

// Blink detector built on glint presence/absence rather than eye SHAPE.
//
// Why shape was abandoned: retrospective validation on real footage
// (session_040, 2026-09-04) showed every shape-based metric tried --
// whole-mask image moments, largest-connected-component moments, and true
// contour+fitEllipse -- was dominated by lighting gradients across the
// curved iris and by which crop edge the dark region happened to touch,
// not by eyelid state. All of them produced false "blinks" on a wide-open
// eye. Glint presence is a binary, physically-grounded cue that none of
// those failure modes affect.
//
// Tuned deliberately for PRECISION over recall (a missed blink is
// acceptable; a false alarm on a rider's helmet is not):
//   - requires the glint to be gone for MIN_ABSENT consecutive frames, so a
//     single noisy frame or a momentarily dimmed reflection can't fire it
//   - requires it to come BACK within MAX_ABSENT frames, so a covered lens,
//     darkness, or the eye leaving frame reads as "no data", not a blink
//   - counts the blink only on recovery (absent -> present), so a partial
//     closure that never fully reopens is never counted
//
// Validated on session_040: 12 detections over 61 s (~11.8 blinks/min,
// squarely in the normal 8-18/min range), and all 12 were confirmed real
// closures by frame-by-frame inspection -- no false positives. The
// MIN_ABSENT >= 2 rule is what rejects the ambiguous single-frame dips.
//
// IMPORTANT: MIN_ABSENT counts PROCESSED frames, so the caller must process
// every captured frame for these numbers to hold. At the ~8 fps this
// hardware actually achieves, a typical 250-300 ms blink spans only ~2
// frames -- throttling would drop it into the sampling gap entirely.
struct GlintBlinkDetector {
    static const uint8_t GLINT_LEVEL   = 200;  // intensity counted as specular
    static const int MIN_GLINT_PX      = 1;    // QVGA: glint is ~4x smaller than at VGA
    static const int MIN_ABSENT_FRAMES = 2;    // shortest run counted as a blink
    static const int MAX_ABSENT_FRAMES = 25;   // longer => occlusion/darkness, not a blink
    static const int MAX_BLINKS_TRACKED = 60;

    // ── Second, independent cue ──────────────────────────────────────────
    // Glint absence alone can't distinguish "the lid covered the cornea"
    // from "the reflection drifted out of the crop while the eye stayed
    // open" -- the latter would be a false positive, the exact thing we
    // most need to avoid. But the two cases differ physically: a real
    // closure replaces the dark iris with skin, so the region gets
    // BRIGHTER, while a glint that merely drifted away leaves the dark
    // iris still filling the crop.
    //
    // Measured on session_040: all 9 post-lock blinks brightened the ROI
    // by +4.1 to +33.6 grey levels against the open-eye median. 3 is set
    // well under the weakest of those so it corroborates without
    // rejecting genuine blinks.
    static const int MIN_BRIGHTEN = 3;
    static constexpr float OPEN_BRIGHTNESS_ALPHA = 0.05f;  // slow EMA, tracks lighting drift

    // ── Third cue: the dark pupil must actually be GONE ──────────────────
    // Rejects gaze shifts, which empty the glint ROI without the eye ever
    // closing. Originally 0.65, chosen from session_067 alone where real
    // blinks fell to 5-50% of the open-eye dark count and an eye roll reached
    // 84%.
    //
    // Re-measured across sessions 023/040/067/100 at the locked ROI, splitting
    // candidates by whether they match a blink found with the ROI pinned on
    // the pupil (23 real candidates, 94 non-blinks):
    //
    //     dark ratio    median   p90    max
    //     real blinks     0.05   0.69   0.97
    //     non-blinks      0.64   1.09  12.14
    //
    // 0.65 sat directly on the real distribution's p90, so it was clipping
    // genuine blinks. Recall against that reference, holding MIN_BRIGHTEN:
    //
    //     0.65   15 real   5 noise      <- previous
    //     0.70   17 real   5 noise
    //     0.75   17 real   5 noise      <- here, centre of the plateau
    //     0.78   17 real   5 noise
    //     0.80   17 real   6 noise
    //
    // Two more blinks for no additional false positives, on a plateau rather
    // than a single point. Loosening MIN_BRIGHTEN was measured too and is NOT
    // a free win (2 -> 18 real but 6 noise), so it stays at 3.
#ifndef EAR_MAX_DARK_FRACTION_X100
#define EAR_MAX_DARK_FRACTION_X100 75
#endif
    static constexpr float MAX_DARK_FRACTION = EAR_MAX_DARK_FRACTION_X100 / 100.0f;
    static const int DARK_OFFSET_BELOW_MEAN = 28;   // for countDarkPixels()

    // ── Baseline seeding ────────────────────────────────────────────────
    // openBrightness and openDarkPx used to be seeded from a SINGLE open-eye
    // frame and then moved by a slow EMA (alpha 0.05, so ~20 frames to shift).
    // Both gates below are tight -- 3 grey levels, and a 0.65 ratio -- so one
    // unrepresentative seed frame skewed every decision for the rest of the
    // session. Measured on session_100 with the ROI fixed and only the start
    // frame varied, the blink count swung between 2 and 9.
    //
    // Seeding from the MEDIAN of the first N open-eye frames removes the
    // dependence on any one frame, and the median (not the mean) keeps a
    // half-closed or motion-blurred sample from dragging the reference.
    // Setting this to 1 reproduces the old single-sample behaviour.
#ifndef EAR_BASELINE_WARMUP_N
#define EAR_BASELINE_WARMUP_N 12
#endif
    static const int BASELINE_WARMUP_N = EAR_BASELINE_WARMUP_N;

    int  absentRun = 0;
    bool sawValidRun = false;      // current absent run is within [MIN, MAX]
    uint16_t warmBright[BASELINE_WARMUP_N] = {0};
    uint16_t warmDark[BASELINE_WARMUP_N]   = {0};
    int  warmCount = 0;
    bool baselineReady = false;
    float openBrightness = -1.0f;  // median-seeded, then EMA; see above
    int  brightestInRun = 0;       // peak ROI brightness during the current absent run
    float openDarkPx = -1.0f;      // EMA of wide-region dark pixels while eye is open
    int  minDarkInRun = 0x7FFFFFFF;// fewest dark pixels seen during the current run
    uint32_t blinkTimestamps[MAX_BLINKS_TRACKED] = {0};
    int blinkCount = 0;

    // ── Per-candidate diagnostics ───────────────────────────────────────
    // Written whenever a glint-absent run of plausible duration ENDS, whether
    // or not it was accepted. Without these, a missed blink is indistinguish-
    // able from a blink the glint cue never noticed, and tuning the thresholds
    // is guesswork. ~24 bytes, and host tooling reads them every frame.
    bool  dbgCandidate   = false;  // a valid-duration run ended this frame
    int   dbgRunLen      = 0;
    int   dbgBrightest   = 0;
    float dbgOpenBright  = 0.0f;
    int   dbgMinDark     = 0;
    float dbgOpenDark    = 0.0f;
    bool  dbgBrightened  = false;
    bool  dbgPupilGone   = false;

    // Median of the first n entries. n <= BASELINE_WARMUP_N and this runs once
    // per session, so an insertion sort on a scratch copy is the right tool.
    static uint16_t medianOf(const uint16_t *src, int n) {
        uint16_t tmp[BASELINE_WARMUP_N];
        for (int i = 0; i < n; i++) tmp[i] = src[i];
        for (int i = 1; i < n; i++) {
            uint16_t v = tmp[i];
            int j = i - 1;
            while (j >= 0 && tmp[j] > v) { tmp[j + 1] = tmp[j]; j--; }
            tmp[j + 1] = v;
        }
        return tmp[n / 2];
    }

    void pushBlink(uint32_t nowMs) {
        if (blinkCount < MAX_BLINKS_TRACKED) {
            blinkTimestamps[blinkCount++] = nowMs;
        } else {
            memmove(blinkTimestamps, blinkTimestamps + 1,
                    (MAX_BLINKS_TRACKED - 1) * sizeof(uint32_t));
            blinkTimestamps[MAX_BLINKS_TRACKED - 1] = nowMs;
        }
    }

    // Feed one processed frame's glint pixel count and the ROI's mean
    // brightness. Returns true on the frame where a blink is confirmed
    // (the recovery frame), which requires BOTH cues to agree: the glint
    // went away for a plausible blink duration, AND the region brightened
    // while it was gone.
    bool update(int glintPx, int roiBrightness, int wideDarkPx, uint32_t nowMs) {
        bool present = (glintPx >= MIN_GLINT_PX);
        bool blinkEvent = false;
        dbgCandidate = false;   // set only on the frame a candidate is judged

        if (!present) {
            absentRun++;
            if (roiBrightness > brightestInRun) brightestInRun = roiBrightness;
            if (wideDarkPx < minDarkInRun) minDarkInRun = wideDarkPx;
            if (absentRun >= MIN_ABSENT_FRAMES && absentRun <= MAX_ABSENT_FRAMES) {
                sawValidRun = true;
            } else if (absentRun > MAX_ABSENT_FRAMES) {
                sawValidRun = false;   // too long -- not a blink, don't count on recovery
            }
        } else {
            // Only learn the open-eye references while the eye is actually open.
            if (!baselineReady) {
                if (warmCount < BASELINE_WARMUP_N) {
                    warmBright[warmCount] = (uint16_t)roiBrightness;
                    warmDark[warmCount]   = (uint16_t)wideDarkPx;
                    warmCount++;
                }
                if (warmCount >= BASELINE_WARMUP_N) {
                    openBrightness = (float)medianOf(warmBright, warmCount);
                    openDarkPx     = (float)medianOf(warmDark, warmCount);
                    baselineReady  = true;
                }
            } else {
                openBrightness += OPEN_BRIGHTNESS_ALPHA * ((float)roiBrightness - openBrightness);
                openDarkPx     += OPEN_BRIGHTNESS_ALPHA * ((float)wideDarkPx - openDarkPx);
            }

            // No blink is claimed before the baseline exists. The original code
            // intended to bypass these cues while unseeded (`openBrightness <
            // 0.0f`), but that test sat after the assignment and never fired.
            // Bypassing is the wrong repair anyway: this module's own reasoning
            // is that glint absence ALONE cannot tell a lid closure from the
            // reflection drifting out of the crop, so an uncorroborated blink
            // during warmup is exactly the false positive the three cues exist
            // to prevent. Measured: bypassing inflated counts as the warmup
            // lengthened (9-12 blinks at N=30 against 6-8 at N=20). Abstaining
            // costs only the blinks in the first N open-eye frames -- about two
            // seconds, and in production the detector is already running during
            // ARMING, before the recording starts.
            if (sawValidRun && baselineReady) {
                dbgCandidate  = true;
                dbgRunLen     = absentRun;
                dbgBrightest  = brightestInRun;
                dbgOpenBright = openBrightness;
                dbgMinDark    = minDarkInRun;
                dbgOpenDark   = openDarkPx;
                bool brightened = ((float)brightestInRun >= openBrightness + (float)MIN_BRIGHTEN);
                // Cue 3: the dark pupil must have actually disappeared, not
                // just moved out of the glint ROI (a gaze shift).
                bool pupilGone = ((float)minDarkInRun <= openDarkPx * MAX_DARK_FRACTION);
                dbgBrightened = brightened;
                dbgPupilGone  = pupilGone;
                if (brightened && pupilGone) {
                    blinkEvent = true;
                    pushBlink(nowMs);
                }
            }
            absentRun = 0;
            sawValidRun = false;
            brightestInRun = 0;
            minDarkInRun = 0x7FFFFFFF;
        }
        return blinkEvent;
    }

    // 60-second rolling rate in blinks/minute.
    float rollingRateBpm(uint32_t nowMs) {
        int evict = 0;
        while (evict < blinkCount && (nowMs - blinkTimestamps[evict]) > 60000) evict++;
        if (evict > 0) {
            memmove(blinkTimestamps, blinkTimestamps + evict,
                    (blinkCount - evict) * sizeof(uint32_t));
            blinkCount -= evict;
        }
        return (float)blinkCount;
    }
};

// Threshold that isolates the darkest `percentile` percent of pixels (e.g.
// 10.0 for the darkest 10%), rather than Otsu's variance-maximizing ~50/50
// split. Used for pupil localization (findDarkestWindow's input mask), where
// we specifically want only the most extreme dark pixels -- the pupil is
// usually much darker than surrounding shadow/skin -- not a generic
// foreground/background split. Otsu's wider net was found (via retrospective
// validation against a real session) to let a large diffuse shadow region
// dominate a small genuinely-dark pupil.
inline uint8_t percentileThreshold(const uint8_t *gray, int w, int h, float percentile) {
    uint32_t hist[256] = {0};
    int total = w * h;
    for (int i = 0; i < total; i++) hist[gray[i]]++;

    if (percentile < 0.0f) percentile = 0.0f;
    if (percentile > 100.0f) percentile = 100.0f;
    long targetCount = (long)((percentile / 100.0f) * (float)total);

    long cumulative = 0;
    for (int t = 0; t < 256; t++) {
        cumulative += hist[t];
        if (cumulative >= targetCount) return (uint8_t)t;
    }
    return 255;
}

// Centroid (center of mass) of the "on" pixels in a mask. Returns false
// if the mask is empty. Coordinates are local to the given buffer (0..w,
// 0..h) -- the caller maps them back to full-frame coordinates if the
// buffer represents a sub-region.
inline bool centroid(const uint8_t *mask, int w, int h, float &outCx, float &outCy) {
    double m00 = 0, m10 = 0, m01 = 0;
    for (int y = 0; y < h; y++) {
        for (int x = 0; x < w; x++) {
            if (mask[y * w + x]) {
                m00 += 1.0;
                m10 += x;
                m01 += y;
            }
        }
    }
    if (m00 < 1.0) return false;
    outCx = (float)(m10 / m00);
    outCy = (float)(m01 / m00);
    return true;
}

// Finds the winSize x winSize window with the highest count of "on" pixels
// (the densest concentration of below-threshold pixels) within a mask, using
// a separable two-pass box filter (row sums, then column sums) instead of a
// full summed-area table -- every intermediate sum stays bounded by
// winSize*winSize, so a 16-bit scratch buffer is enough even for a
// full-frame-sized search region, with no wide (32-bit) integral image
// needed.
//
// This is more fragmentation-tolerant than a bare centroid() call: a real
// pupil that breaks into a few small disconnected speckles (JPEG noise)
// still scores highly as long as the speckles fall within one window,
// without needing connected-component labeling (which would need
// unbounded-size queues/label buffers to implement safely on a
// microcontroller). It also naturally prefers a small compact dark region
// (a pupil) over a larger, more diffuse dark region (a shadow) of similar
// or even lower average darkness, since the diffuse region rarely packs as
// many "on" pixels into one small window as a solid compact blob does.
//
// rowSumScratch must be caller-provided, at least w*h uint16_t entries.
// strideX/strideY (>=1) skip candidate window positions to trade thoroughness
// for speed -- 1 checks every position, larger values check fewer.
// Returns false if no window has any "on" pixels at all, or if winSize
// doesn't fit within w/h.
inline bool findDarkestWindow(const uint8_t *mask, int w, int h, int winSize,
                               int strideX, int strideY,
                               uint16_t *rowSumScratch,
                               float &outCx, float &outCy) {
    if (winSize <= 0 || winSize > w || winSize > h) return false;
    if (strideX < 1) strideX = 1;
    if (strideY < 1) strideY = 1;

    // Pass 1: rowSumScratch[y*w + x] = sum of mask[y][x .. x+winSize)
    for (int y = 0; y < h; y++) {
        uint16_t sum = 0;
        for (int x = 0; x < winSize; x++) sum = (uint16_t)(sum + mask[y * w + x]);
        rowSumScratch[y * w + 0] = sum;
        for (int x = 1; x <= w - winSize; x++) {
            sum = (uint16_t)(sum - mask[y * w + (x - 1)] + mask[y * w + (x - 1 + winSize)]);
            rowSumScratch[y * w + x] = sum;
        }
    }

    // Pass 2: slide winSize-tall column sums over the row sums, tracking the
    // best (x, y) top-left window position seen.
    int lastX = w - winSize;
    int lastY = h - winSize;
    int bestX = -1, bestY = -1;
    uint32_t bestSum = 0;

    for (int x = 0; x <= lastX; x += strideX) {
        uint32_t colSum = 0;
        for (int y = 0; y < winSize; y++) colSum += rowSumScratch[y * w + x];
        if (colSum > bestSum) { bestSum = colSum; bestX = x; bestY = 0; }
        for (int y = 1; y <= lastY; y++) {
            colSum = colSum - rowSumScratch[(y - 1) * w + x] + rowSumScratch[(y - 1 + winSize) * w + x];
            if ((y % strideY) == 0 && colSum > bestSum) { bestSum = colSum; bestX = x; bestY = y; }
        }
    }

    if (bestX < 0 || bestSum == 0) return false;

    // Refine: centroid of the "on" pixels within the winning window only
    // (full-buffer coordinates), not the whole window's geometric center.
    double sx = 0, sy = 0;
    int cnt = 0;
    for (int y = 0; y < winSize; y++) {
        for (int x = 0; x < winSize; x++) {
            if (mask[(bestY + y) * w + (bestX + x)]) {
                sx += bestX + x;
                sy += bestY + y;
                cnt++;
            }
        }
    }
    if (cnt == 0) return false;

    outCx = (float)(sx / cnt);
    outCy = (float)(sy / cnt);
    return true;
}

// ── Temporal-motion eye localizer ──────────────────────────────────────────
// Locates the eye using the one property that reliably distinguishes it in a
// helmet-fixed view: it is the only region in frame that *changes*. The
// cheek, brow, hair and background are all rigidly attached to the head and
// move with the camera; only the eyelid and iris move independently, and they
// do so exactly when we care (a blink).
//
// This replaces "find the darkest blob", which has no eye-specific prior and
// was validated on sessions/session_023 to lock onto cheek shadow and brow
// instead of the eye. Retrospective validation of THIS method on the same
// session put the lock inside the eye in 7 of 8 independently-sampled
// windows spread across the whole recording.
//
// Cost: one decimated absolute-difference pass per frame over a GRID_W x
// GRID_H grid (4800 cells), i.e. a few thousand byte-ops -- negligible next
// to the JPEG decode that already happens. Memory is a fixed ~24 KB of
// plain arrays: no heap, no STL, same constraints as the rest of this header.
//
// Validated parameters (session_023, decimated-resolution sweep):
//   - 80x60 grid is the sweet spot: 40x30 loses peak confidence (1.45 vs
//     1.93), 160x120 gains little (2.16) for 4x the work.
//   - ~60 frames (3 s at 20 fps) is ENOUGH, and scores better than longer
//     windows (conf 3.18 at 60 frames vs 1.93 at 600) -- a long accumulation
//     smears the peak as the helmet drifts. Short, repeated locks beat one
//     long one.
// ── Localizer v1 (frozen) ─────────────────────────────────────────────────
// Shipped implementation, kept byte-identical as the regression baseline that
// later versions are measured against. Do not change this struct; add a new
// version that derives from it instead (see MotionLocatorV2).
//
// Known limitation, measured across sessions 023/040/067/100: the accumulated
// sum of |frame delta| rewards a CONTINUOUS low-level noise floor over the
// BRIEF bursts a blink actually produces. On session_100 the left band of the
// frame carried ~3x the temporal noise of the frame median, which out-
// integrated the eye over the 60-frame lock window; the peak landed 227 px
// from the pupil, in a corner, and the session recorded 0 blinks. v1 also
// CLAMPS a peak whose ROI would not fit in frame rather than rejecting it,
// which is how a peak at x=2 became a ROI at x=0.
struct MotionLocatorV1 {
    static const int GRID_W = 80;
    static const int GRID_H = 60;
    static const int GRID_N = GRID_W * GRID_H;
    static const int BLUR_RADIUS = 3;   // 7x7 box blur on the grid

    uint8_t  cur[GRID_N];    // member, not a local: 4800 B is too much to put
                             // on a FreeRTOS task stack (cameraTask's is 4-8 KB)
    uint8_t  prev[GRID_N];
    uint16_t energy[GRID_N];
    uint16_t smooth[GRID_N];
    bool     havePrev;
    int      framesAccumulated;

    MotionLocatorV1() { reset(); }

    void reset() {
        memset(prev, 0, sizeof(prev));
        memset(energy, 0, sizeof(energy));
        memset(smooth, 0, sizeof(smooth));
        havePrev = false;
        framesAccumulated = 0;
    }

    // Box-average `gray` (w*h, 8-bit) down onto the GRID_W x GRID_H grid,
    // then accumulate |current - previous| per cell. Frames smaller than the
    // grid in either axis are rejected (returns without accumulating).
    void addFrame(const uint8_t *gray, int w, int h) {
        if (w < GRID_W || h < GRID_H) return;

        for (int gy = 0; gy < GRID_H; gy++) {
            int sy0 = (int)((int64_t)gy * h / GRID_H);
            int sy1 = (int)((int64_t)(gy + 1) * h / GRID_H);
            if (sy1 <= sy0) sy1 = sy0 + 1;
            for (int gx = 0; gx < GRID_W; gx++) {
                int sx0 = (int)((int64_t)gx * w / GRID_W);
                int sx1 = (int)((int64_t)(gx + 1) * w / GRID_W);
                if (sx1 <= sx0) sx1 = sx0 + 1;
                uint32_t sum = 0;
                uint32_t cnt = 0;
                for (int sy = sy0; sy < sy1; sy++) {
                    const uint8_t *row = gray + (size_t)sy * w;
                    for (int sx = sx0; sx < sx1; sx++) { sum += row[sx]; cnt++; }
                }
                cur[gy * GRID_W + gx] = (uint8_t)(sum / (cnt ? cnt : 1));
            }
        }

        if (havePrev) {
            for (int i = 0; i < GRID_N; i++) {
                int d = (int)cur[i] - (int)prev[i];
                if (d < 0) d = -d;
                uint32_t acc = (uint32_t)energy[i] + (uint32_t)d;
                energy[i] = (acc > 0xFFFFu) ? 0xFFFFu : (uint16_t)acc;  // saturate
            }
            framesAccumulated++;
        }
        memcpy(prev, cur, sizeof(prev));
        havePrev = true;
    }

    // Separable box blur of `energy` into `smooth`, then argmax.
    // Returns the peak location in FULL-FRAME coordinates, plus a confidence
    // = peak / mean. Confidence is the "do I actually see an eye?" gate that
    // the darkest-blob localizer never had: a flat energy map (nothing
    // moving, or motion smeared everywhere by the whole head moving) scores
    // near 1.0, while a clean single moving region scores well above it.
    // Returns false if too few frames have been accumulated.
    bool peak(int fullW, int fullH, int minFrames,
              float &outCx, float &outCy, float &outConfidence) {
        if (framesAccumulated < minFrames) return false;

        // Horizontal pass: energy -> smooth
        for (int y = 0; y < GRID_H; y++) {
            const uint16_t *src = energy + y * GRID_W;
            uint16_t *dst = smooth + y * GRID_W;
            for (int x = 0; x < GRID_W; x++) {
                uint32_t sum = 0;
                int cnt = 0;
                for (int k = -BLUR_RADIUS; k <= BLUR_RADIUS; k++) {
                    int xx = x + k;
                    if (xx < 0 || xx >= GRID_W) continue;
                    sum += src[xx]; cnt++;
                }
                dst[x] = (uint16_t)(sum / (cnt ? cnt : 1));
            }
        }
        // Vertical pass: smooth -> smooth, one column at a time via a stack
        // copy so the running reads aren't clobbered by the writes.
        for (int x = 0; x < GRID_W; x++) {
            uint16_t col[GRID_H];
            for (int y = 0; y < GRID_H; y++) col[y] = smooth[y * GRID_W + x];
            for (int y = 0; y < GRID_H; y++) {
                uint32_t sum = 0;
                int cnt = 0;
                for (int k = -BLUR_RADIUS; k <= BLUR_RADIUS; k++) {
                    int yy = y + k;
                    if (yy < 0 || yy >= GRID_H) continue;
                    sum += col[yy]; cnt++;
                }
                smooth[y * GRID_W + x] = (uint16_t)(sum / (cnt ? cnt : 1));
            }
        }

        uint32_t total = 0;
        int bestIdx = 0;
        uint16_t bestVal = 0;
        for (int i = 0; i < GRID_N; i++) {
            total += smooth[i];
            if (smooth[i] > bestVal) { bestVal = smooth[i]; bestIdx = i; }
        }
        if (bestVal == 0) return false;

        float mean = (float)total / (float)GRID_N;
        outConfidence = (mean > 1e-6f) ? ((float)bestVal / mean) : 0.0f;

        int gx = bestIdx % GRID_W;
        int gy = bestIdx / GRID_W;
        outCx = ((float)gx + 0.5f) * (float)fullW / (float)GRID_W;
        outCy = ((float)gy + 0.5f) * (float)fullH / (float)GRID_H;
        return true;
    }
};


// ── Localizer v2 ──────────────────────────────────────────────────────────
// Derives from v1 and changes exactly one thing: a peak whose ROI would not
// fit inside the frame is REJECTED rather than clamped inward.
//
// v1 fed its peak to lockRoiFromSamples(), which clamps the ROI to the frame.
// A peak 2 px from the left edge therefore became a ROI at x=0 -- a position
// the eye can never occupy, because the camera is mounted to look at it. The
// clamp turned "I found something at the very edge" into a confident-looking
// lock on a region that was never a candidate. Rejecting instead means the
// localizer keeps searching, or reports failure honestly.
//
// Set roiSize to enable the constraint; 0 preserves v1's behaviour exactly.
//
// WHAT WAS MEASURED, AND WHAT DID NOT WORK
//
// This started as an investigation into session_100, where v1 locked 252 px
// from the pupil and the session recorded 0 blinks. The obvious-looking
// causes were each tested against sessions 023/040/067/100 and each rejected:
//
//   - "A specular flare wins the lock." No: nothing in the frame was near
//     saturation (max grid brightness 73 of 255), and a brightness gate did
//     not separate the eye (44.8) from the winning cell (61.4).
//   - "Summing |delta| rewards a continuous noise floor over brief blinks."
//     Directionally true -- the losing band carried 3.1x the frame's median
//     temporal noise -- but every fix built on it failed. Second temporal
//     differences, per-cell burst counting against a frugal-median floor, a
//     fixed-threshold burst count, and dark-weighted variants were compiled
//     and run in 41 configurations. NONE moved session_100 below 231 px.
//   - Per-cell normalisation specifically cannot work here: the eye cell and
//     the winning band cell have near-identical median |d2| (3.5 vs 3.0), so
//     there is no per-cell noise difference to normalise away.
//
// The actual cause was the LOCK WINDOW, not the statistic. EAR_MOTION_MIN
// _FRAMES was 60, which at this camera's real ~12 fps is about 5 seconds and
// contains roughly ONE blink at a normal 14 blinks/min. One blink is a single
// sample; no statistic can separate "the cell that blinked once" from "the
// cell where a light moved once". Raising the window to 240 frames (~20 s,
// ~5 blinks) drops v1's own mean error from 74.6 px to 14.4 px and fixes
// session_100 outright (252 px -> 12 px). See EAR_MOTION_MIN_FRAMES at the
// call sites, which v2 raises.
//
// With an adequate window the burst-counting machinery gave no further gain
// (mean 16.2 px vs v1's 14.4 px) for 28.8 KB of state and an extra pass over
// the grid every frame, so it is deliberately NOT shipped. The negative
// result is recorded here so the next version does not re-derive it.
struct MotionLocatorV2 : MotionLocatorV1 {
    int roiSize;   // 0 = no fit constraint (v1 behaviour)

    MotionLocatorV2() : roiSize(0) {}

    // roiSize is configuration, not accumulation state, so reset() must not
    // clear it -- the retry loop resets between lock attempts.
    void setRoiSize(int s) { roiSize = s; }

    bool peak(int fullW, int fullH, int minFrames,
              float &outCx, float &outCy, float &outConfidence) {
        float vCx, vCy, vConf;
        if (!MotionLocatorV1::peak(fullW, fullH, minFrames, vCx, vCy, vConf))
            return false;   // too few frames, or nothing moved at all

        if (roiSize <= 0) {                 // constraint disabled: v1 verbatim
            outCx = vCx; outCy = vCy; outConfidence = vConf;
            return true;
        }

        // v1 leaves the blurred energy map in smooth[]. Re-run the argmax over
        // it, skipping cells whose ROI would hang off the edge, and take the
        // confidence relative to the cells actually eligible to win.
        const int half = roiSize / 2;
        uint32_t total = 0;
        int      counted = 0;
        int      bestIdx = -1;
        uint16_t bestVal = 0;

        for (int gy = 0; gy < GRID_H; gy++) {
            float cy = ((float)gy + 0.5f) * (float)fullH / (float)GRID_H;
            if (cy - half < 0.0f || cy + half > (float)fullH) continue;
            for (int gx = 0; gx < GRID_W; gx++) {
                float cx = ((float)gx + 0.5f) * (float)fullW / (float)GRID_W;
                if (cx - half < 0.0f || cx + half > (float)fullW) continue;
                int i = gy * GRID_W + gx;
                total += smooth[i];
                counted++;
                if (smooth[i] > bestVal) { bestVal = smooth[i]; bestIdx = i; }
            }
        }

        if (bestIdx < 0 || bestVal == 0) return false;

        float mean = counted ? ((float)total / (float)counted) : 0.0f;
        outConfidence = (mean > 1e-6f) ? ((float)bestVal / mean) : 0.0f;

        int gx = bestIdx % GRID_W;
        int gy = bestIdx / GRID_W;
        outCx = ((float)gx + 0.5f) * (float)fullW / (float)GRID_W;
        outCy = ((float)gy + 0.5f) * (float)fullH / (float)GRID_H;
        return true;
    }
};


// ── Localizer v3 ──────────────────────────────────────────────────────────
// Derives from v2 and changes the unit the lock window is measured in: wall
// clock instead of frame count.
//
// v2 waits for EAR_MOTION_MIN_FRAMES frames. Nothing in that path consults a
// clock, so the window's real duration is set by whatever frame rate the
// camera happens to achieve -- and that varies with the EAR decode cost and
// SD write load. Measured across the recorded sessions, 240 frames means:
//
//     session_023  20.0 fps -> 12.0 s -> ~2.8 blinks in the window
//     session_100  11.9 fps -> 20.2 s -> ~4.7 blinks
//     session_067  11.8 fps -> 20.3 s -> ~4.7 blinks
//     session_040   7.9 fps -> 30.4 s -> ~7.1 blinks   (half the session)
//
// The quantity the localizer actually depends on is BLINKS in the window --
// that was the whole session_100 diagnosis: one blink is a single sample and
// cannot be told apart from one stray light movement. Blinks arrive on a wall
// clock (~14/min), not per frame, so time is the unit that holds the thing
// that matters constant. A 20 s window is ~4.7 blinks at every frame rate
// above.
//
// The frame count does not stop mattering, it becomes a FLOOR. A blink lasts
// roughly 100-300 ms, so at a low enough frame rate a 20 s window would carry
// too few samples to resolve one at all. peak()'s minFrames argument is now
// that floor: v3 locks when BOTH the window has elapsed AND minFrames have
// accumulated, whichever finishes later. At the call sites' 120-frame floor
// this binds only below 6 fps.
//
// A caller that never supplies a timestamp keeps v2's behaviour exactly,
// rather than never locking -- see the two addFrame overloads.
struct MotionLocatorV3 : MotionLocatorV2 {
#ifndef EAR_V3_WINDOW_MS
// Swept over sessions 023/040/067/100: 16-21 s all give 4/4 locks at 12.8 px
// mean error, 15 s and 22 s both drop to 3/4. 18 s is the centre of that
// plateau rather than its edge. The distinction is narrow -- what flips is
// session_040 crossing its 24 px tolerance by a few pixels, and mean error
// only moves 12.8 vs 14.4 -- so treat the window as tuned, not as a constant
// with wide margins. Re-run localizer_eval.py before changing it.
#define EAR_V3_WINDOW_MS 18000
#endif

    uint32_t windowMs;
    uint32_t firstMs;
    uint32_t lastMs;
    bool     haveTime;

    MotionLocatorV3()
        : windowMs(EAR_V3_WINDOW_MS), firstMs(0), lastMs(0), haveTime(false) {}

    void reset() {
        MotionLocatorV2::reset();
        firstMs  = 0;
        lastMs   = 0;
        haveTime = false;
        // windowMs is configuration, not accumulation state: the retry loop
        // resets between attempts and must not lose it.
    }

    void setWindowMs(uint32_t ms) { windowMs = ms; }

    // Timestamped form. Keeps the 3-argument version from v2 visible via the
    // using-declaration below, so a caller without a clock still compiles and
    // simply falls back to frame-count gating.
    void addFrame(const uint8_t *gray, int w, int h, uint32_t nowMs) {
        if (w < GRID_W || h < GRID_H) return;   // same guard as v1, so the
                                                // clock cannot start on a
                                                // frame that was not counted
        MotionLocatorV2::addFrame(gray, w, h);
        if (!haveTime) {
            firstMs  = nowMs;
            haveTime = true;
        }
        lastMs = nowMs;
    }
    using MotionLocatorV2::addFrame;

    bool peak(int fullW, int fullH, int minFrames,
              float &outCx, float &outCy, float &outConfidence) {
        // Unsigned subtraction, so a millis() rollover mid-window yields the
        // correct elapsed time rather than a huge value that locks instantly.
        if (haveTime && (uint32_t)(lastMs - firstMs) < windowMs) return false;

        // minFrames is enforced downstream by v1's own gate, which is what
        // makes it the floor rather than the primary condition.
        return MotionLocatorV2::peak(fullW, fullH, minFrames,
                                     outCx, outCy, outConfidence);
    }
};


// ── Localizer v4 ──────────────────────────────────────────────────────────
// Derives from v3 and adds one step AFTER the motion lock: re-centre the ROI
// on the corneal glint near the peak.
//
// Motion energy peaks on the eyelid, because the lid is what moves. Measured
// across sessions 023/040/067/100 the locked centre lands 9-18 px from the
// pupil in every one -- a consistent offset, not scatter. That matters because
// the detector's cues are computed over the crop: roiBrightness is its MEAN
// and wideDarkPx a dark-pixel fraction, so a pupil near the edge weakens both.
//
// The glint is the cue that works here. It sits ON the cornea, so the
// brightest small cluster near the motion peak is the eye itself:
//
//     v3, no refine        mean lock error 12.8 px
//     v4 glint             mean lock error  9.5 px   (session_067: 9.2 -> 2.2)
//     v4 darkest blob      mean lock error 25.1 px   -- WORSE, do not use
//
// The darkest-blob variant is kept behind EAR_V4_MODE=0 only to keep that
// negative result reproducible. It fails for a reason this codebase already
// knew: darkest-blob was the ORIGINAL localizer and was replaced by motion
// energy, and drift correction is disabled because it "can confidently track
// hair occluding the camera". Unconstrained it pulled session_023's lock
// 49.6 px away, onto eyebrow, and tripled the unmatched detections (17 vs 5).
//
// WHAT THIS DOES NOT BUY. Post-lock blink recall against a pinned reference is
// 15/29 both before and after: session_040 gains a blink, session_067 loses
// one. Lock precision is therefore NOT what limits blink recall right now --
// session_067 locks 2.2 px from the pupil, essentially perfect, and still
// misses 3 of 9. Whatever is costing those blinks is downstream in the
// detector's cues, and further localizer precision has little left to give.
// v4 ships because putting the ROI on the eye is this component's job and it
// does that measurably better, not because it produced more blinks.
//
// The correction is bounded by REFINE_MAX_SHIFT. Unconstrained, glint mode
// never made any session worse -- but that is four sessions, and on unseen
// footage a stray highlight (a spectacle edge, a light source in frame) is
// exactly the failure the guard exists for. 32 admits every beneficial
// correction measured; 20 and 28 were too tight and blocked session_040's.
struct MotionLocatorV4 : MotionLocatorV3 {
#ifndef EAR_V4_MARGIN
#define EAR_V4_MARGIN 16
#endif
#ifndef EAR_V4_PERCENTILE
#define EAR_V4_PERCENTILE 10
#endif
#ifndef EAR_V4_MAX_SHIFT
#define EAR_V4_MAX_SHIFT 32
#endif
    // Search this far beyond the ROI on every side, so the correction range is
    // +/- REFINE_MARGIN.
    static const int REFINE_MARGIN = EAR_V4_MARGIN;
    // Darkest N% of the search region. Percentile, not Otsu: Otsu's ~50/50
    // split lets a large diffuse shadow outvote a small genuinely dark pupil,
    // which is the same reasoning percentileThreshold() was added for.
    static const int REFINE_PERCENTILE = EAR_V4_PERCENTILE;
    // Reject a correction larger than this; see the doc comment above.
    static const int REFINE_MAX_SHIFT = EAR_V4_MAX_SHIFT;
#ifndef EAR_V4_MODE
#define EAR_V4_MODE 1          // 1 = corneal glint (measured best), 0 = darkest blob
#endif
#ifndef EAR_V4_GLINT_LEVEL
#define EAR_V4_GLINT_LEVEL 200 // matches GlintBlinkDetector::GLINT_LEVEL
#endif
#ifndef EAR_V4_GLINT_WIN
#define EAR_V4_GLINT_WIN 8     // a glint is a few pixels across at QVGA
#endif
    static const int GLINT_REFINE_LEVEL = EAR_V4_GLINT_LEVEL;
    static const int GLINT_REFINE_WIN   = EAR_V4_GLINT_WIN;

    // Side length of the square search region for a given ROI size.
    static int refineSide(int roi) { return roi + 2 * REFINE_MARGIN; }

    // Re-centre (cx, cy) onto the darkest blob near it. Returns true if the
    // centre was moved.
    //
    // Storage is caller-supplied rather than owned here: this runs once per
    // session, and on the ESP32 the buffers belong in PSRAM alongside the
    // other EAR scratch. All three must hold refineSide(roiSize)^2 elements.
    bool refine(const uint8_t *gray, int fullW, int fullH,
                uint8_t *scratchGray, uint8_t *scratchMask,
                uint16_t *scratchRow,
                float &cx, float &cy) {
        if (roiSize <= 0 || !gray || !scratchGray || !scratchMask || !scratchRow)
            return false;

        const int side = refineSide(roiSize);
        if (side > fullW || side > fullH) return false;

        // Clamp the search box inside the frame.
        int bx = (int)(cx + 0.5f) - side / 2;
        int by = (int)(cy + 0.5f) - side / 2;
        if (bx < 0) bx = 0;
        if (by < 0) by = 0;
        if (bx + side > fullW) bx = fullW - side;
        if (by + side > fullH) by = fullH - side;

        for (int y = 0; y < side; y++) {
            const uint8_t *src = gray + (size_t)(by + y) * fullW + bx;
            uint8_t *dst = scratchGray + (size_t)y * side;
            for (int x = 0; x < side; x++) dst[x] = src[x];
        }

        const int n = side * side;
        int win;
#if EAR_V4_MODE == 1
        // GLINT mode: re-centre on the corneal reflection instead of the
        // darkest blob. The glint sits ON the cornea, whereas in this footage
        // the darkest thing near the eye is usually eyebrow or lashes.
        (void)REFINE_PERCENTILE;
        for (int i = 0; i < n; i++)
            scratchMask[i] = (scratchGray[i] >= GLINT_REFINE_LEVEL) ? 1 : 0;
        win = GLINT_REFINE_WIN;
#else
        // DARK mode: darkest blob. Percentile, not Otsu -- Otsu's ~50/50 split
        // lets a diffuse shadow outvote a small genuinely dark pupil.
        uint8_t t = percentileThreshold(scratchGray, side, side,
                                        (float)REFINE_PERCENTILE);
        for (int i = 0; i < n; i++) scratchMask[i] = (scratchGray[i] <= t) ? 1 : 0;
        // Window ~ a pupil across, tied to the ROI so it scales with it.
        win = roiSize / 2;
#endif
        float lx = 0.0f, ly = 0.0f;
        if (!findDarkestWindow(scratchMask, side, side, win, 2, 2,
                               scratchRow, lx, ly))
            return false;

        float nx = (float)bx + lx;
        float ny = (float)by + ly;

        float dx = nx - cx, dy = ny - cy;
        if ((dx * dx + dy * dy) >
            (float)(REFINE_MAX_SHIFT * REFINE_MAX_SHIFT))
            return false;   // implausible jump -- keep the motion peak

        cx = nx;
        cy = ny;
        return true;
    }
};

// ── Localizer version selection ───────────────────────────────────────────
// Build with -DEAR_LOCALIZER_VERSION=1 or =2 to fall back to an earlier version;
// v1 is the frozen baseline and v2 the frame-count window. Each is
// kept as the regression baseline. Call sites use the EyeBlinkEAR::MotionLocator
// alias and need no change when this moves.
#ifndef EAR_LOCALIZER_VERSION
#define EAR_LOCALIZER_VERSION 4
#endif

#if EAR_LOCALIZER_VERSION == 1
typedef MotionLocatorV1 MotionLocator;
#elif EAR_LOCALIZER_VERSION == 2
typedef MotionLocatorV2 MotionLocator;
#elif EAR_LOCALIZER_VERSION == 3
typedef MotionLocatorV3 MotionLocator;
#elif EAR_LOCALIZER_VERSION == 4
typedef MotionLocatorV4 MotionLocator;
#else
#error "EAR_LOCALIZER_VERSION must be 1, 2, 3 or 4"
#endif



struct RoiLock {
    int x = 0;
    int y = 0;
    int size = 64;
    bool locked = false;
};

// Median-based ROI lock: xs/ys are full-frame-coordinate centroid samples
// gathered across several frames (some may be bad single-frame misreads --
// the median absorbs those, unlike a mean). Mutates xs/ys in place (sorts
// them) -- pass copies, not shared state. Clamps the resulting ROI to stay
// within [0, frameW) x [0, frameH).
inline bool lockRoiFromSamples(float *xs, float *ys, int n, int roiSize,
                                int frameW, int frameH, RoiLock &out) {
    if (n <= 0) return false;

    for (int i = 1; i < n; i++) {
        float kx = xs[i];
        int j = i - 1;
        while (j >= 0 && xs[j] > kx) { xs[j + 1] = xs[j]; j--; }
        xs[j + 1] = kx;
    }
    for (int i = 1; i < n; i++) {
        float ky = ys[i];
        int j = i - 1;
        while (j >= 0 && ys[j] > ky) { ys[j + 1] = ys[j]; j--; }
        ys[j + 1] = ky;
    }
    float medCx = xs[n / 2];
    float medCy = ys[n / 2];

    int rx = (int)(medCx - roiSize / 2.0f);
    int ry = (int)(medCy - roiSize / 2.0f);
    if (rx + roiSize > frameW) rx = frameW - roiSize;
    if (ry + roiSize > frameH) ry = frameH - roiSize;
    if (rx < 0) rx = 0;
    if (ry < 0) ry = 0;

    out.x = rx;
    out.y = ry;
    out.size = roiSize;
    out.locked = true;
    return true;
}

// Given the ROI's current full-frame center and a freshly-measured
// full-frame centroid, decides whether to nudge the ROI. Returns false
// (caller should leave the ROI alone) if the shift is large enough to
// look like noise (a blink, a shadow) rather than real drift -- otherwise
// outCx/outCy are the EMA-blended new center for the caller to clamp and
// apply.
inline bool driftBlend(float curCx, float curCy, float newCx, float newCy,
                        float maxDriftPx, float alpha,
                        float &outCx, float &outCy) {
    float dx = newCx - curCx;
    float dy = newCy - curCy;
    float shift = sqrtf(dx * dx + dy * dy);
    if (shift >= maxDriftPx) return false;

    outCx = curCx * (1.0f - alpha) + newCx * alpha;
    outCy = curCy * (1.0f - alpha) + newCy * alpha;
    return true;
}

// Adaptive-baseline blink detector + 60s rolling rate. Mirrors
// eye_ear.py's blink logic: baseline = 75th percentile of recent EAR,
// blink fires when EAR drops below baseline * EAR_RATIO_THRESH, gated by
// a warm-up period and a cooldown so one blink isn't counted twice.
struct BlinkDetector {
    static const int BASELINE_WINDOW = 45;  // TEST: scaled for throttle=2
    static const int COOLDOWN_SAMPLES = 9;  // TEST: scaled for throttle=2
    static const int WARMUP_SAMPLES = 36;  // TEST: scaled for throttle=2
    static constexpr float EAR_RATIO_THRESH = 0.70f;
    static const int MAX_BLINKS_TRACKED = 60;

    float history[BASELINE_WINDOW] = {0};
    int historyCount = 0;
    int historyHead = 0;
    int sampleIndex = 0;
    int cooldownRemaining = 0;
    bool inBlinkRun = false;

    uint32_t blinkTimestamps[MAX_BLINKS_TRACKED] = {0};
    int blinkCount = 0;

    float baseline() const {
        if (historyCount == 0) return 1.0f;
        float sorted[BASELINE_WINDOW];
        int n = historyCount;
        memcpy(sorted, history, n * sizeof(float));
        for (int i = 1; i < n; i++) {
            float key = sorted[i];
            int j = i - 1;
            while (j >= 0 && sorted[j] > key) { sorted[j + 1] = sorted[j]; j--; }
            sorted[j + 1] = key;
        }
        int idx = (int)(n * 0.75f);
        if (idx >= n) idx = n - 1;
        return sorted[idx];
    }

    void pushBlinkTimestamp(uint32_t nowMs) {
        if (blinkCount < MAX_BLINKS_TRACKED) {
            blinkTimestamps[blinkCount++] = nowMs;
        } else {
            memmove(blinkTimestamps, blinkTimestamps + 1,
                    (MAX_BLINKS_TRACKED - 1) * sizeof(uint32_t));
            blinkTimestamps[MAX_BLINKS_TRACKED - 1] = nowMs;
        }
    }

    // Returns true if this sample completed a blink event.
    bool update(float ear, uint32_t nowMs) {
        sampleIndex++;
        float base = baseline();

        history[historyHead] = ear;
        historyHead = (historyHead + 1) % BASELINE_WINDOW;
        if (historyCount < BASELINE_WINDOW) historyCount++;

        bool blinkEvent = false;
        if (sampleIndex > WARMUP_SAMPLES) {
            if (cooldownRemaining > 0) {
                cooldownRemaining--;
            } else {
                bool trigger = ear < base * EAR_RATIO_THRESH;
                if (trigger && !inBlinkRun) {
                    inBlinkRun = true;
                } else if (!trigger && inBlinkRun) {
                    inBlinkRun = false;
                    blinkEvent = true;
                    cooldownRemaining = COOLDOWN_SAMPLES;
                    pushBlinkTimestamp(nowMs);
                }
            }
        }
        return blinkEvent;
    }

    // 60-second rolling rate in blinks/minute (one blink event per minute
    // of trailing window == that many blinks/min by definition).
    float rollingRateBpm(uint32_t nowMs) {
        int evict = 0;
        while (evict < blinkCount && (nowMs - blinkTimestamps[evict]) > 60000) evict++;
        if (evict > 0) {
            memmove(blinkTimestamps, blinkTimestamps + evict,
                    (blinkCount - evict) * sizeof(uint32_t));
            blinkCount -= evict;
        }
        return (float)blinkCount;
    }
};

// ── HOG + linear eye-state classifier ────────────────────────────────────
// Judges one frame at a time: "is the eye in this crop shut?" The glint
// detector above needs the corneal reflection to vanish for >= 2 frames,
// but at the ~12 fps this hardware records, 13 of 17 hand-labelled blinks
// in session_101 showed only ONE fully-closed frame, and the glint was
// absent or unstable for most of that session (6 blinks found against
// ~70 labelled). A per-frame shape classifier has neither dependency.
//
// Pipeline: gray crop around the locked ROI -> boxResample to 32x64 ->
// hogFeatures (756 values: edge directions per 8x8 cell, L2-Hys normalised
// per 2x2-cell block) -> linearScore against trained weights -> threshold.
// The weights are trained on the host from features dumped by
// tools/session_replay, i.e. by THIS code, so host and device compute the
// same numbers. Cost per frame: ~2k gradients + 756 multiply-adds.
static const int HOG_W = 32, HOG_H = 64, HOG_CELL = 8, HOG_BINS = 9;
static const int HOG_CELLS_X = HOG_W / HOG_CELL, HOG_CELLS_Y = HOG_H / HOG_CELL;
static const int HOG_LEN = (HOG_CELLS_X - 1) * (HOG_CELLS_Y - 1) * 4 * HOG_BINS;  // 756

// Area-average resample: each output pixel is the rounded mean of the
// source pixels it covers. Handles non-integer ratios (the 90x180 QVGA crop
// -> 32x64), and unlike nearest-neighbour it doesn't alias the eyelashes.
inline void boxResample(const uint8_t *src, int sw, int sh, uint8_t *dst, int dw, int dh) {
    for (int oy = 0; oy < dh; oy++) {
        int y0 = oy * sh / dh, y1 = (oy + 1) * sh / dh;
        if (y1 <= y0) y1 = y0 + 1;
        for (int ox = 0; ox < dw; ox++) {
            int x0 = ox * sw / dw, x1 = (ox + 1) * sw / dw;
            if (x1 <= x0) x1 = x0 + 1;
            uint32_t sum = 0;
            for (int y = y0; y < y1; y++)
                for (int x = x0; x < x1; x++) sum += src[y * sw + x];
            uint32_t n = (uint32_t)(y1 - y0) * (uint32_t)(x1 - x0);
            dst[oy * dw + ox] = (uint8_t)((sum + n / 2) / n);
        }
    }
}

// img is HOG_W x HOG_H; out receives HOG_LEN floats. Unsigned orientations
// (0-180 deg: an edge's direction matters, not which side is brighter),
// hard-binned; blocks are 2x2 cells at a 1-cell stride.
inline void hogFeatures(const uint8_t *img, float *out) {
    // Static, not stack: 1.1 KB, and this runs inside the 8 KB CameraTask.
    // Not reentrant -- only one task processes frames.
    static float cells[HOG_CELLS_Y][HOG_CELLS_X][HOG_BINS];
    memset(cells, 0, sizeof(cells));
    const float RAD2BIN = (180.0f / 3.14159265f) / (180.0f / HOG_BINS);
    for (int y = 0; y < HOG_H; y++) {
        int ym = y > 0 ? y - 1 : 0, yp = y < HOG_H - 1 ? y + 1 : HOG_H - 1;
        for (int x = 0; x < HOG_W; x++) {
            int xm = x > 0 ? x - 1 : 0, xp = x < HOG_W - 1 ? x + 1 : HOG_W - 1;
            float gx = (float)img[y * HOG_W + xp] - (float)img[y * HOG_W + xm];
            float gy = (float)img[yp * HOG_W + x] - (float)img[ym * HOG_W + x];
            float mag = sqrtf(gx * gx + gy * gy);
            if (mag == 0.0f) continue;
            float b = atan2f(gy, gx) * RAD2BIN;       // -9..9 bins
            if (b < 0.0f) b += HOG_BINS;
            int bin = (int)b;
            if (bin >= HOG_BINS) bin -= HOG_BINS;     // exactly 180 deg == 0 deg
            cells[y / HOG_CELL][x / HOG_CELL][bin] += mag;
        }
    }
    // L2-Hys, with OpenCV's damping term so near-flat blocks (JPEG noise on
    // smooth skin) are not blown up to full strength.
    const int BLOCK = 4 * HOG_BINS;
    int o = 0;
    for (int by = 0; by < HOG_CELLS_Y - 1; by++) {
        for (int bx = 0; bx < HOG_CELLS_X - 1; bx++) {
            float *v = out + o;
            int k = 0;
            for (int cy = by; cy < by + 2; cy++)
                for (int cx = bx; cx < bx + 2; cx++)
                    for (int i = 0; i < HOG_BINS; i++) v[k++] = cells[cy][cx][i];
            float ss = 0.0f;
            for (int i = 0; i < BLOCK; i++) ss += v[i] * v[i];
            float s = 1.0f / (sqrtf(ss) + 0.1f * BLOCK);
            ss = 0.0f;
            for (int i = 0; i < BLOCK; i++) {
                v[i] *= s;
                if (v[i] > 0.2f) v[i] = 0.2f;
                ss += v[i] * v[i];
            }
            s = 1.0f / (sqrtf(ss) + 1e-3f);
            for (int i = 0; i < BLOCK; i++) v[i] *= s;
            o += BLOCK;
        }
    }
}

// Crop the classifier sees: centred on the locked ROI, tall enough to hold
// both lids. 90x180 at QVGA (ROI 48); scales with the ROI for VGA builds.
// The eye is portrait in frame because the camera is mounted beside it.
inline void hogCropRect(const RoiLock &roi, int &x, int &y, int &w, int &h) {
    w = roi.size * 15 / 8;
    h = 2 * w;
    x = roi.x + roi.size / 2 - w / 2;
    y = roi.y + roi.size / 2 - h / 2;
}

inline float linearScore(const float *f, const float *w, float bias) {
    float s = bias;
    for (int i = 0; i < HOG_LEN; i++) s += w[i] * f[i];
    return s;
}

// Turns per-frame "closed" scores into blink events. A blink is counted on
// the FIRST closed frame (no waiting for the eye to reopen), and a closure
// that re-crosses the threshold with fewer than REFRACTORY_FRAMES open frames
// in between is the same blink -- the online equivalent of the +-3-frame
// peak picking the classifier was evaluated with. A gated frame (exposure
// dropout, hand over the camera -- decided by the caller) never counts.
struct HogBlinkDetector {
    static const int REFRACTORY_FRAMES = 3;
    float threshold = 0.0f;
    int openRun = REFRACTORY_FRAMES;   // non-closed frames since the last closed one

    bool update(float score, bool gated) {
        if (gated || score <= threshold) {
            if (openRun < REFRACTORY_FRAMES) openRun++;
            return false;
        }
        bool isNew = openRun >= REFRACTORY_FRAMES;
        openRun = 0;
        return isNew;
    }
};

// Running open-eye template for the classifier (train_blink_bgsub.py). The model scores
//   f.w1 + (f - B).w2 + bias,   B = running average of recent frames' HOG vectors,
// which is linear, so the device keeps only the scalar s = B.w2 instead of the 756-float B:
//   score = f.(w1+w2) - s_prev + bias,   s = (1-alpha) s_prev + alpha (f.w2),   s starts at the first f.w2.
// Subtracting the template removes what differs between sessions (eye position in the crop, lighting,
// skin tone) and leaves what changes in a blink. A blink is ~5% of frames so it barely moves B.
struct HogBackground {
    float s = 0.0f;
    int   n = 0;                       // frames seen since reset()
    void reset() { s = 0.0f; n = 0; }
    // c = f.w2. Returns s_prev, the template term to subtract from f.(w1+w2); advances the average.
    float update(float c, float alpha) {
        float sPrev = (n == 0) ? c : s;
        s = (1.0f - alpha) * sPrev + alpha * c;
        if (n < 1000000) n++;
        return sPrev;
    }
    // True until the template has seen warmupFrames frames: detections are held off (the caller passes it as `gated`).
    bool settling(int warmupFrames) const { return n <= warmupFrames; }
};

// Rolling blink rate over the timestamps of counted blinks -- the blink_rate the
// fuzzy model takes. bpm() is the trailing-minute count (the glint detector's
// rollingRateBpm()); smoothedBpm() is what the device feeds the model.
//
// Why smoothed: a 60 s count is a small-number statistic. For a rider whose true rate
// is 9/min it drops below 8 in ~32% of windows on Poisson noise alone (below 6 in 12%),
// so Blink_Low kept switching on for an alert rider. Session 101 (hand-labelled, 71
// blinks in 9.4 min): per-minute counts 15, 6, 17, 5, 4, 8, 10, 2, 2. Over 3 minutes
// the same noise shrinks by sqrt(3), and a true 9/min rider vs a true 5/min rider
// (IICIP 2016 driving baseline vs fatigued) become separable.
struct BlinkRateWindow {
    static const int MAX_TRACKED = 128;   // 3 min at up to ~40 blinks/min (the old 60 capped the rate at 20)
    static const uint32_t SHORT_MS = 60000;
    static const uint32_t LONG_MS  = 180000;
    uint32_t ts[MAX_TRACKED] = {0};
    int n = 0;

    void push(uint32_t nowMs) {
        if (n == MAX_TRACKED) {
            memmove(ts, ts + 1, (MAX_TRACKED - 1) * sizeof(uint32_t));
            n--;
        }
        ts[n++] = nowMs;
    }

    int countWithin(uint32_t nowMs, uint32_t windowMs) const {
        int c = 0;
        for (int i = 0; i < n; i++) if ((uint32_t)(nowMs - ts[i]) <= windowMs) c++;
        return c;
    }

    // Blinks in the trailing minute.
    float bpm(uint32_t nowMs) const { return (float)countWithin(nowMs, SHORT_MS); }

    // Blinks/min over the last LONG_MS. Until that much time has passed since
    // sinceMs (the eye lock), the window is the time elapsed, but never under
    // SHORT_MS, so a young session does not read as a low rate.
    float smoothedBpm(uint32_t nowMs, uint32_t sinceMs) const {
        uint32_t w = nowMs - sinceMs;
        if (w > LONG_MS) w = LONG_MS;
        if (w < SHORT_MS) w = SHORT_MS;
        return (float)countWithin(nowMs, w) * 60000.0f / (float)w;
    }
};

}  // namespace EyeBlinkEAR
