walahow/IoT-Fatigue/(commit log)

2026-06-13 may be ready to be applied to helmet
    [ESP32-S3 WROOM cover V2.stl, PulSensor.stl, Untitled.blend, Untitled.stl, esp32-cam-bottom.step, esp32-cam-bottom.stl, esp32-cam-top.step, esp32-cam-top.stl]
2026-06-24 implement fuzzy fatigue logic, stabilize ESP32-S3 firmware, optimize live preview, and ignore large files
    [FuzzyFatigue.h, fuzzy_model.py, live_preview.py, main.cpp, test_firmware_serial.py]
2026-09-01 Add design spec for on-device fatigue detection + PC live view
    Documents the plan to port eye_ear.py's EAR blink detection to the
    ESP32 itself (via image moments instead of contour/ellipse-fit), so
    the fatigue alert reacts to real blinks without a PC, plus an optional
    PC live-view env for development/verification alongside SD recording.
2026-09-02 Add implementation plan for on-device blink detection
    Bite-sized TDD tasks for the EyeBlinkEAR module (Otsu threshold,
    moment-based EAR, ROI lock/drift, blink detector -- all host-tested
    via a new native PlatformIO env) plus its integration into main.cpp
    and on-hardware bring-up. Scoped to spec section 5 only; the PC
    live-view (section 6) gets its own plan later.
2026-09-02 Checkpoint in-progress firmware/pipeline improvements
    Buzzer mute flag + MPU auto-reconnect refactor (tryInitMPU()) in
    main.cpp, eye_ear.py's ROI lock/drift phase, debug_recorder.py's CSV
    row validation fix (was silently dropping every row), and related
    README/fuzzy_walkthrough doc updates. Checkpointing this pre-existing
    work so the on-device-blink-detection worktree branches from it.
    [debug_recorder.py, eye_ear.py, main.cpp, merge_session.py]
2026-09-02 Add native PlatformIO env for host-side firmware unit tests
    Lets the new EyeBlinkEAR module be unit tested on the host instead of
    needing real ESP32-S3 hardware for its pure math.
2026-09-02 Fix invalid pio command in Task 0's verify step
    pio project config doesn't accept an -e filter; caught during Task 0's
    spec-compliance review when the reviewer ran the exact command and it
    failed with "no such option: -e".
2026-09-02 Add Otsu threshold to EyeBlinkEAR with a host-side unit test
    First piece of the on-device EAR pipeline (spec section 5.1): pure,
    hardware-independent thresholding, verified without needing real ESP32
    hardware.
2026-09-02 Add centroid helper to EyeBlinkEAR
    Shared building block for both the boot-time ROI lock and the runtime
    drift check (spec 5.4) -- center of mass of a thresholded mask.
    [EyeBlinkEAR.h]
2026-09-02 Add median-based ROI boot lock to EyeBlinkEAR
    Spec 5.4's boot-lock mechanism: median of N frame centroids, robust to
    an occasional bad single-frame detection -- mirrors eye_ear.py's
    median-of-30-Haar-detections lock, without needing Haar/ML on-device.
2026-09-02 Add runtime drift correction to EyeBlinkEAR
    Spec 5.4's drift-check mechanism: small shifts get EMA-blended in,
    large jumps are ignored as noise -- mirrors eye_ear.py's
    DRIFT_MAX_PX-gated Haar recheck, without needing Haar/ML on-device.
    [EyeBlinkEAR.h]
2026-09-02 Add blink detector with baseline, cooldown, and rolling rate
    Completes EyeBlinkEAR.h (spec 5.5): adaptive-baseline blink detection
    and a 60s rolling blinks/minute rate, ported from eye_ear.py's logic.
    The module is now fully unit tested on the host with no ESP32 hardware
    needed -- 14 tests covering thresholding, EAR, ROI lock/drift, and
    blink detection.
    [EyeBlinkEAR.h]
2026-09-02 Wire EyeBlinkEAR into main.cpp for SD-mode on-device blink detection
    Decodes each throttled captured JPEG (fmt2rgb888), runs it through
    EyeBlinkEAR's boot-lock/drift/EAR/blink pipeline, and feeds the
    resulting rolling blink rate into the g_blinkRate fallback that the
    fuzzy risk engine already consumes -- replacing the hardcoded 13.0
    stub in SD mode. USB debug mode (esp32s3cam) is untouched.
    [main.cpp]
2026-09-02 Fix crash-loop on partial EAR buffer allocation failure
    Code review found that processEarFrame()'s allocation re-entry guard
    only checked g_earRgbBuf (the first of three PSRAM buffers). If that
    one succeeded but g_earGrayBuf or g_earMaskBuf failed -- plausible
    under PSRAM fragmentation with camera/SD writes competing for the
    same heap -- every subsequent call would skip the allocation block
    entirely and write through the still-null pointer, crash-looping the
    camera task. A one-shot g_earDisabled flag (mirroring the existing
    g_sdReady pattern) now gates all EAR processing after a single failed
    allocation attempt, whether partial or total, and stops the failed
    malloc from being retried every t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
    [main.cpp]
2026-09-02 Fix PSRAM not initializing on esp32s3cam_sd (real hardware)
    Hardware bring-up (Task 8) found processEarFrame()'s PSRAM allocation
    failing outright on the real board -- not a fragmentation issue, but
    psramFound() returning false entirely, silently falling the camera
    back to QVGA/internal-DRAM despite -DBOARD_HAS_PSRAM and VGA being
    configured. Root cause: board_build.arduino.memory_type was unset for
    esp32s3cam_sd, unlike esp32s3cam_test_sd which already had
    qio_opi set. Adding it here fixes PSRAM init (verified on hardware:
    ~8MB free afterward, camera now genuinely captures at VGA, EAR buffer
    allocation succeeds) -- a pre-existing gap in this env's config, not
    something introduced by the on-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
2026-09-02 Fix silent PSRAM fallback on esp32s3cam and esp32s3cam_sd envs
    Both envs lost board_build.arduino.memory_type = qio_opi (replaced by
    board_build.flash_mode = dio) in a prior "testing" commit, and esp32s3cam
    also lost -DBOARD_HAS_PSRAM. Without BOTH set, the Arduino core's
    esp32-hal-psram.h #undefs CONFIG_SPIRAM/CONFIG_SPIRAM_SUPPORT even when
    the qio_opi variant is linked, so psramFound() silently returns false and
    main.cpp's setup() falls back to FRAMESIZE_QVGA in DRAM (only a
    "#WARN: No PSRAM" serial line marks it).
    Verified live on hardware (Freenove ESP32-S3-WROOM CAM, COM3):
    - Before fix: boot log printed "#WARN: No PSRAM - falling back to QVGA"
    for esp32s3cam; frames captured via de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
2026-09-03 Add windowed darkest-density pupil localization to EyeBlinkEAR
    Retrospective validation against a real recorded session
    (sessions/session_023) found the existing centroid()-based boot-lock
    landing off the eye entirely -- a big diffuse cheek-shadow region
    outweighed the much smaller, genuinely-dark pupil in a plain
    centroid, and at strict thresholds the pupil itself fragments into
    several small disconnected speckles (JPEG noise) that lose individually
    to noise elsewhere in the frame.
    findDarkestWindow() fixes both problems with one primitive: a
    separable box-filter search for the winSize x winSize window with the
    most "on" pixels, refined to that window's own centroid. It naturally
    prefers a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
    [EyeBlinkEAR.h]
2026-09-03 Add percentile threshold to EyeBlinkEAR for pupil localization
    Otsu's ~50/50 split is the right tool for the EAR computation step
    (splitting an already-tightly-cropped eye region into open-pupil vs
    closed-eyelid), but the wrong tool for locating the pupil in a wider
    search window in the first place -- validated against session_023
    that it lets a large diffuse shadow region dominate the much smaller,
    genuinely-darker pupil. percentileThreshold() isolates only the
    darkest N% of pixels instead, which is what findDarkestWindow's
    scoring was actually validated against in the Python prototype.
    [EyeBlinkEAR.h]
2026-09-03 Add session_replay host validation tool and wire in the new lock
    Host-side harness that runs the exact, unmodified EyeBlinkEAR.h
    algorithm (same source the ESP32 compiles) against a folder of
    already-recorded JPEG frames, replicating processEarFrame()'s logic
    from main.cpp -- used to retrospectively validate against real footage
    (sessions/session_023) before touching production firmware.
    Also updates the tool's boot-lock/drift-check to use the new
    percentileThreshold()/findDarkestWindow() primitives instead of
    otsuThreshold()/centroid(), full-frame search instead of assuming the
    eye is centered, more samples (60) collected unthrottled (every
    captured frame, not every 3rd) since there's no r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
2026-09-03 Fix drift-check noise; disable drift for now (occlusion gap found)
    Retrospective validation against session_023 found the drift-check
    never moved the ROI once across the full 9-minute session: a single
    findDarkestWindow sample every ~6s was too noisy to ever pass the
    shift gate (every single-frame sample landed 20-70px away purely from
    search noise). Same fix as the boot-lock: gather a burst of 8 samples
    and use their median instead of trusting one frame.
    That fixed the noise, but surfaced a real, different problem: once
    confirmed by two independent agreeing bursts (raising confidence
    appropriately -- a single large jump still gets rejected as likely
    noise, but two independent bursts agreei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
2026-09-04 Replace shape-based blink detection with a three-cue glint detector
    The on-device blink detector never worked. Retrospective validation against
    real recorded sessions showed every shape-based metric tried -- whole-mask
    image moments, largest-connected-component moments, and true contour +
    cv2.fitEllipse -- was dominated by lighting gradients across the curved iris
    and by which crop edge the thresholded region happened to touch, not by
    eyelid state. All of them fired on a wide-open eye. On session_040 the
    achieved EAR floor never moved below ~0.29 regardless of ROI size, throttle
    rate, or which of the three metrics was used.
    Replace it with a cue the failure modes above don't affect: the cor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
    [EyeBlinkEAR.h, main.cpp]
2026-09-06 Add hardware sensor test suite for pre-flight validation
    Adds a standalone sensor_test PlatformIO env that exercises pulse,
    IMU, and camera sensors independently on real hardware before
    flashing the full firmware, plus run scripts and a result analyzer
    to grade pass/warning/fail per sensor.
    [analyze_sensor_test.py, sensor_test.cpp]
2026-09-08 Fix IMU calibration overflow and I2C bus wedging in sensor test
    The IMU section reported a healthy MPU-6050 as "not detected" and
    silently produced garbage calibration offsets. Both were confirmed
    against hardware: ESP32-S3 CAM with a GY-521 (clone MPU-6050,
    WHO_AM_I 0x74) on GPIO2/GPIO3.
    int16_t accumulator overflow in calibration
    Summing 100 raw accel samples reaches ~1.6e6, wrapping int16_t
    (max 32767) many times over. Measured: az_off reported 273 when the
    true mean was ~2894 -- 100*2894 mod 65536 / 100 = 272.6, an exact
    match. The consequence was that the +4.2 dps gyro-X bias documented
    for this chip survived "calibration" untouched: post-cal GX read
    +4.0..+6.3 dps instead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
    [sensor_test.cpp]
2026-09-08 Gate recording behind an arming phase; rotate sessions per cycle
    The button flipped g_sessionActive directly, so recording began whether or
    not the eye ROI was locked, an HR baseline existed, or the IMU was
    calibrated for the pose the helmet was actually in. A session captured that
    way cannot be used for training and there was nothing afterward to say so.
    Flow
    IDLE --press--> ARMING --all ready | timeout--> RECORDING --press--> IDLE
    | (closeSession)
    +--press = abort--> IDLE
    g_sessionActive is retained as a flag derived from the state, so the five
    existing consumers are unchanged.
    ARMING resets and then waits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
    [main.cpp]
2026-09-08 Add ROI pinning to session_replay and a session review video tool
    Investigating session_100 needed two things the repo did not have: a way to
    run the blink pipeline against a known-good ROI, and a way to look at a
    session rather than read its CSVs.
    session_replay --roi=X,Y pins the ROI centre and skips localization,
    mirroring the firmware's EAR_ROI_MANUAL_X/Y build flags. This separates two
    failures that otherwise look identical from the outside: a blink detector
    that does not work, and a localizer that pointed it at the wrong part of the
    frame. On session_100 that distinction was the whole finding -- the shipped
    localizer locked the ROI onto a specular flare in the top-left corner and
    repo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
    [session_review_video.py]
2026-09-08 Version the eye localizer; fix the lock window that lost session_100
    session_100 recorded 0 blinks across 55 s of footage containing obvious
    blinks. The ROI had locked 252 px from the pupil, onto a corner of the frame.
    The localizer is now explicitly versioned so a change can be measured rather
    than argued about. MotionLocatorV1 is the shipped implementation, frozen
    byte-identical as the regression baseline. MotionLocatorV2 derives from it.
    EAR_LOCALIZER_VERSION selects one; call sites use the MotionLocator alias and
    did not change. Future versions derive from v2 the same way.
    WHAT V2 CHANGES
    Reject a peak whose ROI would not fit inside the frame, instead of clamping
    it inward. v1 handed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
    [EyeBlinkEAR.h, main.cpp]
2026-09-08 Take the review video title from the session folder
    The title was the literal string "SESSION 100", so every other session
    rendered with the wrong label -- session_067 came out titled SESSION 100.
    [session_review_video.py]
2026-09-08 Make review video resolution-aware; allow ROI size and frame stride
    The video script assumed QVGA and drew a 48 px ROI, so a VGA session
    (session_040) rendered on a broken canvas with a box a quarter of the right
    area. Geometry now comes from the footage.
    EAR_ROI_SIZE in session_replay is overridable so VGA recordings can be
    replayed at 96, which is the same physical eye area 48 covers at QVGA. On
    session_040 that is the difference between the pupil sitting outside the ROI
    and inside it -- the localizer picks the identical centre (404,308) either
    way, so the miss was the ROI extent, not the lock.
    A frame stride keeps long sessions watchable: session_023 is nine minutes at
    20 fps. Timeline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
    [session_review_video.py]
2026-09-08 Add localizer v3: measure the lock window in time, not frames
    v2 waits for a fixed frame COUNT, and nothing in that path consults a clock.
    The window's real duration is therefore set by whatever frame rate the camera
    achieves, which varies with EAR decode cost and SD write load. Across the
    recorded sessions 240 frames means:
    session_023 20.0 fps -> 12.0 s -> ~2.8 blinks in the window
    session_100 11.9 fps -> 20.2 s -> ~4.7 blinks
    session_067 11.8 fps -> 20.3 s -> ~4.7 blinks
    session_040 7.9 fps -> 30.4 s -> ~7.1 blinks, over half the session
    The quantity the localizer depends on is blinks in the window -- that was the
    whole session_100 diagnosis, that one blink cannot b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
    [EyeBlinkEAR.h, main.cpp]
2026-09-08 Seed the blink detector's open-eye baselines from a median, not one frame
    GlintBlinkDetector gave different blink counts from identical inputs
    depending on which frame it happened to start on. On session_100, with the
    ROI fixed and only the start frame varied across a 28-frame span, the count
    swung between 2 and 9.
    CAUSE
    Both open-eye references were seeded from a SINGLE frame:
    if (openBrightness < 0.0f) openBrightness = (float)roiBrightness;
    else openBrightness += OPEN_BRIGHTNESS_ALPHA * (...);
    with OPEN_BRIGHTNESS_ALPHA = 0.05, so a seed persists for roughly twenty
    frames. Both gates that consume them are tight -- a blink must beat
    openBrightness by MIN_BRIGHTEN = 3 grey levels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
    [EyeBlinkEAR.h]
2026-09-08 Show both blink series in the review video
    The timeline only ever plotted blinks from the pinned-ROI reference run, so
    the video could not show what the shipped pipeline actually detected. It now
    draws both: detections at the locked ROI against the same detector with the
    ROI placed on the pupil by hand.
    On session_100 that gap is the point -- v3 locks 12 px off the pupil and the
    detector honestly reports 2 blinks where the pinned reference finds 12. The
    frame flash and the panel now follow the locked run, which is what ships.
2026-09-08 Add localizer v4: re-centre the locked ROI on the corneal glint
    Motion energy peaks on the eyelid, because the lid is what moves. Across
    sessions 023/040/067/100 the locked centre lands 9-18 px from the pupil in
    every one -- a consistent offset, not scatter. The detector's cues are means
    and fractions over the crop, so a pupil near the edge of the box weakens both
    of them.
    v4 derives from v3 and re-centres once, after the lock, onto the brightest
    small cluster near the peak. The glint sits ON the cornea, so it identifies
    the eye itself rather than something merely near it.
    v1 3/4 locks mean error 74.6 px
    v2 3/4 mean error 14.4 px
    v3 4/4 mean error 12.8 p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
    [EyeBlinkEAR.h, main.cpp]
2026-09-08 Widen the blink detector's pupil-gone gate, which was clipping real blinks
    Post-lock blink recall sat at 15 of 30 against a pinned-ROI reference, and
    localizer v4 showed the shortfall was not the ROI position: session_067 locks
    2.2 px from the pupil and still missed 3 of 9. So the loss had to be in the
    cues, and this finds which one.
    DIAGNOSIS BEFORE TUNING
    GlintBlinkDetector now records, for every glint-absent run of plausible
    duration, whether each cue passed and the values behind it (~24 bytes;
    session_replay dumps them as CSV columns). Without that a missed blink is
    indistinguishable from a blink the glint cue never noticed, and picking
    thresholds is guesswork. Sorting the 13 missed re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
    [EyeBlinkEAR.h]
2026-09-09 Take the serial mutex for EAR status output, and report lock progress
    In USB mode the camera task streams binary JPEG frames and sendJpegFrame()
    takes g_serialMutex around each one. The EAR pipeline's own Serial.printf
    calls did not, so its status lines were routinely cut in half by frame bytes
    landing mid-write:
    EAR ROI motion-locked at x=204 y=94 size=48 conf=2.31 (1 tries)...c....JFIF
    live_ear_preview.py matches those lines with a regex, so a shredded one never
    matched. Across two live preview sessions totalling nine minutes the tool
    showed no lock, no rejection, and no blink events, which read as a completely
    dead eye pipeline. It was not dead. A capture of the raw stream shows it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
2026-09-09 Add session_summary.py: what a session actually contains, before processing it
    Answers "did this session give us anything" from sensor_data.csv alone, so a
    recording can be judged before spending time unpacking frames and rendering
    video. Reports each channel's distribution, its trend across thirds, and the
    checks that decide whether the session can be used as training data.
    On session_101 it surfaced in one run that heart rate held 100% contact with a
    real -1.59 bpm/min decline, that head movement rose 44% over the same period --
    the opposite of what drowsiness predicts -- and that the session's 44% CRITICAL
    fatigue score was being produced by a blink channel stuck near zero.
    That last ch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
    [session_summary.py]
2026-09-10 Document new firmware envs and blink-debug tools in README
    Adds sections for esp32s3cam_ear_preview/esp32s3cam_frame_inject envs,
    live_view.py, live_ear_preview.py, frame_inject_replay.py, and
    label_session.py. Replaces the garbled placeholder root README with a
    short pointer to the full guide.
2026-09-10 Add on-device blink debug tools: live_ear_preview, frame_inject_replay, label_session
    live_ear_preview.py overlays the ESP's own EAR/glint ROI-lock and blink
    events on the live USB video feed. frame_inject_replay.py replays
    previously-recorded frames through the real firmware for regression
    comparison against tools/session_replay. label_session.py attaches a
    KSS score to a recorded SD-card session's CSV.
2026-09-22 Fix fuzzy-model blink/HR bugs, add nod/HR/alert-gate safeguards
    - FuzzyFatigue.h / fuzzy_model.py: fix mf_blink_Low(0)==0 hole (left
    edge -inf, not 0) that read "zero blinks" as Safe instead of Low;
    widen and re-anchor the Low ramp (3..7, was 0/0/4/8) against
    session_101's hand-labelled riding blink rate and Poisson noise on
    a 60 s window; add a blink_valid flag so the FIS ignores blink
    rules entirely when the channel can't see the eye; add a 0.25
    minimum firing strength (alpha-cut) so a rule barely above its
    membership's zero point no longer produces full Critical risk;
    gate nodding_score on gyro_Stable (nod_trusted) so a road bump's
    pitch jolt isn't scored as a nod -- con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
    [AlertGate.h, EyeBlinkEAR.h, FuzzyFatigue.h, HrBaseline.h, NodDetector.h, frame_inject_replay.py]
2026-09-22 Ignore top-level sessions/ (raw ride data, frames, video)
2026-09-22 Add motion-based drift correction, reusing the boot lock
    main.cpp: earDriftTick() replaces the disabled Otsu/centroid drift check
    with the boot lock's own motion-energy search (EyeBlinkEAR::MotionLocator),
    scoped to a small window around the current ROI instead of the whole frame.
    Darkness-based drift correction was disabled because it could confidently
    re-lock onto hair -- a genuinely darker, more stable feature than a
    blinking eye -- which is the exact failure mode the motion-energy boot
    lock itself was built to fix. This reuses that fix instead of reinventing
    a darkness-based version.
    State cost is a single-byte enum: g_earLocator and the v4 glint-refine
    buffers are idle once locked, so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
    [frame_inject_replay.py, main.cpp]
2026-09-22 Add phone arming preview design spec
    Wi-Fi AP + page served by the SD build: live arming checklist, camera
    frame with the ESP's eye box, tap-to-set eye ROI, optional blink test,
    ARM/ABORT as a second path to sessionButtonPress(). Wi-Fi off 15 s into
    recording.
2026-09-22 Add phone arming preview implementation plan; tighten spec
    Spec now states the four requirements explicitly (button unchanged, blink
    test optional, ESP's eye box shown, tap-to-place), fixes HR baseline to
    n/30 and drops the unused `eye` status field.
2026-09-22 Route serial commands through handleCommandLine(), add g_earHogBlinkTotal
    No behaviour change. Prepares a second caller (the phone page) that must
    take exactly the serial path, and a blink counter that is never reset.
    [main.cpp]
2026-09-22 Add the phone arming page and a node check of its pure logic
    Tap -> camera coordinate map, hogCropRect mirror, and the optional
    blink test (a port of live_ear_preview.py --arm) with its verdict.
2026-09-22 Add PhonePreview: WPA2 AP + esp_http_server on the SD build
    Serves the page, a status string, the latest frame and a one-slot command
    queue. Holds no firmware state; main.cpp wires it up next.
2026-09-22 Address Task 3 code review: TX power, NVS writes, httpd timeouts, secret pass
    - Set Wi-Fi TX power via esp_wifi_set_max_tx_power() directly instead of
    WiFi.setTxPower(), which silently no-ops this soon after softAP(); report
    the readback in the "Phone preview up" line.
    - WiFi.persistent(false) before mode(WIFI_AP), and drop softAPdisconnect(true)
    in stop(), so start/stop no longer writes NVS on every recording.
    - httpd send/recv wait timeouts down to 2 s so stop() can't block loop() for
    the 5 s default, and a 6 KB handler stack.
    - stop() clears any command queued just before it, so it can't fire after
    the ride.
    - Report largest internal DMA block alongside free heap for Task 5.
    - P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
    [PhonePreview.h]
2026-09-22 Plan/spec: Task 3 review follow-ups
    Password from HELMET_AP_PASS (repo is public), stop() timing logged and
    described as >=100 ms, frame curl on one line, within-session pulse A/B
    and heap-across-rides checks for the bench.
2026-09-22 Wire the phone preview: frames, status JSON, commands, Wi-Fi lifecycle
    Page commands go through handleCommandLine() on loop()'s task, same as
    serial. Frames only outside RECORDING; Wi-Fi off 15 s into a recording,
    back on at IDLE.
2026-09-22 Fix instant arming timeout when the button press straddles a millisecond
    now = millis() is taken at the top of loop(); a physical-button press
    later in the same pass calls armingBegin(), which sets g_armStartMs to
    its own, later millis() (possibly now + 1). The ARMING block then computed
    now - g_armStartMs as unsigned, which underflowed to ~4294967295 >=
    ARMING_TIMEOUT_MS and recorded instantly with timed_out=1 and every
    readiness flag still 0. Use a signed elapsed instead, same style as the
    existing eye-check compare a few lines up.
    [main.cpp]
2026-09-22 Phone preview: review follow-ups
    buildPhoneStatus clamps arm_s the same way the ARMING block clamps its
    own elapsed time; roi[] gets headroom so three large ints can never
    truncate into invalid JSON; a static_assert ties PHONE_STATE_NAME to
    SessionState so an added state can't leave it stale; phoneTick times its
    IDLE restart the same way stop() is timed; and the page no longer nags
    to rerun the blink test while the helmet is ARMING, since arming drops
    and re-acquires the ROI by design.
    [main.cpp]
2026-09-22 Stop tracking compile_commands.json
    Regenerating it for esp32s3cam_sd (pio run -t compiledb) would write
    -DPHONE_AP_PASS=... from HELMET_AP_PASS into it in plain text; the repo
    is public. Local copies keep working for IntelliSense.
2026-09-22 EAR: don't start the eye-check window from a frame whose lock was dropped
2026-09-23 Blink classifier: ROI-jitter training augmentation
    The HOG blink classifier was trained on session_101 at one exact ROI
    framing. A moving box (drift correction, a re-tapped eye box) never
    lands on that exact framing, and the classifier turned out to be far
    more position-brittle than expected: an 8px shift swung recall from
    9/10 to 4/10 blinks on held-out session_116 footage.
    session_replay.cpp: --hog-jitter=N,J dumps N extra HOG-feature copies
    per labelled frame, each computed from the ROI shifted by a random
    +-J px offset (deterministic per-frame seed, so a re-run reproduces
    exactly). Jitter is training-time only -- the eval/scoring path
    (--hog-model/--hog-csv) is untouched.
    train_blink_c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
    [train_blink_classifier.py]
2026-09-23 Add handout.md for continuing blink-classifier work on another device
    Branch, findings, and the record -> label -> retrain -> verify workflow,
    so the next session (this machine or another) doesn't have to
    rediscover what today's investigation already ruled out (naive 116
    pooling, lowering the drift confidence gate, disabling drift
    correction).
2026-09-24 handout.md: record esp32s3cam_sd build/flash/boot results
    pio run -e esp32s3cam_sd now confirmed from clean main; flashed and booted:
    camera/PSRAM/IMU OK, SD mounted (30 GB, 28.9 GB free), idle awaiting arm,
    phone preview up per firmware log, HOG blinks firing, eye check passed on
    the reseated camera. Notes the stale-stored-eye-coordinate gotcha (NVS
    survives reflash) and that pulse-less arming times out to armed_hr=0.
2026-09-24 Add hand-labeled blink states for session_119 (full 17,100 frames)
    Force-added despite the sessions/ gitignore rule so it can be picked up
    on another device for continued blink-classifier work.
    [blink_labels.csv]
2026-09-24 Retrain blink classifier on session_119, support windowed hand labels
    train_blink_classifier.py assumed blink_labels.csv covered every frame
    contiguously from the eye lock onward (how session_101 was labeled).
    Sparse, windowed labeling (session_119: 7 hand-picked 30s windows) broke
    that assumption, so hand labels are now matched by frame_idx instead of
    assumed to align with row position, and only dumped frames that actually
    have a label are scored.
    Also fixes write_header() emitting invalid C++ float literals like "0f"
    for whole-number thresholds (needs a decimal point) -- caught by an
    actual PlatformIO build, not just inspection.
    BlinkWeights.h is now trained on session_119 (69% recall /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
    [train_blink_classifier.py]
2026-09-24 mjpeg_to_mp4.py: overlay logged blink events on the rendered video
    Flashes a red border + BLINK tag and a running count on frames within
    350ms of a blink_events.csv timestamp, on by default when that file
    exists. Lets the on-device blink detector's output be checked against
    the footage by eye without building session_replay.exe.
2026-09-24 Disable phone arming preview Wi-Fi for now (pure recording sessions)
    Wi-Fi during arming and the first 15s of recording can put RF noise on
    the pulse/HR signal, and shutting the httpd down at the 15s mark blocks
    loop() for up to ~2s -- costing 50+ pulse samples, since 500Hz pulse
    sampling runs in loop() too. Not needed while just recording without the
    phone UI. Commented out rather than deleted so it's a one-line
    uncomment to bring back.
2026-09-25 Blink classifier: aligned eye crops, pooled 119+121+122 model, phone Wi-Fi off after arming
    Training crops were centred wherever session_replay's own motion lock landed, 40-60 px
    off the eye and differently in every session, so models did not transfer between
    sessions of the same rider. make_roi_track.py now tracks one anatomical eye point
    through each session (template match against a reference median frame, weak windows
    dropped, 5-window median); session_replay --roi-track steers the HOG crop along it and
    train_blink_classifier.replay() uses a session's roi_track.csv automatically. Median
    distance from crop centre to the eye in single frames: 39-58 px before, 4 px after.
    Retrained without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
2026-09-25 Session labels and eye tracks for 119, 121, 122
    Hand-labelled blinks (closed / squint / open / unsure), force-added past the sessions/
    gitignore so training can be reproduced on another machine.
    - 121, 122: frame-by-frame sweep of every frame, no model in the loop (130 and 108 blinks).
    - 119: relabelled from model-candidate review, partial blinks counted (126 blinks). Its
    CSV rows are stored as 14 out-of-order blocks; frame_idx is the true order.
    - roi_track.csv: measured eye centre per window (make_roi_track.py), used by --roi-track.
    [blink_labels.csv, roi_track.csv]
2026-09-25 Blink classifier: train for the device crop with class weight 1 (fixes over-counting and the threshold cliff)
    The pooled model used class weight 20, which squeezes scores into a narrow band above the
    SVM margin. Fitted on all data it sat on a cliff: on session 122 with the helmet's fixed
    stored ROI, threshold 1.0 gave 16 blinks/min (true 6.2), 1.25 gave 3/min, 1.5 gave 0.2.
    train_blink_devicelike.py trains on aligned + fixed-ROI (device-like) crops and picks class
    weight/threshold by leave-one-session-out, testing on the held-out session's fixed-ROI crops.
    Class weight 1, threshold -0.25: mean F1 0.64, detected/true rate 1.0 on all three unseen
    sessions (119: 0.41, 121: 0.78, 122: 0.72), an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
    [make_sim_video.py, train_blink_devicelike.py]
2026-09-26 Blink classifier: running open-eye template (frame - EMA), +0.06 held-out F1
    The classifier now scores [f, f - B] where B is a running average of recent HOG vectors
    (alpha 0.05, ~2 s), i.e. the rider's open-eye look right now. Subtracting it removes what
    differs between sessions (eye position in the crop, lighting) and keeps what changes in a
    blink. Leave-one-session-out on fixed-ROI (helmet-like) crops, class weight 1, threshold
    -0.25: mean F1 0.693 vs 0.637 for the single-frame model (119: 0.52 vs 0.41, 121: 0.80 vs
    0.78, 122: 0.76 vs 0.72), with no threshold cliff (F1 0.67-0.68 at +-0.25).
    It is linear, so the device needs two dot products per frame and ONE float of state:
    score = f.(w1+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
    [EyeBlinkEAR.h, main.cpp, train_blink_bgsub.py]
2026-09-26 Add Gemini/Antigravity handoff docs; fix sim video and trainer provenance
    Carries the project knowledge built up over Claude Code sessions into files any
    agent can read:
    - GEMINI.md: auto-loaded project context (state, hardware, tools, gotchas).
    - docs/LABELING.md: fatigue (KSS) and per-frame blink labelling conventions.
    - docs/TRAINING.md: training/shipping the blink classifier, tuning the FIS,
    and the table of ideas already tried that failed.
    - docs/ROADMAP.md: prioritized further development.
    - docs/claude-handoff/: Claude's session notebook and session readout pages.
    Tooling:
    - sweep_sheets.py: contact sheets for model-free blink labelling, plus a
    writer for blink_labels.csv (rebuil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
    [make_sim_video.py, sweep_sheets.py, train_blink_bgsub.py]
